Eten0721/PassionFruit_IoT_hardware/docs/CAPTURE_SPEC.md

# 拍攝、檢測與分類規格

## 目標與範圍

本文是系統架構、拍攝、檢測、分類流程、API、command ID、GPIO、角度與 timing 的唯一規格；涵蓋使用硬體與純拍攝兩種拍攝方式，以及蒐集模式的人工分類與自動檢測模式的 YOLO 檢測、XGBoost 判級。現況見 [CURRENT_STATUS.md](CURRENT_STATUS.md)，決策歷史見 [ADR](adr/README.md)。

硬體由 Django 中央狀態機、ESP32、XINHUI `60KG` 分槽送料、HC-SR04、手機單站拍攝、三顆 MG996R 閘門與一顆 MG996R 下置式分類器組成。每顆果實在三個站點各保存一張照片；第 3 張保存後停在 Gate 3，等判級完成、分類器就位才放行，分類完成後才送下一顆。

## 架構與不變原則

### 模組分工

- Django 是 capture、送料與分類狀態的唯一來源，負責工作階段、拍攝 token、照片原子保存、單一 motor command slot 與錯誤復原；不主動呼叫硬體。
- `views.py`：HTTP 整合、模式選擇、狀態機協調與復原決策。
- `runtime_state.py`、`capture_timing.py`、`capture_session.py`、`api_payloads.py`、`webrtc_signaling.py`：各自獨立的狀態、timing、工作階段、回應格式與預覽 signaling。
- `dataset_store.py`：Dataset 檔案生命週期與 recovery marker 讀寫驗證。
- `detection.py`：四模型推論、`result.json`／檢測總表保存與人工接手寫回。`grading.py`：兩階段 XGBoost 特徵與最差視角判級。兩者只回結構化結果，不接觸硬體。
- `notification.py`：加工果通知文字與合成圖。`notification_delivery.py`：持久待送，背景經 Cloudinary／LINE 發送，失敗不影響本地流程。
- Firmware 位於 `firmware/Three_Gate_Data_Collection/`；`.ino` 只建立 `CaptureController` 並呼叫 `begin()`／`tick()`，感測、閘門、分類器、HTTPS 與流程控制分屬各模組。ESP32 是 HTTPS client，所有等待與 retry 都有界，不得阻塞主迴圈。
- 手機頁只負責預覽、相機 readiness、領取單站拍攝請求與上傳；Dashboard 負責運轉控制、狀態、照片檢查、判級與刪除。WebRTC 預覽失敗不得阻塞上傳。

### 不變原則

- 手機與 ESP32 不自行推測流程完成，一律以 Django 為準。
- 當站照片原子保存成功前，不放行下一閘門。
- 第 3 張保存後不直接放行 Gate 3；須有 `gate3_sorter_v1` 且分類器完成就位等待。
- 分類器就位、Gate 3 放行與歸位是同一個 `classify_fruit` 動作；結果不確定時不自動重放。
- 資料先提交再實體分類；硬體失敗不回滾照片、metadata 或 counter。
- 未分類資料、active capture 或 sorter 動作存在時，不開始下一顆。
- 送料由 HC-SR04 回授停止；感測異常或逾時由 ESP32 本機停止；網路 retry 不得重複送料。
- 優雅暫停只禁止後續送料，已送出的果實照常完成。
- 首站加速只縮短控制往返，不縮短停穩或照片保存交握。
- HTTP timeout 視為結果不確定，retry 必須冪等。
- 正式硬體流程沒有通用 manual capture；重拍只重跑同一顆的三站流程。純拍攝全程不建立 motor command。
- AI 只輸出結構化結果，不直接控制 GPIO、角度或 PWM。
- 檢測或判級失敗時不補零硬判；人工結果另記來源，不改寫模型輸出。
- 供電、邏輯電壓與共地安全優先於持續運轉。

## 名詞

- Capture session：一顆果實從觸發至三張照片保存完成的工作階段，包含硬體三站與純拍攝。
- Station ready：ESP32 宣告果實已在指定站點停穩。
- Capture request：Django 通知手機拍攝指定站點。
- Upload complete：Django 驗證並原子保存指定照片。
- 自動運轉：操作員啟用後，Django 只在安全邊界建立下一次送料命令的運轉模式；Django 或 ESP32 重新啟動後不自動恢復。
- 一體式送料筒：同一個圓筒同時提供百香果儲存、底部撥料與側面出料空間；目標內徑為 `20～22 cm`、內部高度為 `30 cm`。
- 分槽送料盤：直立於送料筒底部中央的 XINHUI `60KG` 連續旋轉伺服帶動扭蛋機式分槽盤，將分隔後的果實送向側面出口；槽數、槽寬與盤片間隙由實機驗證決定。
- 出口擋板：位於側面出口上方、限制多顆果實同時靠近出口的固定件；下緣距底板 `9 cm`、向筒內延伸 `9 cm`，側面出口寬度為 `9 cm`。
- 送料循環：XINHUI 連續旋轉伺服從開始驅動至停止的一次 `feed_one` 實體動作；成功契約是實體恰好送出一顆，不以固定角度判定。HC-SR04 只確認有果實抵達，不能計數。
- 感測區清空：HC-SR04 取得一次有效且大於 `8.0 cm` 的距離；`0 cm`／Echo timeout 不是清空。
- 果實抵達確認：送料期間 HC-SR04 取得一次有效且小於等於 `6.0 cm` 的距離；同一筆讀值正常終止送料並啟動首站流程。
- 送料安全逾時：`feeder_max_run_ms` 先於果實抵達確認到期；ESP32 立即停止馬達，Django 暫停自動送料且不得自動補轉。
- 進料未確認：送料因安全逾時、重新啟動或不確定結果停止，但 HC-SR04 尚未確認果實抵達；不得推測為料斗已空。
- 優雅暫停：立即禁止建立後續送料命令，已承諾送出的目前果實仍完成拍攝與實體分類。
- Gate 3 等待分類：第 3 張照片已保存，但 Gate 3 保持 Home、果實仍留在第 3 站，等待 `classify_fruit`。
- Motor command：`feed_one`、`start_sequence`、`release_gate` 或 `classify_fruit`；`release_gate` 以 `station_index` 區分第 1、2 站。
- Command slot：送料、Capture 與 sorter 共用的單一命令槽。

## 裝置網路連線目標

本節為 2026-10-10 討論已接受的需求，Django 與 Firmware 已依此實作；架構取捨見 [ADR-0018](adr/0018-local-network-onboarding.md)，實機驗收狀態見 [CURRENT_STATUS.md](CURRENT_STATUS.md)。

### 部署與日常啟動

- 新電腦首次部署要求可連上網際網路，並自動下載、安裝所需套件；安裝工具與套件封裝另行設計。
- 部署完成後，日常啟動、ESP32 控制、手機拍攝與更換 Wi-Fi 的設定都須能在沒有網際網路的區域網路完成。
- 電腦、ESP32 與相機手機使用網路自動分配的 IP；不要求修改 Windows 固定 IPv4，也不以更換網路或電腦為由重新燒錄 ESP32。現有裝置須先更新一次支援配網的韌體。
- 電腦先由 Windows 連上 Wi-Fi 或有線網路。Django 每次啟動在 Dashboard 頂部先展開可摺疊的網路選擇區，要求操作員確認使用的已連線網路介面，即使只有一個候選；選定後才開放設備操作、開始該網路的裝置探索並顯示相機 QR Code。
- 第一版以 Demo 同一網路只有一台 Django 為範圍，ESP32 每次啟動均優先自動探索控制端；找不到時，Django 顯示目前伺服器網址，ESP32 設定頁允許手動填入作為備援。曾手動填入網址不改變下次啟動的探索優先順序；服務探索採下述本期技術基線；多主機配對不在本期範圍，發現多個有效控制端時停止自動選擇並顯示衝突。

### ESP32 配網

- ESP32 設定熱點使用使用者指定、符合至少 `8` 字元要求的密碼，與目標 Wi-Fi 密碼分開；實際值僅存於不納入 Git 的私密設定，不寫入規格。密碼已於討論定案，韌體仍須驗證設定值並明確回報熱點啟動失敗。

- 採不接 USB 的設定熱點方式；無已存 Wi-Fi 設定時自動開啟，已有設定時由正常開機後按一下板上 BOOT 進入。BOOT 腳位須依實際板型核對；按鍵需通過去抖與安全閒置檢查，不在按住 BOOT 上電或重置時配網。
- 使用電腦或相機手機連入設定熱點，由 ESP32 本機提供獨立設定頁，選擇目標 Wi-Fi 並輸入密碼；不依賴 Django Dashboard 可連線。短暫斷線先重試既有設定，不自動清除設定。
- 成功加入目標 Wi-Fi 並取得 IP 後保存設定，設定頁啟用「退出連線」按鈕；按下後才關閉設定熱點，保留對目標 Wi-Fi 的連線，不要求再次按 BOOT，也不等待 Django 上線或網際網路可用。
- 密碼錯誤或連線逾時時保留設定熱點，允許修改、重試。不需變更時可按設定頁「取消設定」或再按一下 BOOT，關閉熱點並恢復已保存的 Wi-Fi；已有保存設定時，設定頁閒置逾時也會自動取消，不讓無人操作的熱點卡住機台。設定端在熱點關閉後切回目標 Wi-Fi；不保證手機或電腦會自動切回。
- 只允許安全閒置時進入配網；送料、拍攝或分類途中按 BOOT 不切換網路，須等本輪完成或人工安全復原後再操作。Dashboard 底部以獨立的「ESP32 網路設定」摺疊區（`dashboard.html` 的 `network-setup`）顯示配網狀態、阻擋原因、按一下 BOOT 的操作指引，以及固定指向 `http://192.168.4.1/` 的設定頁 QR Code（`/api/network/setup_qr.svg`，不需先選網；只在手機已連上設定熱點時可開啟）；ESP32 離線時顯示無法確認，不宣稱可安全配網。

### 手機加入與斷線恢復

- 相機的操作目標為：Django 顯示依所選介面目前位址產生的相機 QR Code → iPhone 使用 Chrome 開啟 → 允許相機 → 傳送影像。維持 HTTPS 與既有相機頁；不把安裝手機信任憑證預設為必要步驟。三站間距 `19 cm` 時主鏡頭視角不足，相機頁取得權限後列出所有鏡頭供操作員選擇，選擇以 `localStorage` 記在該手機；未選過時自動選標籤含「Ultra Wide／超廣角」且不含「Front／前置」的鏡頭，找不到或開啟失敗時退回 `facingMode: environment`。拍攝中不允許切換；實際鏡頭名稱顯示於相機狀態與診斷 `videoTracks[].label`。
- 電腦所選介面的 IP 改變後，Django 更新相機 QR Code，ESP32 重新探索控制端；手機由操作員重新掃碼加入，不要求跨位址自動遷移。若已觸發失聯復原鎖，仍須處理本輪並人工重新開始。
- 接受首次使用新位址可能出現憑證警告並需額外確認，以實機結果為準；目前 Chrome 成功經驗不代表新 IP、新電腦或新手機均可用。憑證策略與 Safari 支援尚未定案。
- 短暫請求失敗沿用既有有界、冪等重試；一次 HTTPS timeout 不直接判定裝置失聯。只有連續失敗超過失聯門檻後，才鎖定人工復原並跳過未完成的本輪；各裝置採下述本期門檻。
- 確認失聯後採安全停止、自動重連、人工確認重新開始；送料馬達由 ESP32 在本機送出已校正的停止脈波，閘門與分類器維持最後已下達的目標角度，不再下達後續放行、分類或歸位命令。位置型伺服沒有回授，此行為不保證立即停在失聯當刻的實體位置；安全鎖須阻止重連後續跑原動作。
- 人工復原沿用 Django 既有介面；重連本身不得自動恢復實體流程。停止策略不能取代既有本機感測與最大運轉時間保護。
- 拍攝中斷的當前果實採跳過：由操作員刪除本輪暫存資料並依既有安全程序移除實體果實，不自動續拍剩餘站點，也不重拍此顆。資料刪除不代表果實已移除，清理與人工復原完成後才可重新開始；已提交的資料沿用本文既有不回滾契約。
- WebRTC 僅為預覽，手機 readiness 與正式照片上傳沿用本文既有契約；預覽中斷不能直接等同手機拍攝服務失聯。優雅暫停與斷線安全停止也須分開處理。

### 本期技術基線

本節為已實作的工程方案；上述已接受操作需求優先，以下數值已於 2026-10-27 實機驗收。行為與協定只在本文維護，GitHub 規格 Issue 引用本文並追蹤交付。

#### Django 網路選擇與探索

- 維持 Windows、單一 Django 程序與 `runsslserver 0.0.0.0:8000`；從本機 Dashboard 完成選擇。優先以 `--noreload` 執行 Demo；若保留 autoreload，只有實際 serving process 可以持有探索／監測資源，reload 後必須重新確認。測試、migration、import 不啟動網路執行緒。
- 用標準函式庫以有界 subprocess 讀取 Windows PowerShell 網路介面 JSON，列出 Up、具有效 IPv4 的 Wi-Fi／Ethernet 介面名稱、介面 ID、位址與 prefix；排除 loopback、未連線與不可用位址。保留介面 ID 與所選位址，不猜測固定熱點或以連外 DNS 判定網路。讀取失敗回 `network_inventory_failed`，無候選回 `no_connected_network`，不能偷偷使用預設介面。
- `GET /api/network/` 回候選介面、選擇狀態、`server_run_id`、`network_revision`、`server_url`、`camera_url`、`qr_url`、探索狀態與配網可用原因；`POST /api/network/` 只接受已列出的介面 ID／IPv4，重讀並確認仍可用。未選定時，設備／拍攝操作回 `409 network_selection_required`，允許狀態讀取、網路設定、既有資料檢查與必要清理；UI disabled 不取代後端檢查。
- 選定後以 `python-zeroconf` 僅在所選 IPv4 註冊 `_pf-iot._tcp.local.`，SRV port 使用實際 HTTPS port，A record 為所選位址；TXT 含 `api_version=1`、`scheme=https`、`server_run_id`、`network_revision`、`info_path=/api/network/info/`。`GET /api/network/info/` 回同一份身分、選擇狀態與目前 URL，供 ESP32 確認目標；mDNS 結果只是探索線索，不能授權實體動作。設備請求須使用所選 origin 且來源在所選 IPv4 subnet；本機 Dashboard 可由 loopback 操作。這是網路範圍限制，不是裝置身分驗證。
- 新增 `zeroconf` 與支援 SVG 的 `qrcode` 兩項必要套件，實作時核對並固定 PF／Python 相容版本。`GET /api/network/qr.svg` 的 QR Code 在 Django 本機產生且禁止快取，內容為所選 IPv4／HTTPS port 的 `/camera/`，不使用 localhost、Dashboard request host、外部 QR API 或要求手機能解析 `.local`。
- Django 每秒監測所選介面。相同介面只換 IP 時先關閉舊探索、使舊工作與網址失效，再更新 revision、URL、QR 並重新註冊；運轉中套用失聯復原鎖。介面消失或操作員選擇另一介面時，回到待確認且不接受新動作；人工切換只允許安全閒置。解除舊註冊、socket、thread 與暫時資源須有 cleanup；資源建立失敗顯示具體 reason，不偽裝成功。
- 服務探索失敗不等於 HTTPS 不可用：保留手動網址備援並明示探索不可用。Windows 須允許 Django HTTPS TCP port 與 mDNS UDP `5353`；不自動關閉防火牆。要求裝置彼此可達的 `2.4 GHz` Wi-Fi，手動網址也無法繞過 AP client isolation；企業登入入口、僅 `5 GHz` 與阻擋裝置互通的訪客網路不在支援範圍。

#### ESP32 配網與控制端識別

- 沿用 Arduino core 的 `WiFi`、`WebServer`、`Preferences`、`ESPmDNS`，不為配網另引入 WiFiManager。目標網路使用 DHCP；固定的 ESP32 設定熱點網址只用於自身配網，不是 Django 位址。設定熱點名稱帶裝置識別尾碼，頁面資源全在 Firmware，使用 `http://192.168.4.1/` 並顯示切回目標 Wi-Fi 的指引，不依賴 captive portal 自動彈出。
- BOOT 以 active-low 與 `50 ms` 去抖判定，每次按下只提出一次配網請求；開機後須先放開按鍵；使用 `esp32:esp32:esp32` 的 GPIO `0`。只在無送料、Capture、Gate 3 待處理、sorter、命令或未清理果實的安全閒置開 AP；無已存設定且正常初始化完成時自動開 AP。已發生帶果實的安全鎖不能用 BOOT 繞過；從未進入實體流程、僅舊 Wi-Fi 不可達的閒置裝置仍可重新配網。
- 進入設定模式先停用自動 trigger／新命令，使用 AP+STA 非阻塞嘗試新 Wi-Fi。已連線時以 heartbeat 的 `motion=setup` 請求中央保留安全閒置；中央回 `setup_allowed=1` 後才開 AP，期間拒絕新硬體操作，配網完成後以一般狀態回報解除保留。離線只在本機安全閒置且未保留中央阻擋時允許 BOOT 配網。拒絕時 Serial 印 `setup_blocked: <原因>`（中央拒絕為 `central_setup_blocked`），請求帶 `setup_block_reason`，Dashboard 顯示 `esp32_not_idle:<原因>`。Dashboard「開啟 ESP32 設定熱點」（`POST /api/network/setup_request/`，僅本機 Dashboard）只在配網狀態為 allowed 時接受，於 `15 s` 內以控制欄位 `setup_requested=1` 交給 ESP32；ESP32 視同按 BOOT，仍做本機安全閒置檢查與 `motion=setup` 中央許可，回報 `motion=setup` 或不可配網時中央即清除請求。頁面提供非阻塞 SSID 掃描、SSID／密碼、可選手動 Django HTTPS origin 與連線結果；允許直接輸入 SSID。設定頁所有 endpoint 只接受從設定熱點介面進來的請求，目標區網來源回 `403 setup_ap_only`。AP 跟隨 STA 頻道，開 AP 時停止 STA 的背景重連，連線新 Wi-Fi 時以掃描結果的頻道為提示，減少手機被切出熱點；設定頁斷線時提示重新連上熱點。POST 驗證 SSID 長度與 Wi-Fi 密碼格式，密碼不用 query string、回應、log 或 QR；手動 origin 只接受有效 IPv4、HTTPS 與合法 port，不接受 userinfo、任意 API path 或外網位址。
- 候選設定先留 RAM，送出後須收到新的 STA `GOT_IP` 事件並取得目標 Wi-Fi 的有效 IP，才以一筆帶 schema version 的 Preferences 設定記錄保存；不以送出前殘留的舊連線狀態判定成功。檢查寫入結果，失敗不覆蓋上一份可用設定、不關 AP。Wi-Fi 嘗試 `15000 ms` 逾時，成功且保存完成後持續顯示結果與保留 AP，直到設定頁以 `POST /exit` 手動退出；僅在保存完成且目標 Wi-Fi 仍連線、有有效 IP 時接受，否則回 `409 setup_exit_unavailable`。退出回應後只關 AP、保留 STA，等待退出期間不恢復硬體控制。已保存後掉線回 `connecting` 與 `wifi_connection_lost`，保留 AP 與 NVS 並主動重連已保存設定。`POST /cancel` 或 BOOT 隨時取消設定：取消回應後關 AP，丟棄未保存的候選設定，恢復已保存 Wi-Fi，重複請求回 `409 setup_cancel_unavailable`；已有保存設定且設定頁 `600000 ms` 無請求時以 `setup_idle_timeout` 自動取消。無已存設定時不因閒置自動關閉。錯誤回 `wifi_connect_timeout`、`wifi_auth_failed`、`wifi_ssid_not_found`、`wifi_configuration_invalid`、`wifi_config_save_failed` 或 `setup_ap_failed`，允許修正再試；認證失敗與找不到 SSID 依 STA 斷線原因立即結束嘗試，其他原因等滿逾時。保存不以 Django／Internet 上線為條件。
- 設定熱點密碼由 ignored `setup.local.h` 提供，範本為 `setup.example.h`；缺少有效密碼或 softAP 啟動失敗回 `setup_ap_failed`，不開放無密碼 AP；之後的 Django 請求帶 `setup_failure=setup_ap_failed`，Dashboard 配網狀態顯示此原因，直到下一次成功開 AP。無已存設定時每 `30000 ms` 重試自動開 AP。不把實際值放進 Firmware example、文件、Issue 或 log；禁止會輸出 WebServer POST 內容的 Verbose debug build。目標 Wi-Fi 密碼保存在裝置 NVS，第一版不聲稱具備抵抗實體 Flash 讀取的加密保護。一般重試不清空 NVS；更換網路不需重新燒錄。
- 每次啟動、Wi-Fi 重新加入或控制端確認失聯後，先用 mDNS 找 `_pf-iot._tcp`，再查詢網路資訊確認版本／身分與 URL。首輪探索最多 `15000 ms`，期間不啟動動作；找不到才試已存手動 origin，仍持續有界背景探索。多個有效控制端回 `multiple_controllers_found` 而不任選；已選定健康控制端不因背景發現別台而遷移。
- 指向本次探索或手動驗證的 HTTPS origin 加上既有 command／report routes，移除編譯時固定 Wi-Fi 與完整 API URL 的依賴。本期沿用既有 ESP32 `setInsecure()`，不宣稱驗證 HTTPS 伺服器憑證或抵抗區網偽冒，僅適用可信任、隔離區網；正式裝置驗證另案設計。控制端、網路 revision 或 `boot_id` 改變使舊 lease 與舊動作失效；未完成流程須人工復原，不能將 report 或 command 重送到另一控制端後繼續。

探索診斷沿用以上身分契約。`GET /api/network/info/?format=text` 將版本、scheme、selected、身分與 URL 回為逐行 `key=value`；預設 JSON 仍保留。ESP32 核對 TXT 與 info 的身分及 origin，再用同一 origin 的既有 routes；診斷模式不領取實體命令：

- `GET /api/esp32/command/?diagnostic=1` 攜帶 `boot_id`、`server_run_id`、`network_revision`、`discovery_source=mdns|manual` 與 `discovery_reason`；回逐行文字、`diagnostic_id`、`command=none`、`control_allowed=0`，不領取 motor command 或刷新正式硬體 readiness。
- `POST /api/esp32/report/` 的 `event=network_probe` 回傳相同身分與 `diagnostic_id`；相符往返完成才顯示診斷連線，最後成功 report 超過 `6000 ms` 則顯示離線。診斷 HTTP 除既有階段 timeout 外，各有 `7000 ms` 總等待上限；首輪 info 驗證另受共同的 `15000 ms` 絕對截止限制，晚到結果無效。
- 多控制端時不選定 origin、不試手動備援；只向已驗證的前兩個候選各回報 `event=network_discovery_status`、身分與 `discovery_reason=multiple_controllers_found`，供 Dashboard 顯示衝突，且不標記已連線。後續探索確認衝突消失後才重新選擇。
- 正式 Firmware 的 Wi-Fi 與手動 origin 由設定頁保存至 NVS，不再讀取 `secrets.h`；每次加入 Wi-Fi 都先探索。ignored `network.local.h` 僅作診斷模式／host adapter 備援。配網 HTTP、NVS、首輪探索與 Django HTTP 都在既有單一網路 worker；worker 固定在 core 0、與控制迴圈分核，STA 重試只由 worker 排程，不同時啟用 core 自動重連，並記錄 stack 最低剩餘量供調整大小。診斷模式不宣告 `local_network_v1`，正式控制模式依下列安全交握接受命令。

#### 失聯門檻與安全交握

| 項目 | 本期基線 | 判定 |
|---|---:|---|
| Django／ESP32 keepalive | `1000 ms` | 動作中也持續，不以 command polling 是否閒置判定健康 |
| ESP32 控制 lease | `6000 ms` | 自最近有效請求的送出時間起算；逾期鎖定，不以單次 timeout 判定 |
| ESP32 Wi-Fi link 持續中斷 | `1000 ms` | 本機確認後立即安全停止，不等待重新探索或 Django |
| Django ESP32 失聯 | `6000 ms` | 自最後有效 keepalive／command／report 接收時間起算；取代本期控制路徑的舊 online window |
| 相機 readiness | `5000 ms` | 沿用目前契約，過期立即禁止開始新送料／拍攝 |
| 相機確認失聯 | `10000 ms` | 曾加入且正在使用的相機持續無 ready，鎖定人工復原；未加入不產生本輪失聯事件 |
| Django 監測／ESP32 停止反應 | `1000 ms`／`100 ms` | Django 最遲下一監測週期鎖定；ESP32 在本機門檻到期後至停止輸出之延遲目標 |

- ESP32 在既有 command／report 攜帶 `network_capability=local_network_v1`，另以 `GET /api/esp32/heartbeat/` 在動作中取得狀態，heartbeat 不領取／建立 motor command。缺少 `local_network_v1` 時，Django 回 `network_capability_missing` 並禁止硬體運轉，不因既有 feeder／sorter capability 而放行。Django 控制回應含 `server_run_id`、`network_revision`、`boot_id`、`recovery_generation`、`control_allowed` 與 `control_lease_ms`；裝置同時回報本機安全鎖、當前動作及可否配網。Django 只對相符裝置／版本的有效回應續期；`control_allowed=false` 立即鎖定。優雅暫停允許目前果實完成，不以它關閉目前動作 lease；未選網路、確認失聯與復原鎖則關閉。
- HTTP `2xx`、mDNS 回應或 Wi-Fi 有 IP 均不能單獨續 lease，須驗證回應身分與控制欄位。請求送出時間、裝置身分與 generation 一併鎖存；較早請求的延遲回應、舊 revision、舊 generation 或鎖定前回應不得解除鎖或延長期限。Django 先判斷舊 heartbeat 是否已超門檻再更新，避免第一筆重連請求掩蓋中間失聯。只有本輪操作或自動運轉曾成立才產生操作中斷鎖；啟動等待連線與安全閒置可配網須獨立表示。
- 不沿用會阻塞控制 `tick()` 的同步 HTTPS 路徑：由單一有界網路 worker 處理 HTTPS／探索，以一筆 in-flight request 與結果回交；控制迴圈唯一持有 GPIO／servo／安全狀態，網路 worker 不驅動馬達。keepalive 優先於一般 retry，每次 HTTP connect／read 使用有界 timeout；網路 worker 卡住也不能阻止控制迴圈判斷 lease、HC-SR04 或最大送料時間。實作須量測最壞 loop 間隔，確認上述停止反應目標。
- Django 獨立監測即使 Dashboard 關閉仍執行，並在開始、trigger、command、report、照片保存及分類等既有入口共同以 `STATE_LOCK` 檢查安全狀態。純拍攝只依相機與所選網路判斷，不因 ESP32 缺席鎖定；WebRTC 預覽狀態不刷新／撤銷拍攝 readiness。
- 確認失聯時：關閉 auto run／auto trigger、取消未執行命令與後續 phase、撤銷 capture token，保持已保存暫存照片供人工刪除；ESP32 先寫校正停止脈波，再取消分類器／閘門 phase，禁止 timeout 的 HomeAll。中斷命令只能回報 aborted，不回 completed，不因重連重新執行；舊 report 可被冪等確認但不能建立新拍攝、放行或送料。
- 沿用既有原子 recovery marker 的寫入方式，保存網路失聯的 fruit／command／boot／控制端身分、reason 與 recovery generation；Django 重啟恢復鎖，ESP32 在確認失聯時以 NVS 保存 interlock 與當次校正停止脈波，重啟先恢復鎖及停止值，不能自行解除或自動歸位。保存失敗保持記憶體鎖與動作停用並回 `recovery_persist_failed`，不得宣稱復原完成。
- 人工先刪除／隔離本輪暫存資料，再依斷電程序移除果實、確認手已離開，最後於既有主操作區明確確認復原。沿用 `recovery_confirmed=true`，新增同一 command slot 的 `recover_network` 安全歸位交握，附當前 recovery generation；ESP32 只接受人工授權後的新交握，保持送料停止，依既有停穩時序歸位並回 `network_recovery_completed`。Django 在歸位／提交階段回 `recovery_allowed=true`，僅授權復原且 `control_allowed=false`。收到相符完成 ACK 後，Django 原子保存提交階段並回 `recovery_commit=true`；ESP32 先保存本機提交狀態且維持鎖，再回 `network_recovery_committed`。Django 原子保存清鎖與 generation／完成 receipt，回 `recovery_committed=true`；ESP32 收到此回應且清鎖保存成功後才可送料，Django 也只在全部開始條件成立時建立新的 `feed_one`。重複 ACK 只重送結果、不重做歸位；失敗／再次失聯／舊 ACK 維持鎖，撤銷交握後可接受新的人工授權。資料鎖在任何模式都須先清理本輪暫存資料並明確確認；純拍攝沿用拍攝開始入口確認，且不建立 motor command。馬達鎖可保留並切到純拍攝工作，切回硬體後仍須歸位交握；硬體復原只要求清理資料、已選網、ESP32 在線與人工安全確認，不要求手機相機、HC-SR04 或設定同步，正式開始仍檢查這些條件。復原確認原因由 `network_recovery_confirm_disabled_reason` 提供，正式開始原因由 `auto_run_disabled_reason`／`photo_capture_disabled_reason` 提供。每次有效裝置請求含鎖中的命令輪詢、heartbeat 與 report 都更新其回報的能力、感測、feeder state 與 interlock；這些裝置狀態不保存，Django 重啟後視為未知。鎖種類與集中政策見 [ADR-0020](adr/0020-single-network-recovery-policy.md)。
- 無 active fruit 不代表沒有待移除實體果實；中斷分類時已提交資料維持不回滾，仍須人工移除。檔案刪除失敗沿用既有隔離／deferred cleanup，阻擋原因顯示清楚。資料鎖期間只開放刪除／跳過暫存資料與 LINE 通知開關，阻擋停穩設定、送料校正與模式切換；馬達鎖只限制硬體操作，允許切到純拍攝並保留鎖。鎖住但沒有進行中的操作，且不在 `homing`／`committing` 交握中時，允許重新選網，供 Django 重啟後復原；選網不改變鎖種類、phase 或 generation，網路身分變更仍依既有安全檢查處理，不得解鎖。任何鎖存在時仍禁止 Dashboard 開熱點請求；連線觀察、診斷與相符復原 ACK 仍可用，復原須明確人工確認。
- 所有門檻先於本輪下一個實體輸出檢查。分類正常時序短於失聯門檻，確認失聯前已完成的動作不能倒轉或宣稱被阻止；本期保證的是確認失聯後不再下達後續動作，須在各 phase 分別驗收。

#### 手機與離線驗收前提

- 沿用 HTTPS／Chrome／相機啟動按鈕與權限流程。先驗證既有憑證在新電腦／IP 的 `isSecureContext`、`getUserMedia` 及照片上傳；若只接受警告仍無法使用，回 `camera_secure_context_required` 並記錄阻礙，不能以換 Chrome 宣稱解決憑證信任，也不擅自加入手機安裝憑證流程。
- Dashboard 與相機兩端 WebRTC 使用一致的本機 ICE 設定，不依賴外部 STUN／TURN；靜態檔、QR、探索與 signaling 都由區域網路提供。區網 ICE／瀏覽器 host candidate 仍須實測，預覽失敗必須獨立顯示並允許正式照片採集。
- 畫面分開顯示網路已選擇、ESP32 已連線、相機可拍攝與 RTC 預覽，避免用單一「已連線」判斷可運轉。

## 硬體設定

正式 Firmware：`firmware/Three_Gate_Data_Collection/Three_Gate_Data_Collection.ino`

| 裝置 | GPIO | 目標設定 |
|---|---:|---|
| Gate 1 position-control MG996R | `18` | Home `0°`，Release `90°` |
| Gate 2 position-control MG996R | `19` | Home `0°`，Release `90°` |
| Gate 3 position-control MG996R | `21` | Home `0°`，分類器就位後才 Release `90°` |
| Upstream feeder XINHUI `60KG` continuous rotation | `23` | HC-SR04 回授停止，最大運轉時間安全保護 |
| HC-SR04 Trigger | `26` | `10 us` pulse |
| HC-SR04 Echo | `27` | `12000 us` timeout，輸入必須安全降壓 |
| Position-control MG996R sorter | `25` | Home `160°` |

三站閘門先沿用直接寫入 `0°／90°` 的控制方式，實際角度須以無干涉且能穩定推動果實的實機結果為準。新平台若仍發生夾果或過度推擠，再依 Issue [#16](https://github.com/Eten0721/PassionFruit_IoT_hardware/issues/16) 評估非阻塞小角度遞增；該觀察不阻擋 Gate 3／分類器複合流程。若後續實作慢速控制，必須使用 deadline 推進，不能以長時間同步迴圈阻塞 HTTPS、感測與安全停止。

送料方向由馬達安裝位置及 `feeder_drive_us` 位於校正停止值的哪一側共同決定，Firmware 不固定順時針對應的脈波側。正式流程不提供反轉清料、位置 Home 或自動補轉；更換馬達位置或修改驅動脈波後必須重新測試送料。

XINHUI `60KG` 送料馬達直立於筒底中央並帶動分槽送料盤。送料筒頂部保持開放；馬達底座旁保留線材孔，線材直接離開送料筒，筒內不得留下鬆弛線圈或接頭。分槽盤下緣不得摩擦底板，外緣不得碰觸筒壁；槽數、槽寬、盤片厚度、垂直間隙、筒壁間隙與舵盤固定方式均須以最大果實尺寸及連續送料結果驗證。

側面出口直接對齊拍攝平台起點，不另設導料斜道；出口底部與拍攝平台起點的高低差為 `8.5～9 cm`。現階段受可取得果實數量限制，只以 `10` 顆驗證裝載能力；超過 `10` 顆與正式安全填料線均維持未驗證，不使用未量測的「滿載」作為驗收條件。

下置式分類器位於平台出口正下方，平台末端使用名目直徑 `10 cm` 的落料管，圓形舵盤上的ㄇ型鐵帶輕微坡度並導向四個籃子。位置型 MG996R 分類位置：

| 中文分類 | Command code | 角度 |
|---|---|---:|
| 上等 | `high` | `140°` |
| 中等 | `medium` | `150°` |
| 下等 | `low` | `170°` |
| 加工 | `processing` | `180°` |

上表與分類器 Home `160°` 為 2026-10-27 實機值，保存於 `hardware_params.toml`；Firmware 預設為 Home `45°`、`15°／30°／60°／75°`。可在 `Django_Server/hardware_params.toml` 調整三站與分類器 Home 及四個分類角度（`0～180°`，三站 Home 不得等於放行角度 `90°`）。ESP32 在閒置且四顆馬達已歸位時套用，角度有變更就先移到新 Home 並等待 `500 ms`；ESP32 重開機後會先回到 Firmware 預設角度，等 Django 重新下發設定。

Firmware 可接受舊輸入 alias `high_medium` 與 `discard`，分別套用上等與中等的新角度；Django 與新決策層不得再產生 alias。分類器收到目標角度後先以開迴路方式等待 `500 ms`，再將 Gate 3 直接放行至 `90°`；從 Gate 3 到達 Release 後計時，分類器在目標角度保持 `1000 ms`。落果等待完成後，三顆 Gate 同時回 Home `0°`，分類器同時回 Home，共同歸位等待 `500 ms` 後才可回報完成。MG996R 沒有位置回授，這些等待只代表控制時序完成，不證明實際位置。複合動作 timeout 必須涵蓋分類器轉向、Gate 3 放行、落果保持與四顆馬達歸位，最終值由實作與實機量測決定。

伺服供電使用一顆 `AC 110 V → DC 12 V／20 A` 電源供應器，並接供應兩顆 LM25116 的輸入。分支 A 初始降至 `6.0 V`，供三站與分類器四顆 MG996R，且不得超過 `6.6 V`；分支 B 降至 `8.4 V`，只供 XINHUI 送料馬達。兩顆模組的輸出正極不得互接，電源 DC 負極、兩顆模組 GND 與 ESP32 GND 必須共地。完整配線、安全與負載估算見 [`record_image/電源供應器接線注意事項.md`](../record_image/電源供應器接線注意事項.md)。

HC-SR04 觸發距離為 `6.0 cm`，重新待命距離為 `8.0 cm`，讀取間隔為 `50 ms`。一次有效觸發即可立即停止送料；只有有效距離大於 `8.0 cm` 才可重新待命。`0 cm`／Echo timeout 代表感測器異常或線材問題，送料前必須拒絕命令，送料中必須立即停止。Echo 分壓、伺服供電與機械驗收見 [`record_image/電源供應器接線注意事項.md`](../record_image/電源供應器接線注意事項.md)。

## 硬體參數

| 設定 | 推薦值 | 允許範圍 |
|---|---:|---:|
| `first_station_settle_ms` | `500 ms` | `50～3000 ms` |
| `servo_settle_ms` | `500 ms` | `50～3000 ms` |
| `fruit_settle_ms` | `500 ms` | `50～3000 ms` |
| `final_gate_return_delay_ms` | `500 ms` | `0～3000 ms` |
| `idle_command_poll_interval_ms` | `250 ms` | `100～5000 ms` |

上述拍攝值必須為 `50 ms` 的倍數。送料參數與拍攝值放在同一份檔案、共用 revision：

| 設定 | 推薦值 | 允許範圍 | 間距 |
|---|---:|---:|---:|
| `feeder_stop_us` | `1500 us` | `1400～1600 us` | `5 us` |
| `feeder_drive_us` | `1300 us` | `1000～2000 us` | `10 us` |
| `feeder_max_run_ms` | `5000 ms` | `1000～20000 ms` | `500 ms` |

`feeder_drive_us` 不得等於 `feeder_stop_us`，但不限制兩者差值或驅動脈波位於停止值的哪一側。`feeder_max_run_ms` 是唯一運轉上限；Dashboard 與 Firmware 不得另設隱藏上限或靜默截斷。參數檔在該欄位註解中保留「若設定過長將導致連續送料之情形發生」警告。

八項參數只來自 `Django_Server/hardware_params.toml`（決策見 [ADR-0023](adr/0023-file-based-hardware-params.md)）。Django 只在啟動時讀取並驗證上表範圍、間距與脈波規則；檔案遺失、TOML 格式錯誤、出現未知欄位或數值不合法時拒絕啟動，分別回報 `hardware_params_missing`、`hardware_params_invalid_toml`、`hardware_params_unknown_field` 或對應的 `capture_timing_*` reason。執行中沒有修改 API；修改後必須重新啟動 Django。ESP32 只在 idle、沒有 sequence／pending report、三閘門 Home 且送料馬達停止時套用，再回報 `timing_config_applied`。

`runtime_config/hardware_sync.json` 原子保存已驗證參數、wire revision 與該版本的 ACK；它是同步紀錄，不取代 TOML 設定來源。首次遷移以 `1000000 + 舊內容 CRC revision` 建立高於舊範圍的新版本；後續內容相同則保持版本，內容修改或回復舊值則取前版加一與新內容初始版本兩者較大值。版本必須小於 `2147483647`，紀錄損壞或版本耗盡時拒絕啟動，不靜默降回較小版本。只有相符的真實 `timing_config_applied` 才保存 `{boot_id, revision, applied_at}`；保存失敗回 `503 hardware_sync_save_failed`，維持未確認並讓 ESP32 重試。Django 重啟先視為未知，收到通過既有網路身分檢查且 boot 相符的裝置請求後才恢復 ACK；不同 boot 或新版本須重新回報。此紀錄不得用來恢復自動運轉、解除復原鎖或建立 motor command。

每顆 fruit 開始時 snapshot 前四項拍攝機構 timing；每次建立 `feed_one` 時 snapshot 三項送料設定，流程中不得覆寫。

完整機構驗收仍先在空送料筒確認停止脈波沒有爬行，再放入 `10` 顆，連續執行 `10` 次測試且不補回已送出的果實，覆蓋剩餘量由 `10` 顆降至 `1` 顆的情境。驅動脈波由 `1300 us` 起測，校正為能可靠帶動分槽盤且不造成雙送的最慢值；最大運轉時間由操作員依實測結果自行指定，系統只驗證它位於 `1000～20000 ms` 且為 `500 ms` 的倍數，不套用自動計算公式。每次都必須由 HC-SR04 正常停止並目視確認恰好送出一顆；任一次漏送、雙送、卡料、分槽盤停滯或安全逾時都要在調整後將同一批果實放回，從 `10` 顆重新累計。測試模式不得建立 Capture session。超過 `10` 顆的裝載量必須重新校正與驗收。

完成十顆送料後，必須在空送料筒至少執行一次完整逾時測試。操作員不得提前中止該次測試；ESP32 必須在指定的 `feeder_max_run_ms` 到期時先於本機停止，回報 `feeder_max_run_timeout`，Dashboard 顯示進料未確認，且不得建立 Capture session 或自動補轉。其他空筒情境仍等待 HC-SR04 或最大運轉時間停止；Dashboard「停止拍攝」（優雅暫停）只禁止後續送料，不中止目前 `feed_one`。

修改送料脈波或最長運轉時間後，維護者應先用「測試送料一顆」目視確認恰好送出一顆；系統不保存也不要求這項確認。ESP32 尚未 ACK 最新 revision 時不得測試送料或開始正式運轉；ACK 與其餘開始條件皆成立後，Dashboard 才開放「開始拍攝」。

其他 interval 與 request deadline：

| 行為 | 值 |
|---|---:|
| 等待 `start_sequence` polling | `100 ms` |
| 等待 `release_gate` polling | `50 ms` |
| 自動 trigger／首站捷徑 request | `1000 ms` |
| Command GET | `1500 ms` |
| 一般 station report | `5000 ms` |
| 手機 idle／active／busy polling | `250 / 50 / 250 ms` |
| 手機 state request timeout | `1000 ms` |
| 相機 ready heartbeat freshness | `5000 ms` |
| Sorter pending／running deadline | 各 `30 s` |

伺服移動、果實停穩與 report pending 階段不輪詢 command。Wi-Fi、HTTPS、感測、伺服 phase 與 retry 必須使用 deadline；timeout 或 `Connection: close` 後關閉並安全重建 client。

## API

| Method | Path | 用途 |
|---|---|---|
| `GET` | `/api/state/` | Dashboard 完整狀態 |
| `GET` | `/api/camera/state/` | 手機精簡 capture state 與相機 ready heartbeat |
| `POST` | `/api/camera/diagnostics/` | 手機相機狀態改變時的旁路診斷上報 |
| `POST` | `/api/collection_options/` | 安全閒置時選擇工作與硬體模式 |
| `POST` | `/api/photo_capture/` | 僅純拍攝可用的單輪三張入口 |
| `POST` | `/api/auto_run/` | 啟用正式自動運轉或要求優雅暫停 |
| `POST` | `/api/feeder/test/` | 在安全 idle 狀態測試一次 HC-SR04 回授送料 |
| `POST` | `/api/runtime/reset/` | 開發者完全重置 Django 狀態與 Django 端網路設定 |
| `POST` | `/api/capture_started/` | Best-effort 拍攝 telemetry |
| `POST` | `/api/upload_images/` | 上傳指定站點照片 |
| `GET` | `/api/esp32/command/?format=text` | ESP32 取得 motor command |
| `POST` | `/api/esp32/report/` | ESP32 回報 trigger、station、完成或失敗 |
| `POST` | `/api/discard/` | 跳過／刪除目前暫存果實 |

分類、刪除、重置、人工判級與檢測的資料鎖（`dataset_operation`）不論成功、預期失敗或未預期例外都必須釋放。進入 `uploading` 後寫檔超過 `30 s` 轉為 `upload_timeout` error，保留已存照片並開放刪除；遲到的上傳完成回 `409 capture_state_changed_during_upload`。

`POST /api/runtime/reset/` 只接受本機 Dashboard（否則 `409 network_local_dashboard_required`），用於狀態卡死時的開發者逃生：清空記憶體中的 capture、command、資料鎖、自動運轉與 ESP32 裝置狀態，取消已選網路並刪除 `network_recovery.json`；照片、Dataset、檢測結果、counter 與 sorter／Gate 3 復原紀錄保留，並如同 Django 啟動般從檔案恢復。不送出任何 motor command；ESP32 的 NVS 失聯鎖不受影響，仍鎖定時下一次回報會讓 Django 重新上鎖。刪除復原紀錄失敗回 `503 recovery_persist_failed`。

`/api/camera/state/` 禁止快取且只讀記憶體狀態與套用 session timeout，不得掃描 Dataset 或同步 metadata／counter。手機 polling 必須 single in-flight；頁面進入背景時停止，回到前景才重啟。只有相機 stream 存在、video track 為 live、已有可擷取影格與有效尺寸時，手機才在 polling query 回報 `camera_ready=1`；Django 只在記憶體保存最後 ready 時間。每次 upload 必須帶 `fruit_id`、`capture_token` 與 `station_index`。

`POST /api/camera/diagnostics/` 接受最多 `4096 bytes` 的 JSON object，網路身分檢查沿用相機 state API；不符回 `409` 與原網路原因碼，不保存。成功回 `200 {"ok": true}`。白名單如下，除 `event` 必填外皆選填，省略或 `null` 均保存為 `null`：

| 欄位 | 可接受值 |
|---|---|
| `event` | `camera_started`、`camera_failed`、`track_ended`、`rtc_state_changed` |
| `secure_context`、`get_user_media_available`、`track_muted` | JSON 布林 |
| `permission` | `granted`、`NotAllowedError`、`NotFoundError`、`NotReadableError`、`OverconstrainedError`、`SecurityError`、`AbortError`、`TypeError`、`unknown` |
| `video_track_state` | `live`、`ended`、`none` |
| `rtc_connection_state` | `new`、`connecting`、`connected`、`disconnected`、`failed`、`closed` |
| `rtc_ice_connection_state` | `new`、`checking`、`connected`、`completed`、`disconnected`、`failed`、`closed` |
| `video_width`、`video_height` | `0–10000` 整數，布林不算整數 |
| `last_live_frame_age_ms` | `0–86400000` 整數，布林不算整數 |

白名單外的鍵直接丟棄，不保存、不回傳、不記錄內容；白名單值不合法、缺少 `event`、非 JSON object 或超量時，回 `400 {"ok": false, "reason": "camera_diagnostics_invalid"}`，舊資料不變。伺服器在 `STATE_LOCK` 內只保存最新一筆於 `APP_STATE`，加上與 `camera_last_live_frame_at` 同格式的 `received_at`；不寫檔，手動選網及自動網路身分變更時與該時間同處清除。`get_camera_diagnostics()` 回傳獨立快照或 `None`，供[助手狀態工具](#奶蛋博士)使用，不加入 `/api/state/` 或 Dashboard 畫面。

手機僅在開相機成功／失敗、video track 結束、RTC connection／ICE 狀態改變時上報；開相機與切換鏡頭只上報所有 fallback 結束後的最終結果，失敗只傳最終錯誤名稱，其他名稱轉成 `unknown`。上報不新增輪詢且不等待完成，失敗只 `console.warn`，不影響拍攝、上傳與 WebRTC。

Dashboard 的即時預覽外框在未連線時保持隱藏，左欄不得被右欄內容高度拉伸；連線後 video 使用 `width: auto`、`max-width: 100%`、`height: auto` 依來源原始比例縮放，並以 `min(52vh, 520px)` 限制預覽高度，不得固定預留 `16:9` 高度或放大到超過單頁可預覽範圍。

ESP32 command polling 必須附帶本次開機唯一的 `boot_id`、送料能力 `capability=feeder_v1`、複合分類能力 `sorter_capability=gate3_sorter_v1`、`feeder_state=idle|awaiting_fruit`、`feeder_sensor_state=clear|blocked|unavailable` 與 `last_feed_command_id`。`clear` 只代表最近一次有效距離大於 `8.0 cm`；`0 cm`／Echo timeout 必須回報 `unavailable`，其餘為 blocked。Django 未收到 `feeder_v1`、ESP32 離線、感測器不是 `clear`、最新 revision 尚未 ACK，或 boot／feeder state 尚未完成復原時，不得建立測試 `feed_one`。Django 未收到 `gate3_sorter_v1` 時，禁止正式自動運轉，並在 Dataset 提交前拒絕人工或未來 AI 的分類請求。

## 自動運轉與單顆送料

### 開始條件

正式 production `feed_one` 已開放；Dashboard 與 `POST /api/auto_run/` 只在下列 runtime 安全條件全部成立時允許開始。

操作員按下 Dashboard「開始拍攝」時，Django 必須在同一個 `STATE_LOCK` critical section 內確認：

- ESP32 在線且回報 `feeder_v1` 與 `gate3_sorter_v1`。
- ESP32 已 ACK 最新硬體參數 revision。
- 相機最後一次 ready heartbeat 未超過 `5000 ms`。
- 沒有 active fruit、未分類 temp fruit、Capture、sorter 或 motor command。
- ESP32 已取得一次有效且大於 `8.0 cm` 的 HC-SR04 距離；感測區未清空或讀值為 `0 cm` 時，Firmware 必須拒絕 `feed_one`，Django 關閉自動運轉並通知操作者。
- 若有重新啟動或進料未確認狀態，操作員已依 Dashboard 提示檢查送料區域，並以本次「開始拍攝」明確確認復原。

條件成立後，Django 設定自動運轉並建立第一個 `feed_one`。自動運轉狀態只存在記憶體，不跨 Django 或 ESP32 重新啟動恢復。

### `feed_one` 契約

1. Django 建立 `feed_one`，snapshot `feeder_stop_us`、`feeder_drive_us` 與 `feeder_max_run_ms`，並帶 `feed_context=production|calibration`。
2. ESP32 再次確認 HC-SR04 已以有效距離大於 `8.0 cm` 重新待命；未清空回報 `feeder_sensor_not_clear`，`0 cm`／Echo timeout 回報 `feeder_sensor_unavailable`，兩者都不得啟動馬達。
3. ESP32 寫入 `feeder_drive_us` 並記錄開始時間。每次控制迴圈先判斷 `feeder_max_run_ms`，尚未到期才讀取 HC-SR04；任一停止分支都必須先在本機寫入 `feeder_stop_us`，不得等待網路。
4. 一次有效的 `HC-SR04 <= 6.0 cm` 先發生時，ESP32 立即停止、鎖存 trigger、回報 `feed_cycle_completed`，並附 `feeder_elapsed_ms`、`feeder_max_run_ms` 與 `feeder_stop_reason=hcsr04`。正式送料以同一筆 trigger 啟動既有首站流程。
5. `feeder_max_run_ms` 先到時，ESP32 立即停止並回報 `feeder_max_run_timeout`；`0 cm`／Echo timeout 在運轉中出現時立即停止並回報 `feeder_sensor_unavailable`。兩者都附實際運轉時間與設定上限。
6. Report timeout 只重送同一個 terminal report 與鎖存 trigger，不得再次執行送料動作。

「測試送料一顆」重用完整停止邏輯，command context 為 calibration。HC-SR04 成功觸發後 ESP32 回到 `idle`，Django 保持自動運轉關閉，不建立 Capture session。測試逾時只顯示停止原因與實際時間，不建立正式流程的 blocking error；感測器異常仍必須顯示可操作的錯誤。

### 下一顆果實

蒐集模式的人工分類、自動檢測的 AI 與人工接手共用既有 `classify_fruit` 邊界。Django 確認 `gate3_sorter_v1` 後，先提交 Dataset 或檢測 JSON／CSV，再建立分槽命令。只有相符的 `classification_sorter_completed` 已清除 command slot，且自動運轉、相機 readiness 與全部開始條件仍成立時，Django 才建立下一個 `feed_one`；命令 ID 綁定果實與分類 code，回報若附 `fruit_id` 也必須相符。Sorter failed／timeout、Capture timeout、相機 stale 或任何復原鎖都不得建立下一次送料。相機暫時未 ready 時可等待恢復；達到裝置失聯門檻後則依網路安全復原契約鎖定，不自動續跑。

### 安全逾時、感測異常與延遲抵達

正式送料發生 `feeder_max_run_timeout` 時，Django 清除 command slot、關閉自動運轉並顯示「進料未確認」；ESP32 維持 HC-SR04 待命，但不得自動補轉；原因也可能是料斗已空或果實卡住。

逾時與有效觸發落在同一次控制迴圈時，以逾時優先；結束等待前若果實才觸發 HC-SR04，仍完成三站拍攝與分類，自動送料保持關閉。操作員也可按「結束送料等待」，以 `POST /api/feeder/finish_wait/` 明確提交 `recovery_confirmed=true`：僅限硬體模式的送料逾時、無 active／暫存果實、拍攝、檢測、分類、Gate 3 待處理或待執行命令，且 ESP32 在線、網路可控制時接受，不要求相機就緒。Django 建立原因 `feeder_wait_cancelled` 的復原鎖，沿用 `recover_network` 歸位與雙端提交；完整 ACK 前阻擋切換，重複請求不重建命令。政策保存 `resume_auto_run=false`，失敗重試與重啟皆保留；完成後回 `idle`、清除送料等待與錯誤、保持自動運轉關閉，並持久保存 `auto_trigger_paused=true`，禁止重新觸發。此時開放模式、Django 選網與 ESP32 配網（後者仍等本機 safe-idle 回報）；下一次明確開始才解除觸發暫停並建立新送料。決策見 [ADR-0024](adr/0024-explicit-feeder-wait-finish.md)。

送料前的 `0 cm`／Echo timeout 直接拒絕命令；送料中的相同錯誤立即停止馬達並關閉自動運轉。Dashboard 必須指示操作者檢查 HC-SR04 線材、供電、Echo 分壓與感測方向，不得將無回音解讀為感測區清空。

### 優雅暫停

暫停是 Django 控制旗標，不是 motor command，不占用、取消或覆寫單一 command slot，API 必須立即回應。與 `feed_one` 建立使用同一把 `STATE_LOCK`：

- 暫停旗標先寫入時，不建立下一次送料。
- `feed_one` 先建立時，視為已承諾；目前果實完成拍攝與實體分類後停止。
- 安全逾時後仍保持感測器待命；若實際沒有果實，不建立 Capture session，也不自動補轉。

暫停可發生於送料後等待、三站拍攝、等待人工分類、實體分類或分類後尚未建立下一次送料。Dashboard 主操作區只使用同一按鈕：停止時顯示「開始拍攝」、運轉時顯示「停止拍攝」（即優雅暫停）、正在完成目前果實時顯示 disabled「正在完成目前果實」；檢測待人工判級時改為「等待人工處理」，分類器逾時則清除 finishing 狀態並保留復原鎖。硬體復原鎖存在時顯示「確認安全復原」；純拍攝同一按鈕顯示「開始拍攝」。本軟體暫停不是實體緊急斷電。

重拍與刪除成功時都關閉自動運轉。重拍由操作員將同一顆果實放回 Gate 1，再走既有 `start_sequence`，不驅動送料機構；完成後由操作員重新按「開始拍攝」。正式硬體流程不提供通用 manual capture；純拍攝僅使用下述受模式限制的獨立入口。

### 重新啟動與重複動作

ESP32 每次開機產生新的 `boot_id`。Django 若在未完成 `feed_one` 期間看到 boot 改變，必須關閉自動運轉、不向新 boot 重送該命令，保留 HC-SR04 待命並顯示操作員檢查提示；原則是寧可少送一次，也不能自動重複送料。

Django 重新啟動後，依 ESP32 polling 的 `feeder_state` 與 `last_feed_command_id` 重建「進料未確認」。看到 `awaiting_fruit` 時保持自動運轉關閉、允許 HC-SR04 接手，但不建立新 `feed_one`。重複或舊的 feeder terminal report 回 `200 ignored`，不得推進流程或造成 ESP32 永久 retry。

切斷送料供電分支 B 的 DC 輸出只用於送料機構緊急停止。若 Dashboard 仍可連線，操作員先要求優雅暫停，讓分支 B 保持斷電直到目前 `feed_one` 到達 `feeder_max_run_ms`，並確認 Dashboard 收到 `feeder_max_run_timeout`；清料且手離開送料筒後才可恢復分支 B 供電，接著必須執行一次測試送料再恢復正式運轉。

若緊急斷電後無法連線或看不到 terminal report，送料供電分支 B 必須保持斷電。操作員清料後重新啟動 ESP32，等待 Firmware 完成初始化、先寫入 `feeder_stop_us`，並確認 Dashboard 顯示 ESP32 已重新連線且正式運轉保持停用；手離開送料筒後才可恢復分支 B 供電，之後同樣必須執行一次測試送料。

### Dashboard 錯誤提示

Blocking error 在全域 `role="status"` 訊息列顯示簡短中文原因，顯示時間依 Dashboard 契約；狀態徽章提示與診斷區保留原因、操作指引、fruit／command 與送料實際／上限時間及停止原因。Reason 至少區分 `feeder_max_run_timeout`、`feeder_sensor_not_clear`、`feeder_sensor_unavailable`、`camera_upload_timeout`、`classifier_timeout`、`feeder_capability_missing` 與 `esp32_restarted_during_feed`。存在 active fruit 時，「開始拍攝」保持停用；送料逾時另可依上述契約明確結束等待。

## 觸發與三站流程

### 自動首站捷徑

1. 正式送料期間 HC-SR04 進入觸發範圍時，ESP32 先停止馬達並鎖存 `trigger_id`；非送料觸發沿用既有 trigger 建立方式。
2. 只有送料 terminal report 已安全處理、沒有 sequence、三閘門追蹤為 Home 且已等待首站停穩時，才可使用同一筆鎖存 trigger 回報 `hcsr04_station_1_ready`。Calibration context 不得進入此流程。
3. Report 必須帶同一個 `trigger_id`、`station_index=1`、`gates_home=true` 與 `station_settled=true`。
4. Django 驗證鎖定條件後建立或找回 active fruit，開放第 1 站拍攝。
5. 可回退的協定拒絕才改走標準流程；HTTP timeout 只能重送原 `trigger_id`。收到 `ignored` 時停止本次 trigger 並等待重新待命。

Gate 1 已實際攔住果實是部署前提，並非額外位置感測。捷徑只縮短第 1 站前控制往返，不放寬照片保存交握。

### 標準與重拍流程

重拍只取代 HC-SR04 開始請求，且不驅動送料機構。Django 建立 `start_sequence`，ESP32 取得後回報 `station_1_ready`。Legacy `hcsr04_trigger` response 若已含 `start_sequence`，ESP32 可直接執行；POST timeout 時先 fast poll 既有 command，不立即假定失敗。

### 三站交握

1. Django 開放目前站點 capture request。
2. 手機拍攝並上傳該站單張照片。
3. 第 1、2 站原子保存成功後，Django 分別建立 `station_index=1`、`station_index=2` 的 `release_gate`。
4. ESP32 直接放行目前 Gate，等待伺服與果實停穩後回報下一站 ready；Gate 1 與 Gate 2 放行後維持 Release。
5. 第 3 站保存後，Django 將三張照片標記為可檢查與分類，不建立 `station_index=3` 的 `release_gate`；Gate 3 保持 Home，果實留在第 3 站。
6. 使用者分類時，Django 先確認 ESP32 已回報 `gate3_sorter_v1`；能力缺失時保留暫存照片與果實並拒絕分類，能力存在時才提交 Dataset 與 metadata，再建立 `classify_fruit`。
7. ESP32 將分類器轉至目標角度並等待 `500 ms`，再放行 Gate 3；Gate 3 到達 Release 後保持分類角度 `1000 ms`。
8. 落果等待完成後，三顆 Gate 同時回 Home `0°`，分類器同時回 Home；共同歸位等待 `500 ms` 後回報 `classification_sorter_completed`。
9. 失敗或結果不確定時保持自動運轉關閉，且不得自動重放實體動作。

任何固定延遲都不能取代 Django 確認照片保存成功。

## Command ID、互斥與冪等

```text
feed_one -> feed_cycle_completed | feeder_max_run_timeout | feeder_sensor_not_clear | feeder_sensor_unavailable 使用 feed_one command_id
start_sequence -> station_1_ready 使用 start_sequence command_id
release_gate + station_index=1 -> station_2_ready 使用該 release_gate command_id
release_gate + station_index=2 -> station_3_ready 使用該 release_gate command_id
classify_fruit -> Gate 3 與 sorter 複合 terminal report 使用 classify_fruit command_id
```

目標流程不再建立 `station_index=3` 的 `release_gate`，也不再以獨立 `capture_sequence_finished` 作為第 3 站實體放行完成事件；第 3 張照片保存本身建立可分類狀態，完整實體交握由相同 `classify_fruit` terminal report 結束。

Django 建立 command 前，取記憶體與 `Django_Server/runtime_config/motor_command_sequence.json` 的較大值加一並原子保存，成功後才公開。檔案不存在時從 `1` 開始；損壞或寫入失敗時回傳 `motor_command_id_persist_failed` 並拒絕建立。Dataset reset 不重設序列。每個 command 只能有一個 terminal report；相同 ID 的 retry 必須冪等。

以下狀況禁止新的 `feed_one`、自動 capture 或重拍：

- 已有 active fruit 或未分類 temp fruit。
- Capture 不在 idle。
- Sorter 為 pending／running。
- 單一 motor command slot 尚有命令。
- 相機 readiness stale、送料設定未 ACK／未確認，或 ESP32 未回報 `feeder_v1`／`gate3_sorter_v1`。

首站捷徑以 `trigger_id` 做 server-side 冪等；legacy trigger 依 active fruit 與既有 command 防重。Firmware 以 command ID 去重實體動作，report retry 不得再次轉動伺服。Terminal sorter 收到 late duplicate report 時回 `200 ignored`，不得改寫既有結果。

## 分類與 Dataset

第 3 張照片保存後，果實仍由 Gate 3 攔住。Django 必須先確認 ESP32 在線且回報 `gate3_sorter_v1`；已知能力不相容時，在 Dataset 提交前拒絕分類並保留暫存照片。能力確認後，Django 在人工分類時先搬移照片、寫入 `metadata.csv`、推進 counter 並清除 active Dataset 狀態，再嘗試建立 `classify_fruit`。資料操作失敗時不得建立分類 command；資料已提交後才發生的 command 建立或硬體失敗，不得反向搬移或回滾 metadata，Gate 3 也不得自動開啟。

Sorter 使用 `idle／pending／running／completed／failed／timeout`，不覆蓋 capture status。Pending／running 期間拒絕下一次送料、capture、recapture、reset 與第二筆分類。MG996R 無位置回授，completed 只代表控制時序完成並成功回報。

```text
dataset/collection/
  temp/fruit_XXX/
    img_01.jpg
    img_02.jpg
    img_03.jpg
  上等/
  中等/
  下等/
  加工/
  metadata.csv
  counter.json
```

`metadata.csv` schema：

```csv
fruit_id,label,capture_time,path,capture_count,station_01_ok,station_02_ok,station_03_ok,note
```

跳過／刪除先關閉自動運轉，再嘗試實體刪除；Windows 檔案占用時移至 `_delete_pending`，仍失敗則持久標記待清理並跳過該 fruit ID。成功結果必須清除 capture token、等待計時器、fast-path 與 motor command，且不得自動送料。硬體請求若附 `fruit_id`，也須附相符的 `capture_token`；不符回 `409 stale_capture`。Gate 3 等待中的跳過先保存人工移除鎖並撤銷 ESP32 舊流程，維持 error；操作員依斷電程序移除果實、手離開並恢復供電後，按「確認安全復原」，重用上述 `recover_network` 雙端歸位交握。兩端完成提交後才清除 Gate 3 鎖並回 idle，仍須再按「開始拍攝」才送料；舊版只保存 Gate 3 marker 的復原同樣須經此交握。其他成功刪除回 idle。

### 資料分區

新流程的蒐集資料根目錄為 `DATASET_ROOT/collection/`，檢測為 `DATASET_ROOT/detection/`；各自維護 `temp/`、`counter.json`、`reset_state.json`、`discard_state.json` 與 `_delete_pending/`。只有蒐集分區有四級照片目錄與 `metadata.csv`；檢測分區不建立，啟動時移除空的級距目錄與只有標題列的 `metadata.csv`，有內容者保留原位。檢測原圖、處理圖及 `result.json` 保存於檢測分區的 `results/fruit_NNN/`，總表為檢測分區的 `detection_summary.csv`，契約見[檢測資料](#檢測資料與-line-通知)。

既有 `DATASET_ROOT` 根目錄及舊 `Django_Server/detection_results/` 保留原位，只作歷史資料，不自動搬遷、升級或納入新流程的恢復與清理。Dashboard 資料管理只顯示目前模式，不顯示目前與歷史目錄路徑，重置區明示只影響目前模式；開啟、編號、刪除與重置只作用於目前模式。檢測的 `result.json` 與總表列都保存成功後，純拍攝立即清除該輪 `temp/`（原圖已存於 `results/`）；硬體有效判級在持久保存 sorter intent 後推進 counter、清理暫存，再建立分槽命令，待人工判級或安全移除的輪次則保留暫存。Dashboard 的跳過／刪除只處理暫存與未保存成功的部分產物，不刪除已保存的檢測結果，已保存結果只隨重置檢測分區清除。重置檢測包含 `results/` 與總表；Windows 占用沿用隔離、延後清理及忽略標記，未能隔離的舊產物不得被覆寫或展示為新結果。

自動檢測模式的資料管理另有「匯出檢測報告」，提醒使用者在重置前先匯出。`GET /api/export_detection/?dataset_mode=detection&include_results=0|1` 回傳 `detection_export_YYYYMMDD_HHMM.zip`，內含 `report.png`（以目前檢測分區全部結果繪製，版面同趨勢提醒圖但沒有標紅與前期線）與 `detection_summary.csv`；`include_results=1` 另附總表中已保存列指向的 `results/fruit_NNN/` 全部檔案，略過重置留下的忽略路徑。網路檢查同重置：未選網只限本機 Dashboard。參數錯誤回 `400 export_options_invalid`，蒐集模式回 `409 export_detection_only`，有檔案操作進行中回 `409 dataset_busy`，讀檔或繪圖失敗回 `500 export_failed`。ZIP 先寫入暫存檔再串流下載；匯出期間不鎖定 dataset。

目前模式與硬體選項原子保存於 runtime 的 `dataset_options.json`，重啟先恢復模式再讀取該分區；紀錄損壞時禁止資料變更、開始拍攝與接收照片，並顯示具體原因。硬體 command sequence、timing 與復原鎖仍共用，不隨分區重置。開始後固定本輪模式；有處理中工作或資料鎖時拒絕切換；馬達鎖的模式例外見「失聯門檻與安全交握」。Dashboard 的資料操作附 `dataset_mode`，缺少或與目前模式不符回 `409 stale_dataset_mode`；照片 URL 帶 `work_mode`，缺少或模式不符回 `404` 並要求快取重新驗證。

## 純拍攝與自動檢測

本節是 2026-10-13 已確認的 XGBoost、資料分離與 UI 契約；實作狀態見 [CURRENT_STATUS.md](CURRENT_STATUS.md)。既有硬體交握與安全邊界不因接入模型而略過，實作與實機驗證狀態見 [CURRENT_STATUS.md](CURRENT_STATUS.md)。

### 模式與硬體隔離

- Dashboard 提供「蒐集模式／自動檢測模式」選單；蒐集模式保留人工級距分類，自動檢測模式由 YOLO 特徵與 XGBoost 產生四級結果，不將預測當成人工標籤。
- 硬體選項只有「使用硬體／純拍攝」，不另設送料開關。純拍攝完全隔離硬體，不要求 ESP32 連線、能力回報或硬體參數同步，也不模擬超音波事件或建立任何 motor command。
- 純拍攝由「手動觸發本輪」啟動，要求手機相機 readiness 有效且沒有處理中的工作階段；僅預覽連線不代表相機已可拍攝。
- 純拍攝按一次即自動拍攝三張，不需逐張確認。Django 在每張驗證並保存成功後才要求下一張，保留拍攝 token、上傳驗證與重複請求防護；不等待實體 station ready。自動檢測的純拍攝用於隔離 ESP32 的模型檢測與分類測試，前兩張各在保存成功後額外等待 `1000 ms` 才要求下一張；此等待不套用到硬體停穩 timing。三張是三次拍攝，不保證果實已轉動或具有不同視角。
- 使用硬體時包含上游送料、HC-SR04 與三站閘門交握，沿用既有 readiness、能力回報與硬體參數同步條件。純拍攝的略過條件不得套用到實體流程。
- 模式與硬體選項只能在沒有 active capture、待處理果實、推論或 motor command，且沒有資料鎖時切換；馬達鎖的模式例外見「失聯門檻與安全交握」，切換選項不得清除既有鎖定。

### 純拍攝 API 契約

`POST /api/collection_options/` 接收 `work_mode=collection|detection` 與 `hardware_mode=hardware|photo_only`，四種組合皆可選；既有 capture、Dataset、motor、自動運轉、推論或資料鎖存在時回 `409` 與具體 reason，不清除鎖定；馬達鎖的模式例外見「失聯門檻與安全交握」。預設使用硬體；開始後固定本輪 `session_work_mode` 與 `session_hardware_mode`。純拍攝與使用硬體的自動檢測會在暫存 fruit 目錄原子保存 `.capture-session.json`，供 Django 重啟後恢復工作模式、硬體選項與拍攝時間；資料提交成功或完成安全復原後清理該內部標記，不改變 metadata CSV 欄位。

`POST /api/photo_capture/` 僅接受純拍攝；相機 heartbeat 過期回 `409 camera_not_ready`，有待處理資料回 `409 active_fruit_exists`，拒絕時不建立 fruit 資料夾。成功後重用手機 capture state 與 upload API，每張原子保存成功才更新 token 並要求下一張，不等待 station ready，也不建立任何 motor command。ESP32 事件回 `200 ignored`，直接 trigger 回 `409 hardware_mode_required`；ESP32 boot 改變不影響純拍攝上傳。

自動檢測的純拍攝在第 1、2 張保存後進入 `photo_interval`：`capture_requested=false`、不建立新 token，期間的上傳回 `409`；到期後由下一次 `/api/state/` 或相機 state 輪詢發出下一張請求並更新 token，不以請求內 sleep 阻塞查詢。刪除本輪會取消尚未發出的請求。

三張保存後才開放人工分類；純拍攝的 `/api/classify/` 與 `/api/discard/` 必須附目前 `fruit_id`、`capture_token`，過期請求回 `409 stale_capture`。分類維持既有照片、metadata 與 counter 契約，成功回 `hardware_skipped=true`，不建立分類器復原紀錄或實體命令。分類、刪除後回 idle，不自動開始下一輪。拍攝失敗沿用既有等待與同 token 重試；逾時保留已保存照片，操作員刪除本輪後重新開始。

### 檢測與判級

- 自動檢測在三張原圖全部保存後，由 Django 本地推論處理；部署不得依賴外部模型 Repository 或資料。ROI 處理後分別執行 color、wrinkle 與 local defect，再將各張特徵送入兩階段 XGBoost。
- 沿用本次交付模型的 13 個原始特徵與 3 個衍生特徵，包括 confidence；不得套用舊研究 baseline 的 7 特徵限制，決策見 [ADR-0019](adr/0019-deployed-two-stage-xgboost-grading.md)。特徵名稱與順序以模型檔為準並於載入時核對；數值須為有限值且落在 `0～1`，二元特徵只接受 `0／1`。交付模型存檔不等於分類結果 JSON。
- 每張先判斷加工／非加工，再將非加工分為其餘三級；整顆取三張預測最低級距，`0／1／2／3` 對應加工／下等／中等／上等，再轉為既有 canonical code。沿用 [ADR-0012](adr/0012-defect-ratio-ai-contract.md)：未偵測瑕疵為 `0`，必要 ROI／推論失敗為 `null` 並待覆核，不補零硬判級距。
- 部分失敗仍保留已取得原圖、成功產物與具體原因；無法產生的裁切或標示圖不建立，保存失敗不得顯示存檔成功。硬體尚未取得有效分類或資料尚未提交時，不得放行 Gate 3 或開始下一顆。
- 檢測自排入起超過 `180 s` 未結束（`detection_timeout`），或背景執行緒意外中止（`detection_job_crashed`）時，標記 `detection_failed`、釋放資料鎖、停用自動運轉並保留原圖；遲到的結果因 token 過期一律忽略。Gate 3 保持關閉，操作員刪除本輪後重拍。
- 無法取得完整模型判級時，標記「待人工處理」並允許操作員檢查照片後人工選級，再經相同的資料提交與安全分類邊界完成分槽；保留原推論失敗原因與模型輸出，另記錄最終分類來源為人工，不將人工結果偽裝成模型成功。人工接手仍屬檢測紀錄，不搬入人工蒐集 Dataset；純拍攝的人工接手也不得建立硬體命令。
- 人工接手使用 `POST /api/detection/manual_grade/`，附 `dataset_mode`、目前畫面的 `fruit_id`、`result_id` 與 `label`（上等／中等／下等／加工）；純拍攝另接受 `abandon=true`。`/api/state/` 以 `can_manual_grade`、`manual_grade_disabled_reason` 與 `can_manual_abandon` 表示可否操作。只接受目前 `detection_result`、已保存且 `needs_review` 的同一 `result_id`；不符或已開始新一輪回 `409 stale_detection_result`，模型已判級回 `409 not_needs_review`，已人工處理而改送不同決定回 `409 already_manual_graded`，相同決定重送回 `200 duplicate=true` 且只重新同步該列，不重建分槽命令。JSON 或總表保存失敗回 `503 result_json_save_failed／summary_save_failed`，嘗試還原 JSON 並維持待人工處理；還原也失敗時，同級重送可同步資料，但硬體結果視為不確定，必須安全復原。
- 硬體人工判級前與保存後均檢查失聯／sorter 復原鎖、ESP32 在線、`gate3_sorter_v1` 與同一 boot 的 Gate 3 等待狀態。未處理 `needs_review` 不建立命令；有效人工判級保存後重用 AI 的安全分槽流程。硬體放棄回 `409 hardware_abandon_requires_discard`，操作員改用跳過／刪除與既有斷電移除程序，不把資料刪除當成實體放行。純拍攝成功後維持 idle，不建立 motor command、不自動開始下一輪。
- 使用硬體的流程為「三站拍攝 → YOLO → XGBoost／人工判級 → 保存 → `classify_fruit` → 相符完成回報 → 下一顆」。Sorter intent／pending／running 沿用既有原子 recovery marker；重啟後只恢復已保存結果與安全鎖，不從結果檔重建命令。資料提交後的命令建立失敗、硬體失敗或 timeout 都不回滾結果；只有相符完成回報與全部安全條件成立，才允許下一次送料。優雅暫停仍完成目前果實但不送下一顆。純拍攝維持單輪，完成後由操作員再按開始，不建立實體命令。
- Django／ESP32 重啟、重複上傳或 terminal report 不得重播實體動作；資料刪除不能代表實體果實已移除，仍須遵守既有人工安全復原契約。

### 檢測資料與 LINE 通知

- 蒐集與檢測資料完全分離，包含暫存、最終照片、結果、counter 與清理／重置範圍；新資料使用獨立生命週期，既有資料保留原位，不自動搬遷。人工蒐集的目錄與 metadata schema 沿用上節。
- 每顆檢測果實有獨立目錄，保存原圖、成功的 ROI 框選／遮罩／灰階 CLAHE／局部瑕疵標示圖及 `result.json`。JSON 是 Dashboard 與 LINE 共用的單顆詳細結果，不把模型檔當成結果檔傳送。
- `result.json` 的 `contract_version` 為 `1`；`result_id` 於本輪開始時隨機產生並寫入 `.capture-session.json`，重啟沿用、不依賴可重設的流水號。頂層另有 `fruit_id`、`hardware_mode`、`capture_time`、`completed_at` 與下列分開的狀態：
  - `inference`：`completed／failed` 與原因（`detection_incomplete`、`artifact_save_failed`、`service_restarted`）。
  - `classification`：最終分類，`graded` 或 `needs_review`，含 `grade`（`0～3`）、`label`、canonical `code`、`source`（模型為 `model`，人工接手為 `manual`，未判級為 `null`）、`worst_view` 與 `reason`；人工接手另含 `decided_at`；放棄本輪為 `status=abandoned`、`source=manual`、`reason=operator_abandoned`，等級欄位為 `null`。
  - `model_classification`：僅人工接手後存在，原封保存模型當時的 `needs_review` 分類與原因；`inference`、`images` 與各視角 `grade` 不因人工判級改寫。
  - `storage`：`saved／failed`、原因及 JSON／CSV 相對位置；`sorting`：結果存檔時純拍攝為 `skipped`、硬體為 `not_started`。`/api/state/` 的 `detection_result.sorting` 依同顆 sorter runtime 補上 `pending／running／completed／failed／timeout`、`command_id`、`reason` 與 `recovery_required`；重啟或失聯以 recovery marker 表示需復原，不將存檔中的判級成功當成實體分槽完成。
  - `model`：YOLO 檔名，以及兩個 XGBoost 檔名、SHA-256、xgboost 版本與第一階段門檻。
  - `images.<img_0N.jpg>`：ROI、各模型結果、`artifacts` 檔名，以及 `grade` 內的 16 個特徵、第一階段機率、第二階段機率、單張等級或 `unavailable` 與具體原因（如 `roi:roi_not_detected`）。
- 頂層 `complete` 只在推論完整、模型已判級且 JSON／CSV 都保存成功時為真；任一保存失敗記為 `storage.status=failed`，不顯示為完成。人工接手保存成功時 `status=manual_completed`（放棄為 `manual_abandoned`）、`complete=false`，`reason` 保留原推論或判級失敗原因。
- `detection_summary.csv`（UTF-8 BOM）每顆一列，以 `result_id` 去重，重試與重啟只取代同列。檔案被其他程式占用時最多嘗試 `5` 次、間隔 `100 ms`；仍被占用（例如 Excel 開著）即為 `summary_save_failed`，原因提示關閉該檔：

  ```csv
  result_id,fruit_id,capture_time,completed_at,hardware_mode,result_status,classification_status,reason,view_01_grade,view_02_grade,view_03_grade,final_grade,final_label,final_code,classification_source,model_version,result_json
  ```

  `result_status` 等於 JSON 頂層 `status`（只有 `complete` 時為 `completed`，人工接手為 `manual_completed`，放棄為 `manual_abandoned`），`classification_status` 為分類狀態，`reason` 取頂層原因、否則取分類原因；未判級的等級欄位留空；`model_version` 為兩個模型 SHA-256 前 12 碼；`result_json` 相對於檢測分區。失敗輪次也留紀錄，完整特徵由 JSON 保存。原圖與所有執行產物均不納入 Git。
- LINE 對接交付程式已使用的 Messaging API，收件對象為模擬農夫群組的畢專群組。只對最終等級為加工的果實通知，正文依序為「|瑕疵通知|」「偵測時間：YYYY-MM-DD HH:MM:SS」「發現瑕疵：…」（只通知加工果，不另列等級）；純拍攝第一行為「測試 |瑕疵通知|」。正文不顯示果實識別，檔名、回傳值與 command 輸出保留 `result_id`。瑕疵取已完成檢測視角的成功觀察聯集，依照片 1→3 與各照片內既有順序去重；`insect_track` 的文字與圖例皆為「畫圖蟲」，`anthracnose` 顯示為「炭疽病」。所有視角完成且無觀察時寫「發現瑕疵：未偵測到瑕疵」；僅部分完成且無觀察時寫「發現瑕疵：已完成檢測的照片未偵測到瑕疵」；無完成視角時寫「發現瑕疵：無可用檢測結果」。未完成視角最後列「備註：照片 2 未完成檢測，未列入瑕疵觀察」，多張以「照片 1、3」列出。不放 grade code、模型 confidence 或程式欄位，不宣稱已分槽或保證可食用；不得把觀察項目宣稱為 XGBoost 判為加工的因果解釋。
- 通知附圖將三個視角的 `defect_marked` 合成一張；此產物只保留遮罩／框，不含英文類別或 confidence，Dashboard 繼續使用 `defect_annotated`。每格保留照片編號、逐張說明及中文圖例；四類依 `class_name` 共用固定高對比配色，圖例色塊加深色外框，標示圖直接以實際遮罩與框座標繪製，不使用 Ultralytics 預設調色盤。新配色檔名以 `_defect_marked_farmer_v1.jpg` 識別；舊配色或缺少 `defect_marked` 時使用原圖並註明「無標示圖」，保留已有觀察與檢測完成狀態；某張檢測失敗時使用已取得原圖並標明「未完成檢測」，不得產生虛構標示。採用 Cloudinary 免費方案提供通知合成圖的 HTTPS 網址，只上傳通知所需合成圖，完整原圖與檢測資料留在本機；雲端圖片保留至畢專展示結束，再由操作員手動清理，不新增自動刪除。清理後舊通知附圖可能無法重新載入，本機資料不受影響。
- 人工判為加工同樣列入通知，於偵測時間後加一行「判定方式：人工判定」。推論失敗而尚無人工判級的紀錄不發加工通知。
- 本機預覽：在 `Django_Server/` 執行 `C:\Users\qoqoo\anaconda3\envs\PF\python.exe -s manage.py preview_processing_notification <result.json>`；可用 `--output-dir <目錄>` 與 `--font-path <中文字型>` 指定輸出與字型（預設 Windows 微軟正黑體 `C:/Windows/Fonts/msjh.ttc`）。預設在該果實結果目錄新增 `notification_<result_id>.txt`、`notification_<result_id>.jpg` 與 `notification_<result_id>_preview.jpg`，不改寫原始結果。兩張圖為 JPEG，原圖與預覽圖分別限制為 `10 MB`／`1 MB`，依 [LINE image message](https://developers.line.biz/en/reference/messaging-api/#image-message)；此指令不發送訊息。
- 待送與發送由 `notification_delivery.py` 負責：每顆加工果（含人工判定）的最終分類 JSON／CSV 保存成功即在 `runtime_config/notification_outbox.json` 以 `result_id` 建立一筆持久待送，不等待分槽，也不宣稱已分槽；只在 `runsslserver` 的背景 worker（約每 `5 s` 及排入時喚醒）產生合成圖、上傳並發送，Cloudinary 或 LINE 失敗不阻塞本地檢測、人工接手與分槽。合成圖暫存於 `runtime_config/notification_images/`，不改寫結果目錄。
- 每筆只上傳一次通知合成圖至 Cloudinary（簽章上傳、`public_id=passionfruit_notifications/<result_id>`、`overwrite=false`），取得 HTTPS 原圖網址，卡片圖以同一張圖的 `c_limit,w_960,h_960,q_auto:good,f_jpg` 轉換網址提供（Flex 圖片上限 `1024×1024`）。LINE 以 Messaging API push 對群組發送一個請求，內含一則 Flex Message：`giga` 卡片上方為合成圖（`aspectMode=fit`、比例取實際寬高，點圖開啟原圖），下方逐行為正文、首行粗體；`altText` 為正文去掉偵測時間行（上限 `400` 字），供通知列預覽。正文使用保存時的原檢測時間，補送不改時間。
- 防重：同一 `result_id` 只建立一筆，分槽狀態或 JSON 更新不會再排送；每筆持久保存一個 `X-Line-Retry-Key`，發送前先落盤再請求。`200`／`409`（已接受）都記為已送出；timeout、連線中斷或 `5xx` 視為送達不明，沿用同一 key 重試；DNS 失敗、連線被拒或網路／主機無法到達視為未送出。已有送達不明紀錄時，後續 `4xx` 不清除該紀錄；若為不可重試的拒絕則標記「送達不明」而非失敗。自第一次可能送達起超過 `23 h`（LINE retry key 有效 `24 h`）仍無法確認時標記「送達不明」，保留追蹤且不自動重送。重試間隔 `30 s` 起倍增、上限 `600 s`。
- 錯誤：憑證或權限被拒（`401／403`）與額度／速率限制（Cloudinary `420／429`、LINE `429`）保留待送並顯示原因；其他 `4xx`（如檔案過大、訊息格式錯誤）與結果檔遺失標記失敗並明確回報。雲端圖片不自動刪除。
- 憑證只放後端私密檔 `Django_Server/runtime_config/notification_credentials.json`（已被 Git 忽略），欄位為 `line_channel_access_token`、`line_group_id`、`cloudinary_cloud_name`、`cloudinary_api_key`、`cloudinary_api_secret`；設定錯誤時保留待送，`config_reason` 回傳 `line_credentials_missing`／`line_credentials_unreadable`／`line_credentials_invalid`／`line_credentials_incomplete`，缺欄位另以 `config_missing_fields` 列出欄位名稱，完整時分別為 `null` 與 `[]`。Dashboard 與趨勢提醒共用此狀態，原因碼中文唯一來源為 `fruit_app/reason_text.py`，於頁面載入時以 `json_script` 提供，不放入輪詢回應。憑證檔名、憑證值與群組 ID 不進網頁或設定狀態；憑證值與群組 ID 也不進待送檔、`result.json` 或 log，讀取錯誤僅記錄 exception 類型。待送檔只保存首次產生的通知文字與雲端網址，確保重試內容一致。首次實際發送前須核對群組，並先以純拍攝（帶「測試」）驗證。
- 開關依硬體選項分開保存，`hardware` 與 `photo_only` 預設皆關閉；`POST /api/notification/ {"enabled": true|false}` 切換目前硬體選項的開關，`/api/state/` 的 `notification` 提供目前硬體選項的開關、設定狀態、待送／已送出／送達不明／失敗／略過數、暫停數、最近錯誤與本輪狀態。純拍攝開啟後訊息開頭加「測試」。Dashboard 操作摺疊區提供切換與狀態，收合時摘要列仍顯示開關與待送數。
- 主動關閉通知時保留並暫停該模式尚未送出的訊息，重新開啟後續送；關閉期間新產生的結果記為「略過」而不加入待送，之後開啟或重複保存也不回溯排送。已交付 LINE 的請求不因關閉開關而撤回。

### 檢測統計與趨勢提醒

決策見 [ADR-0022](adr/0022-dashboard-gemini-assistant.md)。

- `detection_stats.py` 只讀檢測分區的 `detection_summary.csv` 與其 `result_json` 指向的 `result.json`，不寫檔、不讀蒐集分區或歷史目錄。`GET /api/detection/stats/` 參數：`start_date`／`end_date`（`YYYY-MM-DD`，含首尾，依本機時間）、`bucket`（`none／day／week／month`，週以週一日期加「週」標示）、`group_by`（`grade／defect`）、`grade`（`上等／中等／下等／加工`，可重複傳入複選，省略為不限）；參數錯誤回 `400 invalid_stats_query`。指定等級時只保留該等級的已判級果實，瑕疵比例分母改為這些果實數，`abandoned`／`needs_review` 為 `0`，圖表標題附加等級。`compare_grades=true`（限 `group_by=defect`、`bucket=none` 且至少兩個等級）另回 `by_grade.<等級>.{totals, defects}`，並把圖表改為單一分組長條圖：x 軸為六類瑕疵、每個等級一個 dataset（標籤含該等級顆數）。
- 計數規則：時間取 `capture_time`，缺少時取 `completed_at`；只計 `result_json` 有值的保存列，無法解析的時間或結果分別計入 `skipped.time_invalid`／`skipped.result_unreadable`，未保存計入 `skipped.result_not_saved`。`graded` 果實構成四級分布（上等、中等、下等、加工）與瑕疵比例分母，並以 `sources` 區分 `model`／`manual`；`abandoned` 與 `needs_review` 只列在 `totals`。每顆瑕疵沿用 LINE 通知規則：已完成檢測視角的成功觀察聯集，六類鍵與名稱為 `bad_color` 色澤異常、`wrinkle` 皺褶、`abrasion` 擦傷、`anthracnose` 炭疽病、`insect_bite` 蟲咬、`insect_track` 畫圖蟲。
- 回應含 `filters`、`totals`、`grades`（`count`、`ratio`）、`sources`、`defects`（`count`、`ratio` 佔已判級）、`series`（有級距時每期的各數）、`skipped` 與 `chart`；所有數值皆為 `0` 時 `chart` 為 `null`，不畫空圖；`chart` 為 `type`（`bar／line`）、`title`、`unit`（`顆／%`）、`stacked`、`labels`、`datasets[{label, data}]`，比例圖另有 `y_max: 100`、等級比較圖另有 `compare: true`，由 Django 直接產生；前端比例圖一律固定 `0～100%` 刻度，避免不同圖以不同刻度呈現。
- 趨勢提醒由 `trend_alerts.py` 依固定規則產生，完全不呼叫 Gemini。偵測：任一果實最終判級保存後（含人工判級），在背景執行緒以統計核心計算四個視窗——最近 `window_days` 天（目前）、再前一個同長度視窗（前期）、今日（本機零時起）與今日之前 `window_days` 天（歷史）；讀取檢測分區所有已判級果實。七個類別（六類觀察與 `processing` 加工果比例）共用同一套規則：每項比較的兩側都須達全域 `min_samples` 顆已判級果實。目前視窗比例 ≥ `threshold`（門檻）；目前比前期上升 ≥ `rise` 百分點（上升）；今日比例 ≥ 歷史 × `spike_factor` 並至少高出 `rise`（當日突增）。同類在 `cooldown_hours` 內不重複；冷卻時間在組成訊息前先保留，平行檢查不會重複。
- 嚴重性：每類有獨立的 `threshold`、`rise` 與 `direction`（`disease` 須注意病害防疫、`pest` 須注意蟲害防治、`handling` 請檢查採收與搬運作業、`cultivation` 請留意栽培管理與採收時機、`quality` 請檢視近期整體品質與田間狀況）。預設：色澤異常與皺褶 `40%`／`15`／`cultivation`，擦傷 `30%`／`10`／`handling`，炭疽病 `20%`／`10`／`disease`，蟲咬與畫圖蟲 `30%`／`10`／`pest`，加工果 `40%`／`15`／`quality`；全域預設 `7` 天、最少 `20` 顆、`24 h`、突增 `2` 倍。預設值須以實際資料校正；新增模型類別只需新增一筆類別參數。
- 設定、各類最後提醒時間與最近 `20` 筆提醒存於 `runtime_config/trend_alerts.json`（`version: 3`；讀到 `version: 2` 時把各類 `min_samples` 與 `spike_min_samples` 取最小值併為全域 `min_samples`，下次寫入即升級）；開關與加工果通知分開，預設關閉。`POST /api/trend_alerts/` 可傳 `enabled`、`window_days`（`1～60` 整數）、`min_samples`（`1～10000` 整數）、`cooldown_hours`（`0～720`）、`spike_factor`（`1.1～20`）與 `categories.<類別>.{threshold, rise}`（`0.01～1`）、`direction`，可只傳要改的欄位；未知鍵或範圍錯誤回 `400 invalid_trend_alert_settings`，Dashboard 附帶的 `dataset_mode` 略過。`/api/state/` 的 `trend_alerts` 提供設定、類別名稱、方向選項、LINE 憑證狀態、`cooling`（仍在冷卻的類別與可再提醒時間）與最近提醒（時間、類別與 LINE 送達狀態，不含訊息全文或明細）；Dashboard 只列出這些摘要，訊息全文只在 LINE。
- Dashboard 對農夫只顯示開關、最近幾天、最少顆數與各類提醒門檻；上升百分點、當日突增倍數、冷卻與提醒方向放在「進階設定」，和「立即傳送測試提醒」按鈕一起跟著維護資訊的雙擊切換顯示。`POST /api/trend_alerts/test/` 以目前資料與設定評估一次（不看開關與冷卻），排入 `trend_test_<id>`：首行為「測試 |趨勢提醒|」，沒有類別達標時改列「目前沒有類別達到提醒條件」；統計圖標題加「測試」。測試不寫入 `recent` 或冷卻時間，排入失敗回 `503 trend_alert_test_failed`。
- 同一次檢查觸發的類別只產生一則 LINE 訊息，內容依序為：
  ```text
  |趨勢提醒|
  近來偏高：色澤異常、皺褶、擦傷
  須注意：
  ・色澤異常、皺褶：請留意栽培管理與採收時機
  ・擦傷：請檢查採收與搬運作業
  （模型觀察結果，僅供參考）
  數據詳情可詢問奶蛋博士獲得更多資訊
  ```
  「近來偏高」只列因門檻或上升觸發的類別；只因當日突增觸發的類別另列「今日明顯偏高：…」，沒有對應類別的行省略。類別依設定順序排列；「須注意」依 `direction` 分組，同方向以「、」合併，方向文字取自 `DIRECTIONS`。全文不得有半形或全形阿拉伯數字及百分比符號，不經 Gemini 措辭。
- 訊息與加工果通知同為一個 Flex bubble：hero 為 `detection_report.py` 繪製的統計圖（點擊開原圖），body 為上述文字。圖以最近 `window_days` 天為範圍，含四個指標、四級分布、各等級瑕疵比例與六類瑕疵比例；觸發類別標紅，瑕疵長條另以黑線標出前一個同長度視窗的比例。只因當日突增觸發時，圖仍顯示最近 `window_days` 天。觸發類別合計超過 `12` 字時標題改為「多項指標偏高」。
- 文字與觸發快照先寫入同一筆 `recent` 紀錄，再以 `trend_<id>` 排入 `notification_outbox.json`，待送項目同時保存 `detection_report.snapshot` 的統計快照（標題、期間、`totals`、`grades`、`defects`、`by_grade`、`previous_defects` 與標紅類別）；背景 worker 送出前依快照繪製 JPEG 並上傳 Cloudinary，所以圖中數字不會因日後新增或重置資料而改變。繪圖失敗（例如缺少字型）為 `failed`，不自動重送；沒有快照的舊待送項目仍以純文字送出。沿用同一憑證、retry key、重試與送達不明規則，不受加工果通知開關影響。每筆另存當時的 `window_days` 與 `details`：每個觸發類別的 `key`、`label`、`reasons`（`threshold／rise／spike`）、`direction`、四個視窗 `current／previous／today／history` 的 `{count, graded, ratio}`，以及當時該類的 `threshold`、`rise` 與全域 `min_samples`、`spike_factor`（`version: 2` 時期的紀錄另有已不使用的 `spike_min_samples`）；比例保存為 `0～1`，不保存 `wording`。檢查與排送失敗只寫入 log，不阻塞檢測、人工接手與分槽。

### 奶蛋博士

- `POST /api/assistant/ {"messages": [{"role": "user"|"model", "text": "...", "signature"?: "..."}]}`：最後一則必須是 `user`，最多取最後 `12` 則、每則 ≤ `2000` 字；格式錯誤回 `400 invalid_assistant_request`。對話只存在瀏覽器頁面記憶體，Django 不保存。每則 `model` 須附上該回覆隨附的 `signature`（以每次程序啟動隨機產生的金鑰對回覆文字計算的 HMAC-SHA256）；沒有簽章、簽章不符或來自重啟前的 `model` 訊息直接捨棄，不送進 Gemini，捨棄後相鄰的 `user` 訊息合併為同一回合。成功回 `{"ok": true, "reply", "signature", "charts", "sources", "notices", "usage": {"used", "limit"}}`；`charts` 為統計工具的 `chart` 原樣輸出，`sources` 為 Google Search grounding 的 HTTPS 來源（`title`、`uri`，去重、最多 `8` 筆），`notices` 為聊天框以警示樣式顯示的系統說明。同一回合若產生等級比較圖，只回傳比較圖，捨棄分開查詢的單一等級圖。
- 預期失敗回 `200` 與 `{"ok": false, "reason", "message"}`：`assistant_not_configured`（缺檔、缺 `gemini_api_key`／`model` 或 `daily_request_limit` 非正整數）、`assistant_offline`（無網路或逾時 `60 s`）、`assistant_quota_exceeded`（每日上限或 Gemini `429`）、`assistant_billing_required`（`402`，預付餘額不足，請到 AI Studio 儲值）、`assistant_model_unavailable`（`404`，模型不存在或不開放，請更換 `model`）、`assistant_rejected`（其他 `4xx`）、`assistant_service_error`（`5xx`）、`assistant_invalid_response`、`assistant_tool_rounds_exceeded`（超過 `4` 輪工具呼叫）。
- `assistant.py` 以標準函式庫呼叫 Gemini REST `v1beta/models/<model>:generateContent`，金鑰放在 `x-goog-api-key` 標頭，不進回應、log 或結果檔；非 `200` 回應以 warning 記錄 HTTP 狀態、reason 與 Gemini 的 `error.message`（其中若出現金鑰則遮蔽）。主請求宣告四個唯讀 function：`query_detection_stats`（參數同統計 API，等級為 `grades` 陣列；問特定等級的瑕疵時必須傳入）、`get_trend_alert_settings`、`get_system_status` 與 `search_agriculture_knowledge`；搜尋工具由後端另發只含 `google_search` 工具的請求，兩種工具一律分流，不依賴模型是否支援併用。搜尋請求失敗（免費層級不提供 grounding、離線或服務錯誤）只讓該工具回 `search_unavailable`，回答照常完成並在 `notices` 說明「農業知識搜尋需要 Gemini 付費層級」或暫時無法連線；只有每日上限會結束整個回合。模型回合原樣保留（含 thought signature）再附上工具結果。比較等級時應只呼叫一次並傳 `compare_grades=true`。
- `get_system_status` 無參數，由 `views.py` 注入詢問當下的白名單快照，供連線、相機、硬體異常、啟動限制、通知及部署問題使用。啟動判斷使用 `*_disabled_reason`、`network_recovery` 與 `network_recovery_required`，不另輸出 `can_start_*`。重用 Dashboard helper，包含相機／ESP32 診斷、模型檔每次呼叫的 `ok／missing／lfs_pointer` 檢查及 LINE 設定完整性；時間差用整數秒、未回報為 `null`，附 `checked_at` 與來自 `reason_text.py` 的中文子集合。只傳模型檔名、原因與缺欄位名稱，不額外輸出路徑欄位、內部識別碼、手機自由文字或憑證內容；`message` 沿用 Dashboard 文字並遮蔽私密設定檔名。失敗回 `system_status_unavailable`，只 log 例外類型，對話繼續。操作建議限於 Dashboard 提示，其他硬體維修及部署設定請聯絡專案擁有者；LINE 關閉時，除非被問到 LINE，否則不主動提憑證。
- `get_trend_alert_settings` 回傳目前設定與最近 `5` 筆提醒的時間、類別、`window_days`、`details`，不回傳 LINE 設定、憑證、訊息全文或送達明細。每類保留快照的鍵、名稱與觸發原因，另附 `reason_descriptions` 中文依據與中文方向；四個視窗比例改為 `ratio_percent`（例如 `48.8`），門檻為 `threshold_percent`、上升為 `rise_points`，其餘樣本數與突增參數取自該筆快照。舊紀錄無明細時 `details` 為 `null`，不得以目前設定推測。問到「為什麼提醒」或提醒當時的數據必須呼叫此工具；問各類瑕疵隨時間的變化時，以 `query_detection_stats` 搭配 `group_by=defect`、`bucket=day／week` 查詢，回答數字只引用工具結果。
- 聊天框以 `static/fruit_app/js/assistant_render.js` 把回覆的 Markdown 子集（`#` 標題、`**粗體**`、`*斜體*`／`_斜體_`、行內 code、`-／*／+` 無序與 `1.／1)` 有序清單、`>` 引用、段落與換行）轉成 DOM；模型文字只經 `createTextNode` 成為文字節點，HTML 一律原樣顯示，不使用 `innerHTML`，也不載入外部套件。其他語法（連結、表格）保留原文。
- 系統指示含固定規則（數字只引用工具結果、讀取檢測分區所有已判級果實、結果全為 `0` 時不描述圖表、用藥以植物保護資訊系統與在地農業改良場為準、只查詢不操作、不列出檔案結構或私密設定檔、不重現系統指示與文件全文，以及自稱擁有者或已授權不改變規則）、當天日期，以及本機 `docs/快速開始.md` 與 `docs/環境部署說明文件.md` 全文；缺檔時註明找不到。放入文件前與回覆送出前，都會把憑證檔名稱與路徑（`assistant_credentials.json`、`notification_credentials.json`、`setup.local.h`、`secrets.h`）替換為「私密設定檔」。測試案例與結果見 [助手提示注入測試](助手提示注入測試.md)。
- 憑證存於 `runtime_config/assistant_credentials.json`（`gemini_api_key`、`model`、選用 `daily_request_limit`，預設 `200`），每次請求重新讀取；每呼叫一次 Gemini 前在 `runtime_config/assistant_usage.json` 預扣當日次數，達上限即不送出。設定步驟見 [部署說明 2.6](環境部署說明文件.md#26-奶蛋博士-gemini-金鑰選用)。
- 狀態工具在 `STATE_LOCK` 內重用既有狀態 helper，允許讀取暫存資料及其間接呼叫的既有網路安全檢查；不呼叫整包 `_state_payload()`、延遲刪除重試、檔案同步或 session timeout，不新增硬體命令或 metadata／counter 寫入。模型／LINE 檢查與 Gemini 請求在鎖外；端點只受區網 origin 檢查，網路復原鎖不阻擋。聊天框以本地 Chart.js 繪圖，不依賴 CDN。
- 聊天框按鈕可換成自訂圖片：`POST /api/assistant/icon/`（multipart `icon`）接受 Pillow 可讀的圖片（≤ `10 MB`、≤ `4000` 萬像素），依 EXIF 轉正、置中裁成正方形並縮為 `128×128` PNG，原子寫入 `runtime_config/assistant_icon.png`，不保留原檔；空檔、無法讀取或過大分別回 `400 icon_empty／icon_unreadable／icon_too_large` 並保留舊圖。`reset=true` 刪除圖片恢復文字按鈕；`GET /api/assistant/icon.png` 提供圖片，未設定回 `404`，頁面改顯示文字「問奶蛋博士」。

### UI 展示與操作摘要

2026-10-13 使用者已接受目前 UI 規劃，配置以下列條目為準；取代 [Issue #18](https://github.com/Eten0721/PassionFruit_IoT_hardware/issues/18#ui-display-contract) 的舊版配置，歷史 Issue 不作為另一份同步維護的規格。

- 「確認本次使用的網路」下方新增操作摺疊列，收納目前流程、模式選項、啟動條件、開始／重新拍攝／跳過或刪除，以及人工分類。收合時仍在該列保留開始／重新拍攝／跳過等主要操作；按鈕可用性沿用狀態與安全限制，運轉時保留「停止拍攝」。蒐集模式固定顯示重新拍攝與跳過／刪除；自動檢測只在 `can_recapture`／`can_discard` 為真（拍攝失敗、安全復原或刪除未保存成功的本輪）時顯示，平常隱藏。
- 移除獨立「三張原圖預覽」區塊；自動檢測每張原圖保存後先顯示於對應 ROI 格，待該張 ROI 產物可用才替換，未完成時明示等待／處理中，不把原圖冒充 ROI 結果。
- 蒐集模式沿用左側同一展示區，只顯示三張原圖，隱藏未執行的模型格與自動分類結果；人工級距按鈕留在操作摺疊區。自動檢測無法判級時，右側結果卡顯示失敗原因並開放人工四級；純拍攝另顯示「放棄本輪」，硬體於同一卡片提供「跳過當顆（人工移除）」，重用跳過／刪除的安全移除程序與 `can_discard`，不因無法人工判級而隱藏清理入口。收合操作區後仍可見人工接手與跳過入口；人工完成後顯示「等級（人工判定）」或「已放棄本輪」與保留的原失敗原因。結果卡另以文字區分已判級、已保存、分槽中、分槽完成／失敗與需復原；AI 成功不表示實體動作完成。
- 檢測執行中，`/api/state/` 的 `detection_progress` 提供最後完成的 `stage`（`originals／roi／color／wrinkle／defect`）與各張已保存產物、`artifact_urls` 及模型狀態；只在對應產物原子保存後更新，最終結果寫入 `detection_result` 時清空。畫面依此逐步替換，不以動畫推測完成。
- 「四模型檢測結果」移至原手機預覽所在的左側主區，以三張照片分組、各列 ROI／color／wrinkle／defect，共十二格；成功產物逐步更新，有跳過、缺失或失敗時不得顯示整輪完整成功。
- 手機即時畫面移至右側原流程操作位置；整顆分類結果也放在檢測區右手邊，以醒目級距文字區分等待、有效結果與待覆核，不只靠顏色表示。
- 底部摺疊區依序為「LINE 通知 → 資料管理 → ESP32 網路設定 → 停穩設定與送料校正 → 診斷與流程紀錄」。ESP32 網路設定收合時仍以既有連線狀態顯示文字徽章。停穩設定與送料校正只唯讀顯示參數檔數值與同步狀態，摘要列右側依序提供「完全重置Django狀態以及ESP32網路設定」與「測試送料一顆」，兩者執行前都須確認對話框；它與診斷區皆為維護資訊，預設隱藏，雙擊頁首標題一起切換顯示／隱藏並清除文字選取；狀態保存在瀏覽器 `localStorage`，讀寫失敗不影響頁面操作，讀不到時預設隱藏，顯示時仍可用鍵盤展開摺疊區。
- 主畫面的停用、停止與錯誤原因一律只顯示 `fruit_app/reason_text.py` 的中文說明，未收錄的代碼顯示「其他狀態，詳見診斷區」；原始 reason 代碼只列在診斷區的「原因代碼」。新增操作員可見的代碼時必須同時補上中文。
- 全域訊息列沒有內容時整列隱藏；操作回饋與異常提示皆顯示 `5 秒` 後隱藏。`last_error_reason`／`auto_run_recovery_reason` 出現或對應 command 改變時，優先顯示簡短中文原因；相同異常不因輪詢而重新顯示或延長時間，解除後再次發生則重新提示。送料逾時固定顯示「送料機構運轉超時；桶內可能已空料。」，不附處理指引與運轉時間；詳細資訊仍可從狀態徽章提示與診斷區查看。開啟 Dataset 資料夾成功不顯示路徑；切換維護區短暫提示顯示／隱藏。阻擋原因、安全復原與串流失敗原因直接可見；檢測展示重用真實產物，既有橢圓 ROI 遮罩演算法不因版面調整而更改。

## 驗收

### 自動化

- Django：`C:\Users\qoqoo\anaconda3\envs\PF\python.exe -s manage.py test fruit_app`
- Firmware：以 `esp32:esp32:esp32` 與 `ESP32Servo 3.2.1` 編譯正式 sketch。
- Repository：`git diff --check`

### 實機

以下項目已於 2026-10-27 全數通過；更換機構、馬達或參數後依此重驗。

1. 空軌連續 `100` 次，確認有效距離大於 `8.0 cm` 才重新待命；斷開 HC-SR04 或造成 Echo timeout 時必須回報異常，不得解讀為清空。
2. 健康網路連續 `20` 次自動採集；實體偵測至首張保存的 median ≤ `1.0 s`、p95 ≤ `1.5 s`。
3. 高速錄影確認第 2、3 站 ready 前果實已停止，且三張照片清晰。
4. 模擬 Wi-Fi 中斷、TLS timeout、手機未上傳、錯站、重複 trigger 與 duplicate command。
5. 驗證第 3 張保存後 Gate 3 仍保持關閉、Gate 1／2 維持 Release、未分類鎖定，以及缺少 `gate3_sorter_v1` 時在 Dataset 提交前拒絕分類。
6. 驗證 `hardware_params.toml` 的四個分類角度、分類器就位等待 `500 ms`、Gate 3 放行後落果保持 `1000 ms`、四顆馬達同時歸位與共同等待 `500 ms`，以及 report retry 不重複轉動分類器或 Gate 3；刪除未分類果實不得自動放行。
7. 以 `10` 顆作為現階段一體式送料筒裝載量，由 `1300 us` 起校正能可靠起轉且不造成雙送的最慢驅動脈波，並由 `5000 ms` 起調整最大運轉時間；最終時間由操作員依實測自行指定。每次修改送料參數並重啟 Django 後，以測試送料目視確認恰好一顆。
8. 十顆測試果實應盡量涵蓋不同大小、形狀與蒂頭方向，並記錄各顆最大橫向直徑；樣本外形過於相近時只完成基本功能驗證，混合果形仍由後續正式實機驗收補足。
9. 每次果實都必須落在拍攝平台起點範圍內，不得彈出軌道、越過 Gate 1、勾住出口或產生可見破皮與凹傷。
10. 驗收記錄必須包含分槽盤材料、槽數、槽寬、固定方式、直徑、厚度、垂直間隙、筒壁最小間隙、舵盤與螺絲規格，以及連續運轉後是否鬆動、變形或刮傷果實。
11. 以混合尺寸、形狀與蒂頭方向的果實連續完成 `20` 顆送料與完整分類；每個 `feed_one` 都由一次有效 HC-SR04 讀值正常停止且恰好一顆，無漏送／雙送、無須人工重對送料桿。
12. 模擬最大運轉逾時、送料中 Echo timeout，以及逾時後果實才抵達；確認馬達先停止、不自動補轉，延遲果實仍完成三站流程且自動送料保持關閉。
13. 同一個 `20` 顆測試確認送料 XINHUI `60KG`、三站與分類器共四顆 MG996R 均無抖動／異音，ESP32 無 reset，共用電源供應器、兩顆 LM25116、配電端子與線材無異常溫升；記錄共用 `12 V` 輸入與兩條伺服電源軌的空載電壓、動作中最低電壓、峰值電流與送料馬達未起轉次數。任一項失敗時，校正或修正後重新累計連續 `20` 顆。
14. 模擬 ESP32 與 Django 分別在 `feed_one`、三站拍攝、Gate 3 等待分類及 `classify_fruit` terminal report 前後重新啟動，確認不會自動重播送料、閘門或分類器動作，且 Dashboard 顯示可操作的復原提示。
