Eten0721/PassionFruit_IoT_hardware/record_image/電源供應器接線注意事項.md

目前的接線配置是：**一顆 12 V 電源供應器，接兩個 LM25116 降壓模組；一路供四顆 MG996R，另一路供鑫輝 60KG。ESP32 經 LM2596 由同一顆電源供應器供電，不接馬達電源軌，所有裝置共地。**

**① 市電接到電源供應器**

所有接線都要在拔掉插頭後進行。

| 電源線 | 電供端子 | 用途 |
|---|---|---|
| 棕線 | `L` | 市電火線 |
| 藍線 | `N` | 市電中性線 |
| 綠黃線 | `⏚／FG` | 保護接地 |

**② 電供接到降壓模組**
# 降壓模組的電流(CC)請直接順時針轉到最大，馬達會依據負載決定吃多少電流。

兩個模組的輸入並聯接到同一顆電供：
| 電供端子 | 連接位置 |
|---|---|
| `V+`，約 `12 V` | 模組 A、B 的 `IN+` |
| `V−` | 模組 A、B 的 `IN−` |

兩個模組的輸出則分開：
⚠️ 調整原則： 在不接馬達/開發板（空載）時通電，用萬用錶量測輸出端進行調整。

* 旋轉規律： 順時針（右轉）= 加大；逆時針（左轉）= 減少。精密螺絲需轉 20 幾圈才會有明顯變化。

| 模組設備 | 目標電壓 | 電流（CC）小螺絲調整方法 | 專職負責供應對象 |
|---|---|---|---|
| LM25116 (第 1 台) | 🔴 6.0V | 順時針轉到最大（放寬電流限制） | 4 顆 MG996R 馬達 |
| LM25116 (第 2 台) | 🔵 8.4V | 順時針轉到最大（放寬電流限制） | 1 顆 鑫輝 60KG 大馬達 |
| LM2596 | 🟢 7.0V | 不需特別調整（此模組通常僅限流 2A~3A） | ESP32 擴充板、5V COB 燈條 |

MG996R 原廠標示工作電壓為 `4.8～6.6 V`，這次採 `6.0 V`。[TowerPro 規格](https://towerpro.com.tw/product/mg996r/)

`CV` 調整輸出電壓，`CC` 調整限流門檻。先前提到四顆 MG996R 預留約 `10 A`、鑫輝堵轉約 `6.2 A`

**③ ESP32 與五顆馬達**

訊號線沿用正式 Firmware 的 GPIO 配置：

| 馬達 | 訊號線接到 | 電源來源 |
|---|---|---|
| MG996R 第一顆 | `GPIO 18` | 模組 A |
| MG996R 第二顆 | `GPIO 19` | 模組 A |
| MG996R 第三顆 | `GPIO 21` | 模組 A |
| MG996R 第四顆 | `GPIO 25` | 模組 A |
| 鑫輝 60KG | `GPIO 23` | 模組 B |

ESP32 GND端 **直接拉到電源供應器的V-端實現共地**，**不要經過 麵包板 或 ESP32 的電源腳位。**

**④ 線材怎麼用**

| 區段 | 使用方式 |
|---|---|
| ESP32 → 馬達訊號線 | 可用杜邦線 |
| 電供 → 降壓模組 | 使用20AWG |
| 降壓模組 → 馬達正極、負極 | 使用20AWG |

**⑤ 通電與離線測試**

先不接馬達，完成市電側接地與遮蔽後，量測兩個模組的輸出：

- 電表黑棒插 `COM`，紅棒插 `VΩmA`，轉到直流電壓 `20 V` 檔。
- 紅棒量 `OUT+`、黑棒量 `OUT−`，確認模組 A 為 `6.0 V`，模組 B 符合鑫輝實機額定電壓。
- 拔掉電源、確認輸出已下降，再接馬達與 ESP32。
- 按 ESP32 的 **BOOT 按鈕**執行五顆馬達測試程式 `Five_Servo_Power_Test`（臨時測試用，未納入本 Repository）。

測試流程為：`18 → 19 → 21 → 25` 依序轉到 `90°`，`23` 轉動 `3 秒` 後停止，四顆 MG996R 再回到 `0°`。鑫輝的實際方向與停止點仍需校正；上電時不要按住 BOOT。

## ⚡ 電源分流（防雜訊、防過熱）

* 馬達電： 12V 電供 ➡️ 兩台 LM25116 ➡️ 分別直餵 6V 與 8.4V 給馬達的正負極。
* 控制電（ESP32）： 12V 電供 ➡️ LM2596（調至 7V） ➡️ 剪線後的 DC 接頭（紅線鎖 OUT+，黑線鎖 OUT-） ➡️ 插進 ESP32 擴充板（6~9V 孔）。

## ❌ 絕對禁止的操作（高危險）

   1. 嚴禁將馬達的 6V 或 8.4V 電源正極踫觸到 ESP32 的 3.3V/5V 引腳。
   2. 嚴禁將 5V 的 COB 燈條直接接入 12V 電供或 8.4V 模組。
   3. 不建議將 ESP32 擴充板與 4 顆 MG996R 馬達直接並聯在同一個 6V 輸出（除非在馬達端並聯 35V 1000uF 以上的大電容擋雜訊）。
   4. 嚴禁將 HC-SR04 Echo 直接接到 ESP32；6V 與 8.4V 輸出正極不得互接。

## HC-SR04 Echo 分壓

Echo 輸出約 `5 V`，ESP32 GPIO 不耐 `5 V`，必須分壓：

```text
HC-SR04 Echo --- R1 2.2 kΩ ---+--- ESP32 GPIO 27
                              |
                            R2 3.3 kΩ
                              |
GND --------------------------+--- ESP32 GND
```

輸入端約 `3.0 V`，必須實測 ≤ `3.3 V`、絕不超過 `3.6 V`。R1、R2 裝反會過壓，不可只用單一串聯電阻。

## 上電前檢查

1. 拔掉市電，檢查保護接地、端子遮罩、極性、裸線、分壓電阻位置與所有 GND。
2. 不接負載，量測模組 A `6.0 V`、模組 B `8.4 V`，再完全斷電。
3. 先只接 ESP32 與 USB 確認可燒錄、啟動，再接 HC-SR04 量 Echo 峰值。
4. 先接模組 A 與四顆 MG996R 確認歸位與行程，斷電後再接模組 B 與鑫輝，確認停止脈波不爬行。
5. 任何電擊感、電腦黑屏、異常溫升或 ESP32 reset，立即拔市電停止測試。

## 移除卡住或未分類的果實

Dashboard「停止拍攝」只是優雅暫停，不是緊急斷電；刪除未分類果實也不會自動開 Gate 3。伸手前先斷開伺服電源、確認分槽盤與閘門靜止，移除後手離開再恢復供電。

實機驗收項目見 [CAPTURE_SPEC.md](../docs/CAPTURE_SPEC.md#實機)；機構決策見 [ADR-0016](../docs/adr/0016-hardware-platform-feeder-sorter-redesign.md)。
