Eten0721/PassionFruit_IoT_hardware/docs/adr/0011-anthracnose-veto-ai-contract.md

# ADR-0011：炭疽病一票否決 AI 契約

- Status: Superseded
- Date: 2026-07-22
- Superseded by: [ADR-0012](0012-defect-ratio-ai-contract.md)

## Context

早期 AI 契約曾把炭疽病陽性視為直接輸出加工的硬規則。

## Decision

經門檻判定為炭疽病陽性時，不進入一般四分類模型，直接輸出加工。

## Consequences

實地資料顯示炭疽註記跨越多個人工級距，疾病名稱不能單獨決定品質。本 ADR 不得用於新模型。
