Eten0721/PassionFruit_IoT_hardware/record_image/[目前採用]送料機構實機圖.png

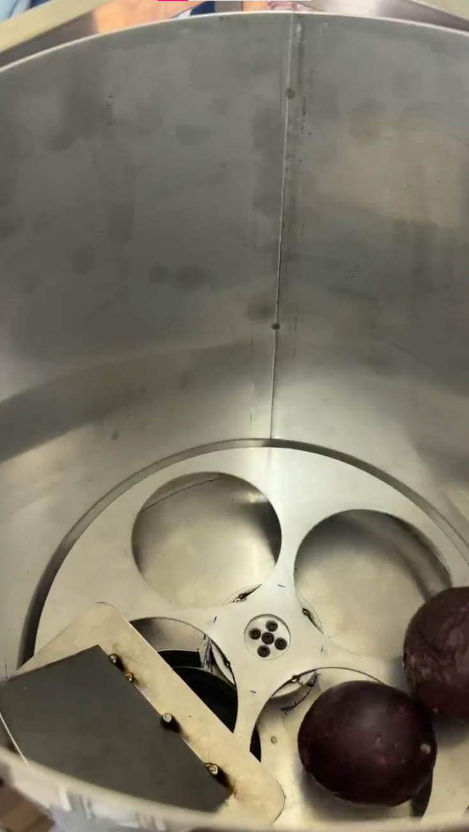
record_image/[目前採用]送料機構實機圖.png
