Eten0721/PassionFruit_IoT_hardware/record_image/AI助手_初始畫面.png

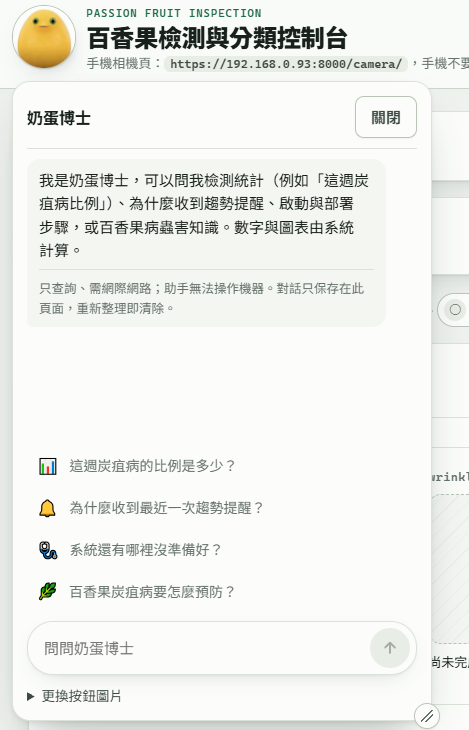
record_image/AI助手_初始畫面.png
