Eten0721/PassionFruit_IoT_hardware/record_image/AI助手_四級分布.png

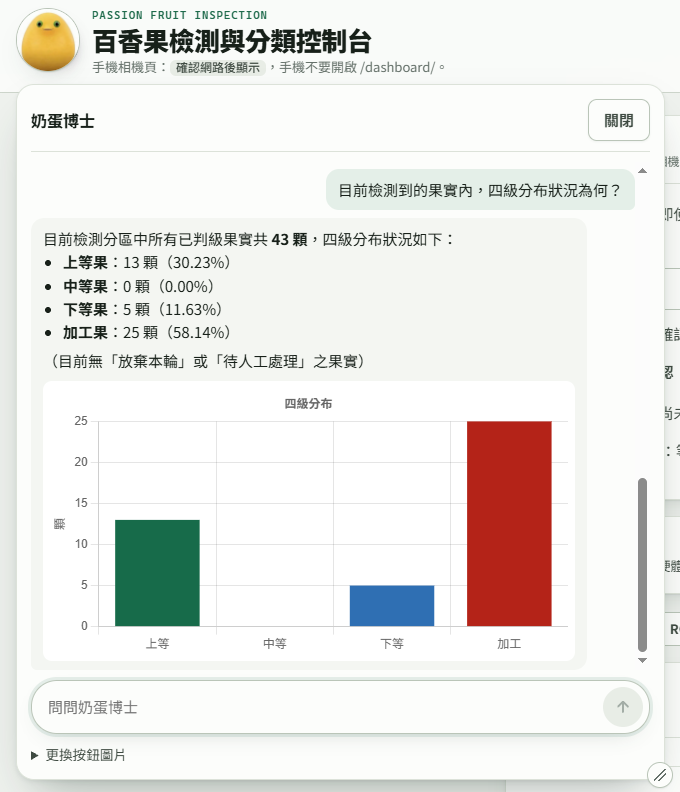
record_image/AI助手_四級分布.png
