Eten0721/PassionFruit_IoT_hardware/record_image/AI助手_特定級距瑕疵分布.png

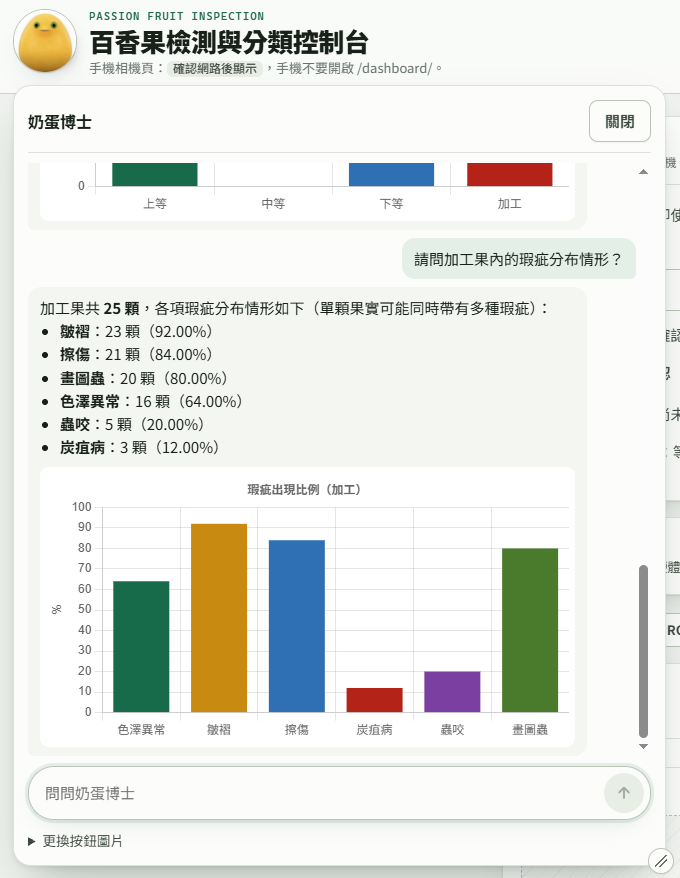
record_image/AI助手_特定級距瑕疵分布.png
