Eten0721/PassionFruit_IoT_hardware/record_image/AI助手_知識搜尋.png

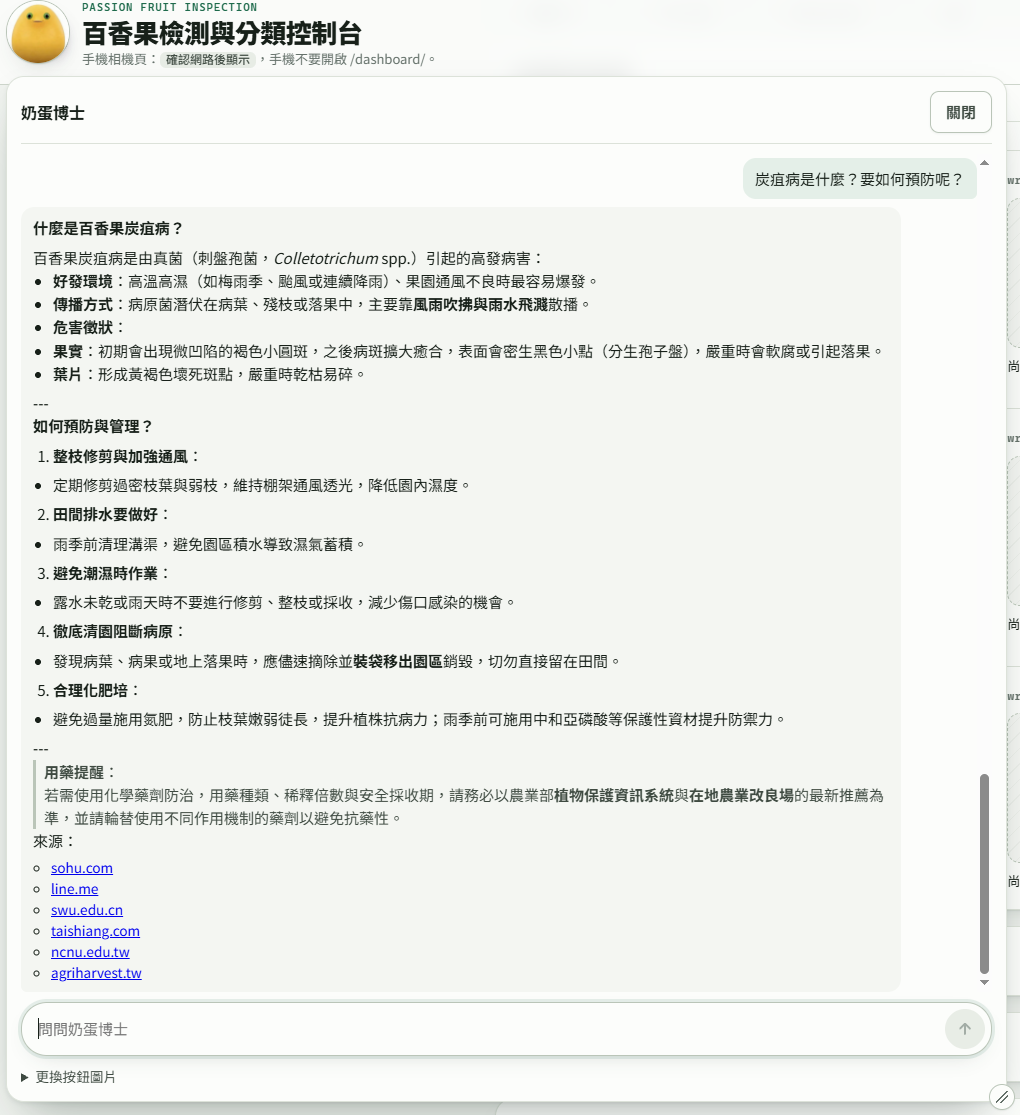
record_image/AI助手_知識搜尋.png
