Eten0721/PassionFruit_IoT_hardware/record_image/AI助手_系統確認.png

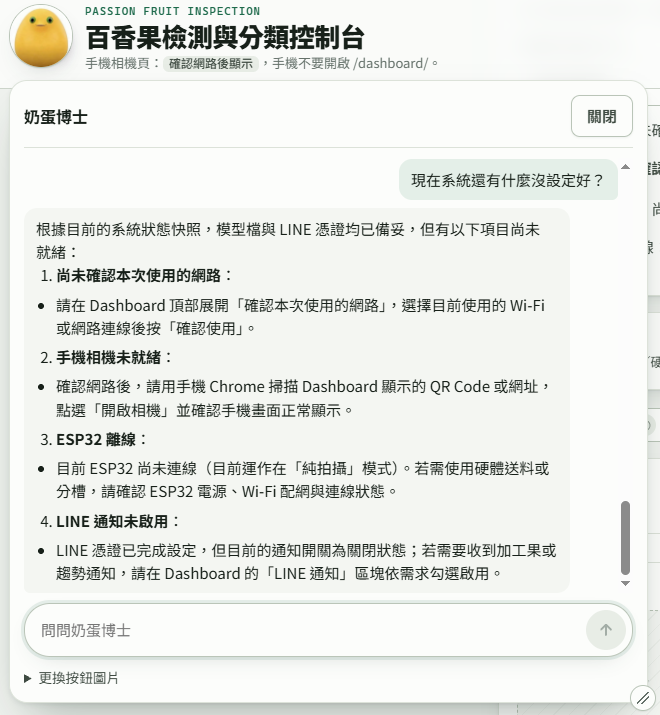
record_image/AI助手_系統確認.png
