Eten0721/PassionFruit_IoT_hardware/record_image/AI助手_趨勢提醒.png

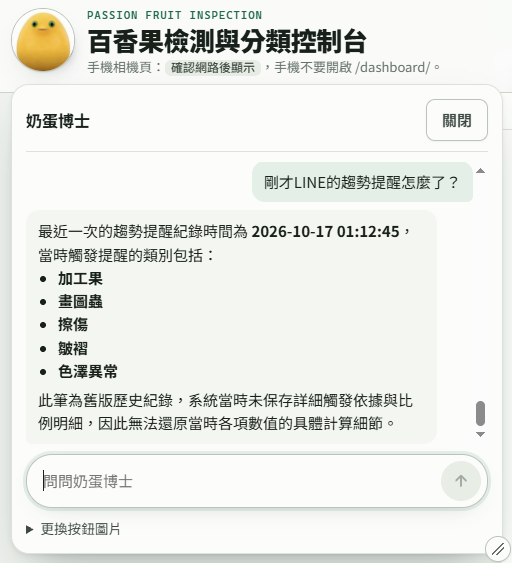
record_image/AI助手_趨勢提醒.png
