Eten0721/PassionFruit_IoT_hardware/record_image/ChatGPT 圖像 2026年10月11日 下午06_54_12.jpg

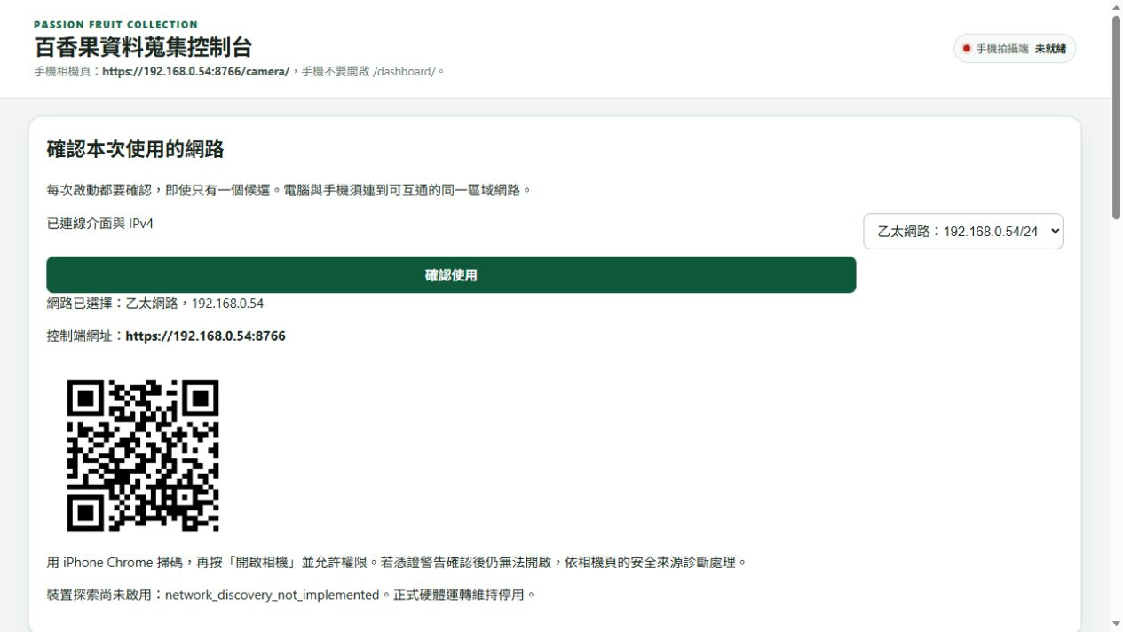
record_image/ChatGPT 圖像 2026年10月11日 下午06_54_12.jpg
