Eten0721/PassionFruit_IoT_hardware/record_image/Dashboard截圖.png

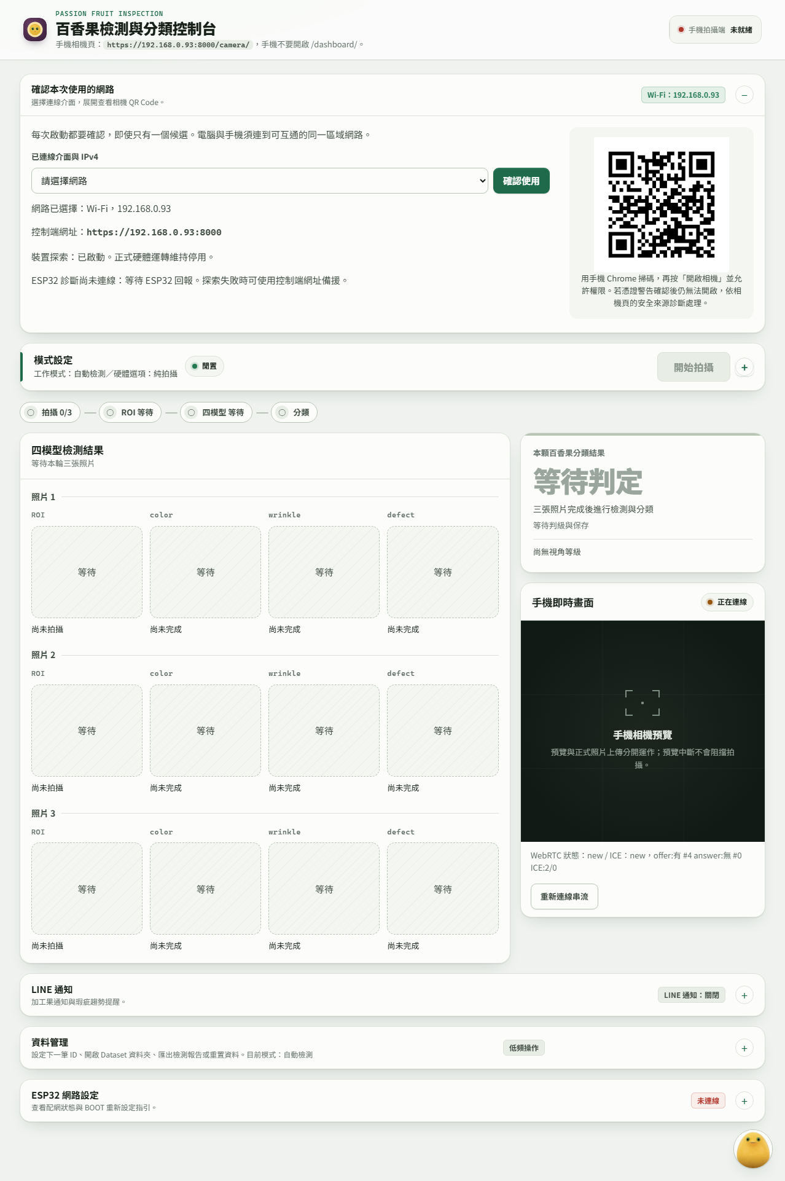
record_image/Dashboard截圖.png
