Eten0721/PassionFruit_IoT_hardware/record_image/dashboard網頁示例圖.jpg

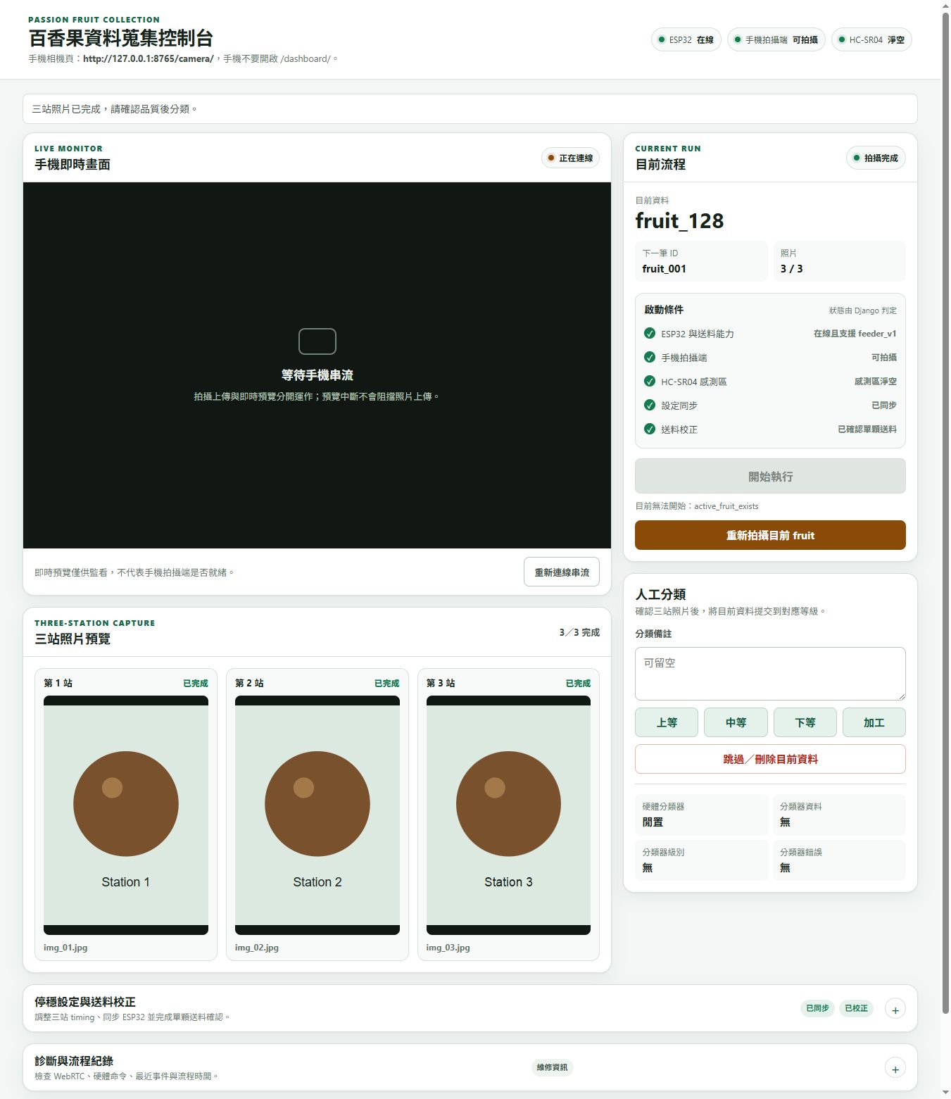
record_image/dashboard網頁示例圖.jpg
