Eten0721/PassionFruit_IoT_hardware/record_image/LINE_瑕疵通知.png

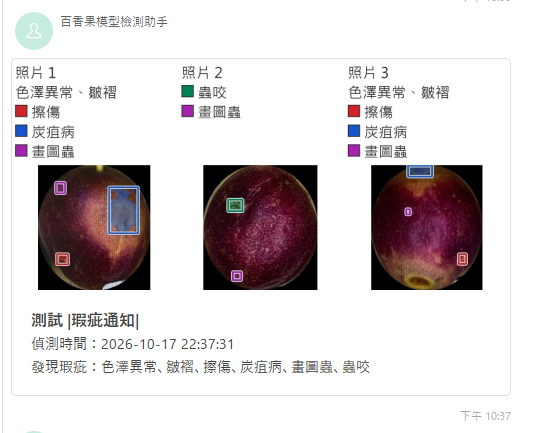
record_image/LINE_瑕疵通知.png
