Eten0721/PassionFruit_IoT_hardware/record_image/不知道反正都丟進來/ESP32 擴展板.png

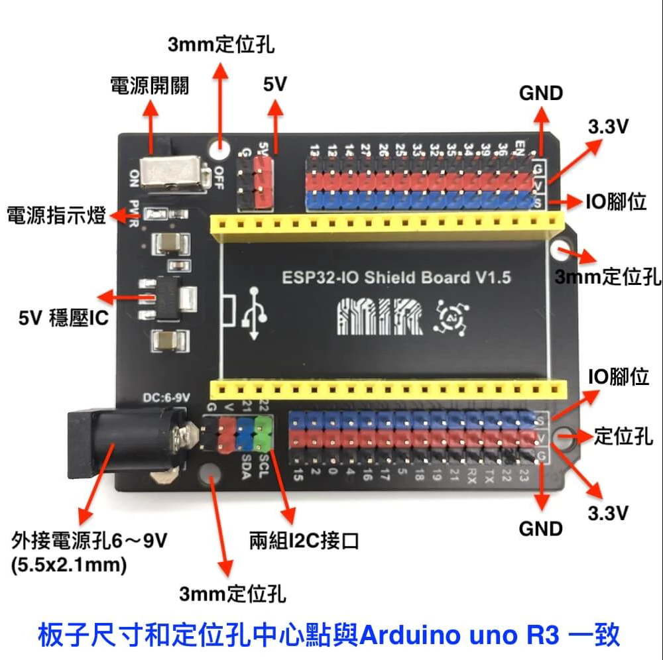
record_image/不知道反正都丟進來/ESP32 擴展板.png
