Eten0721/PassionFruit_IoT_hardware/record_image/不知道反正都丟進來/HC-SR04接線方法.png

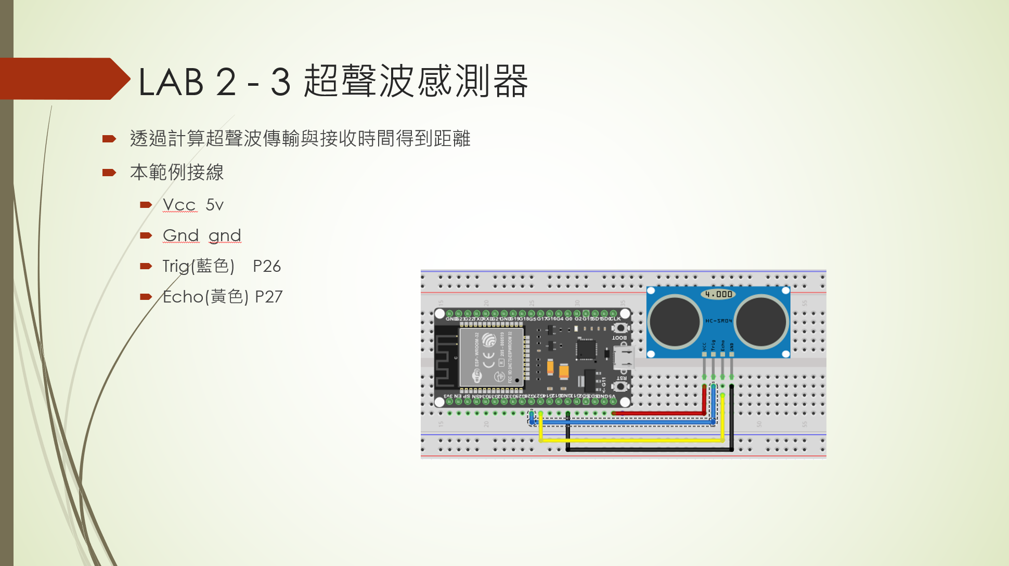
record_image/不知道反正都丟進來/HC-SR04接線方法.png
