Eten0721/PassionFruit_IoT_hardware/record_image/不知道反正都丟進來/LM2596降壓板.png

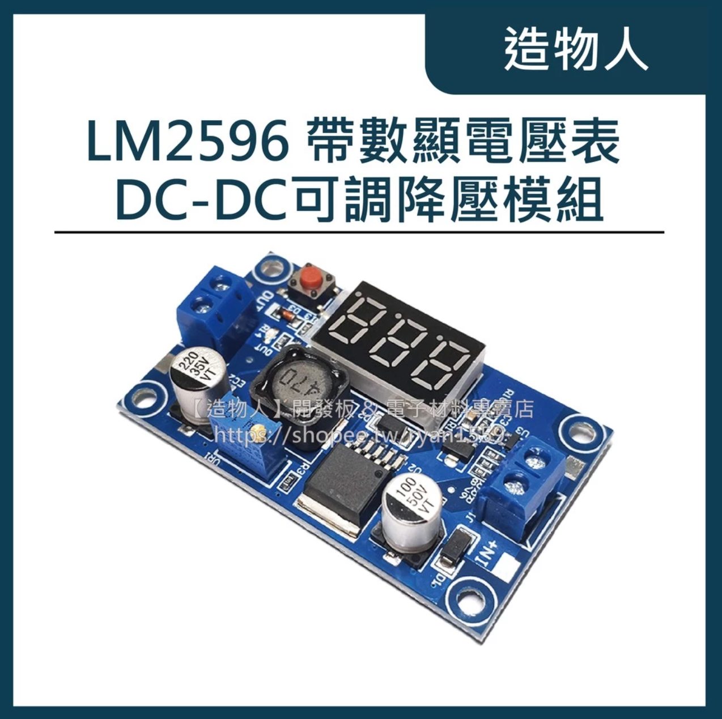
record_image/不知道反正都丟進來/LM2596降壓板.png
