Eten0721/PassionFruit_IoT_hardware/record_image/不知道反正都丟進來/MG996R_接線(需外接四顆3號電池).png

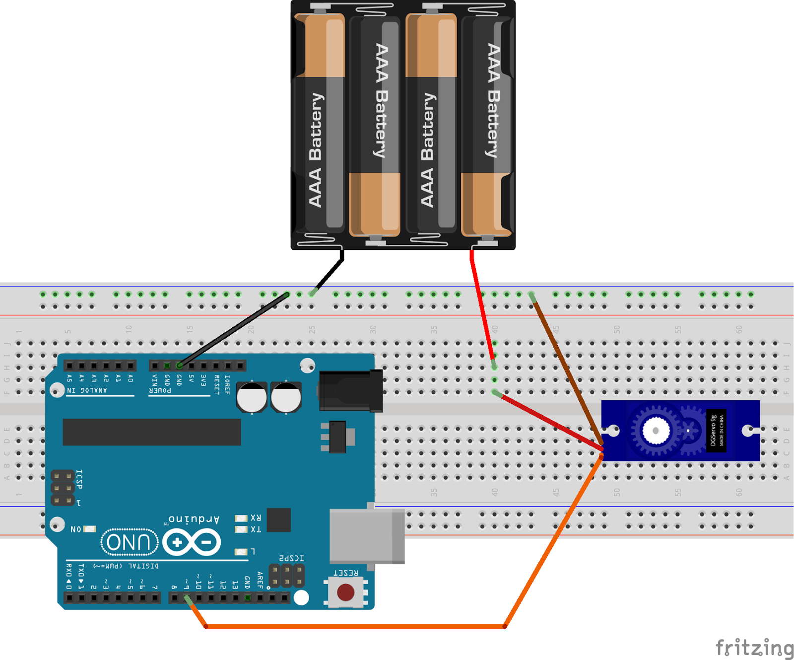
record_image/不知道反正都丟進來/MG996R_接線(需外接四顆3號電池).png
