Eten0721/PassionFruit_IoT_hardware/record_image/不知道反正都丟進來/伺服馬達SG90_程式庫與接線方式.png

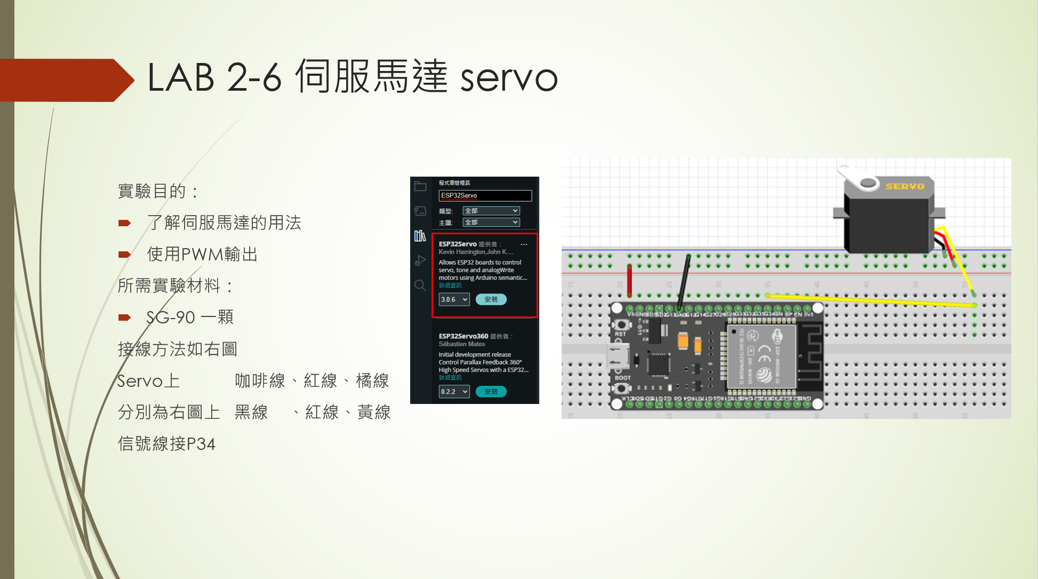
record_image/不知道反正都丟進來/伺服馬達SG90_程式庫與接線方式.png
