Eten0721/PassionFruit_IoT_hardware/record_image/分類器_第二版本.png

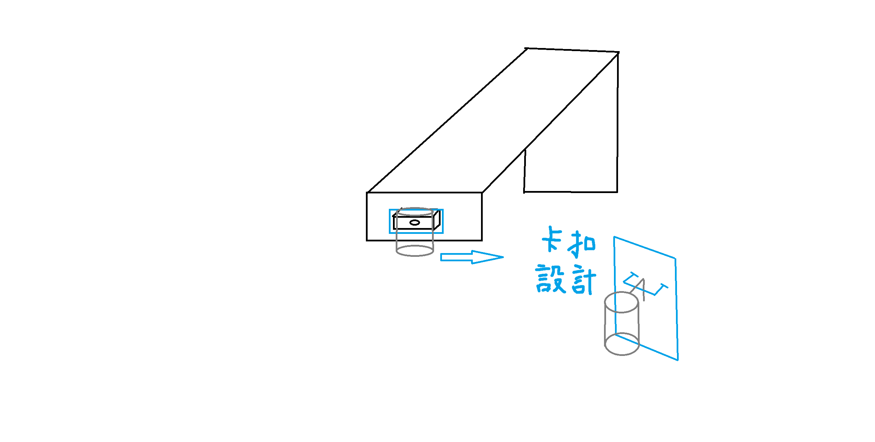
record_image/分類器_第二版本.png
