Eten0721/PassionFruit_IoT_hardware/record_image/分類器討論圖.png

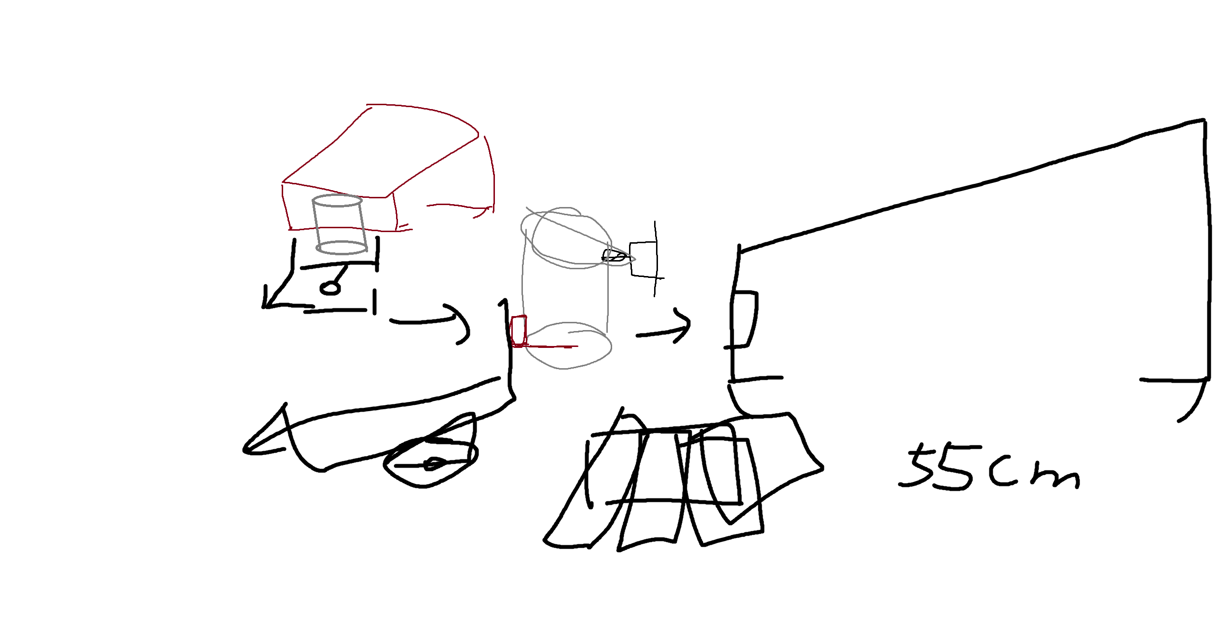
record_image/分類器討論圖.png
