Eten0721/PassionFruit_IoT_hardware/record_image/實際硬體圖/5b6e8a58-3e24-4935-8b29-f7c4427a6162.png

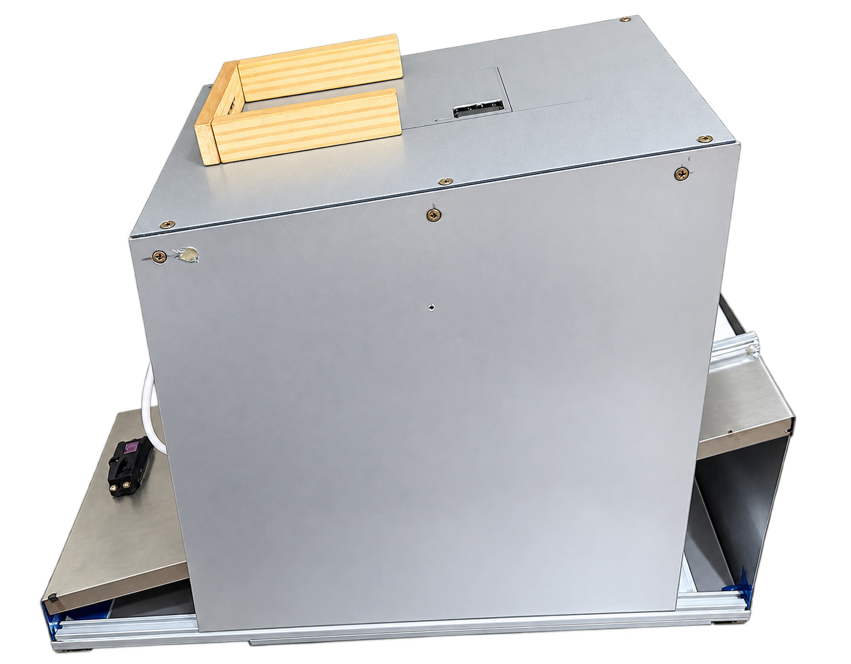
record_image/實際硬體圖/5b6e8a58-3e24-4935-8b29-f7c4427a6162.png
