Eten0721/PassionFruit_IoT_hardware/record_image/實際硬體圖/1010更新_實際裝置圖_電源供應改良版.JPG

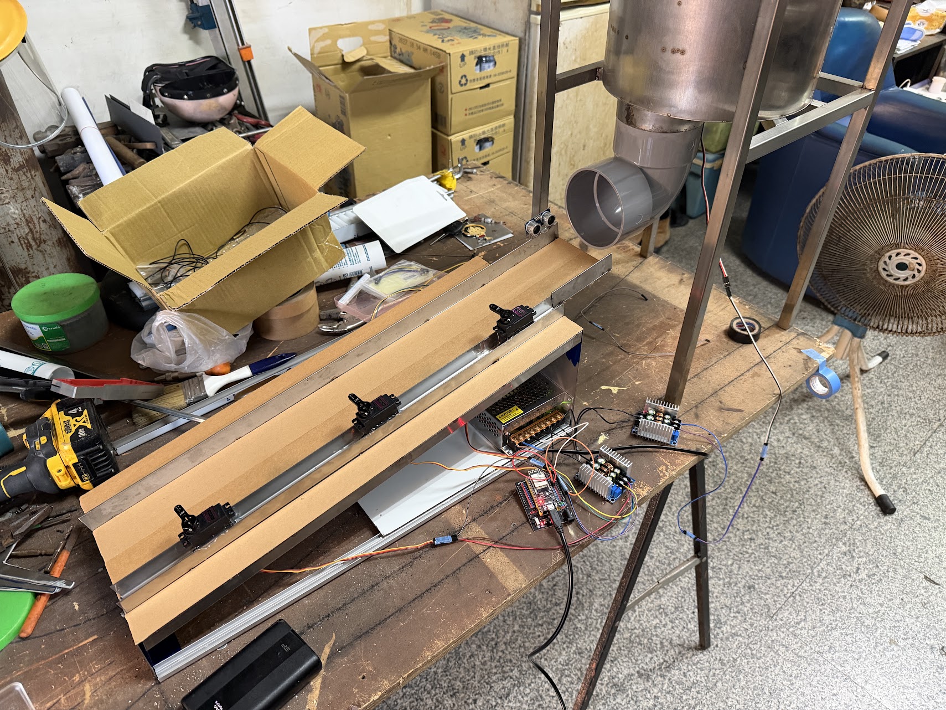
record_image/實際硬體圖/1010更新_實際裝置圖_電源供應改良版.JPG
