Eten0721/PassionFruit_IoT_hardware/record_image/實際硬體圖/ChatGPT 圖像 2026年10月2日 上午12_40_11.png

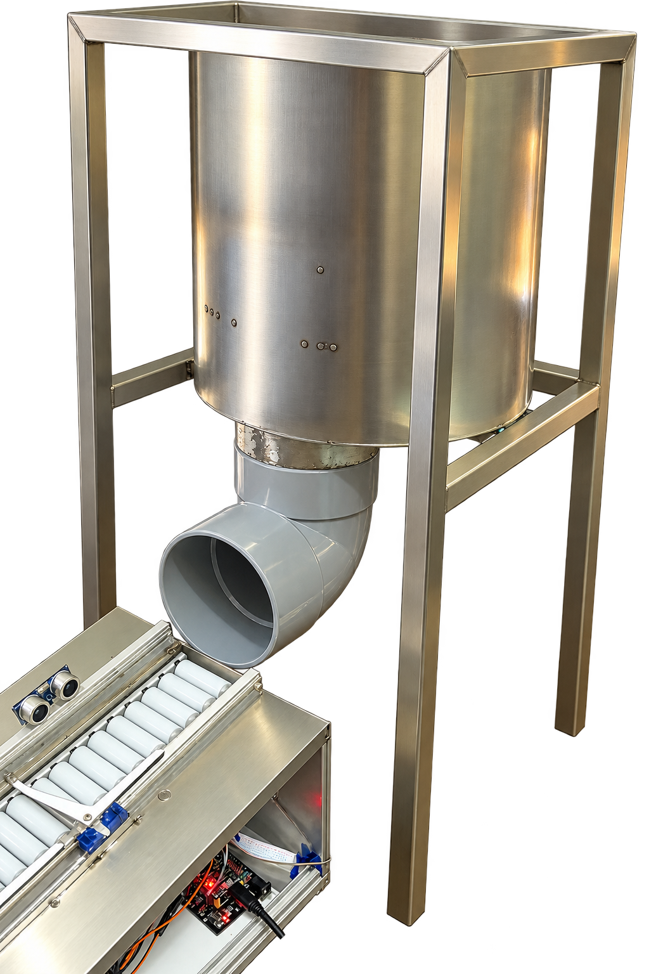
record_image/實際硬體圖/ChatGPT 圖像 2026年10月2日 上午12_40_11.png
