Eten0721/PassionFruit_IoT_hardware/record_image/實際硬體圖/IMG_5285.JPG

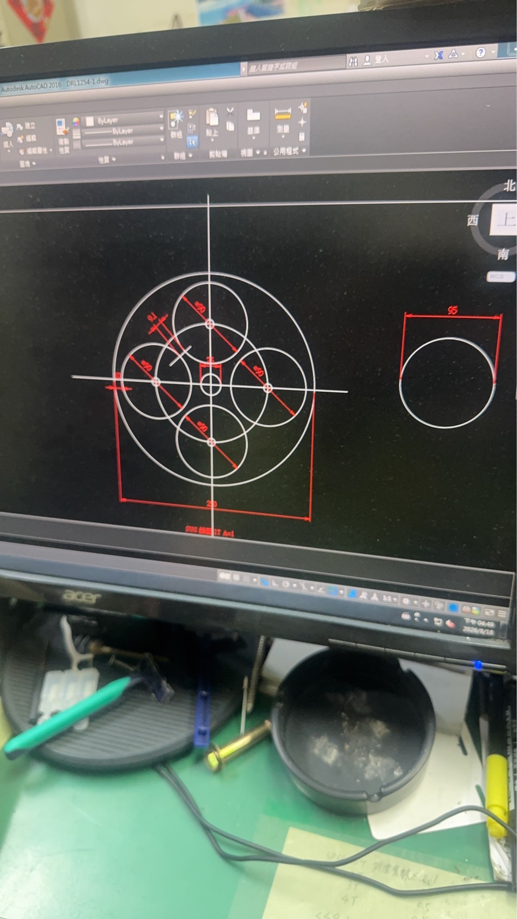
record_image/實際硬體圖/IMG_5285.JPG
