Eten0721/PassionFruit_IoT_hardware/record_image/實際硬體圖/實際硬體圖.png

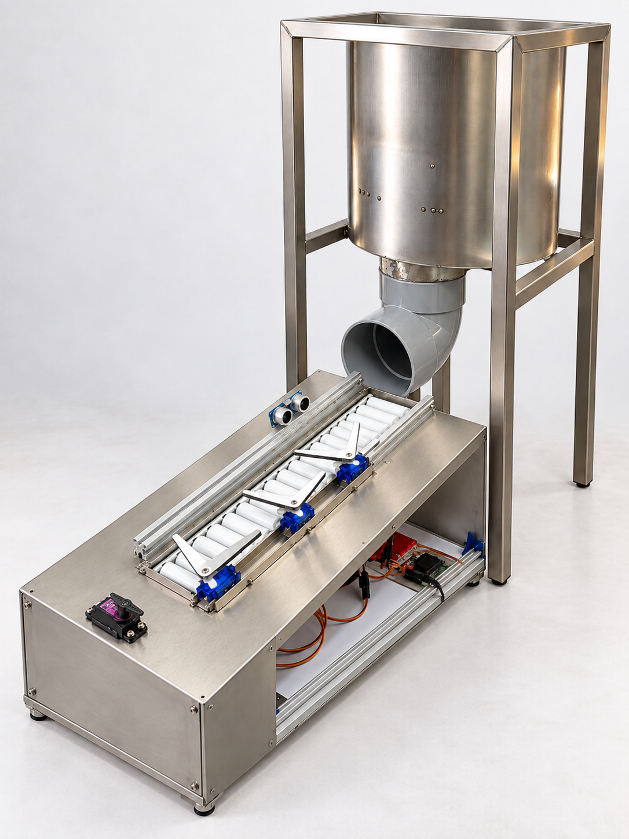
record_image/實際硬體圖/實際硬體圖.png
