Eten0721/PassionFruit_IoT_hardware/record_image/實際硬體圖/手稿設計圖/送料機構設計圖_第二版.png

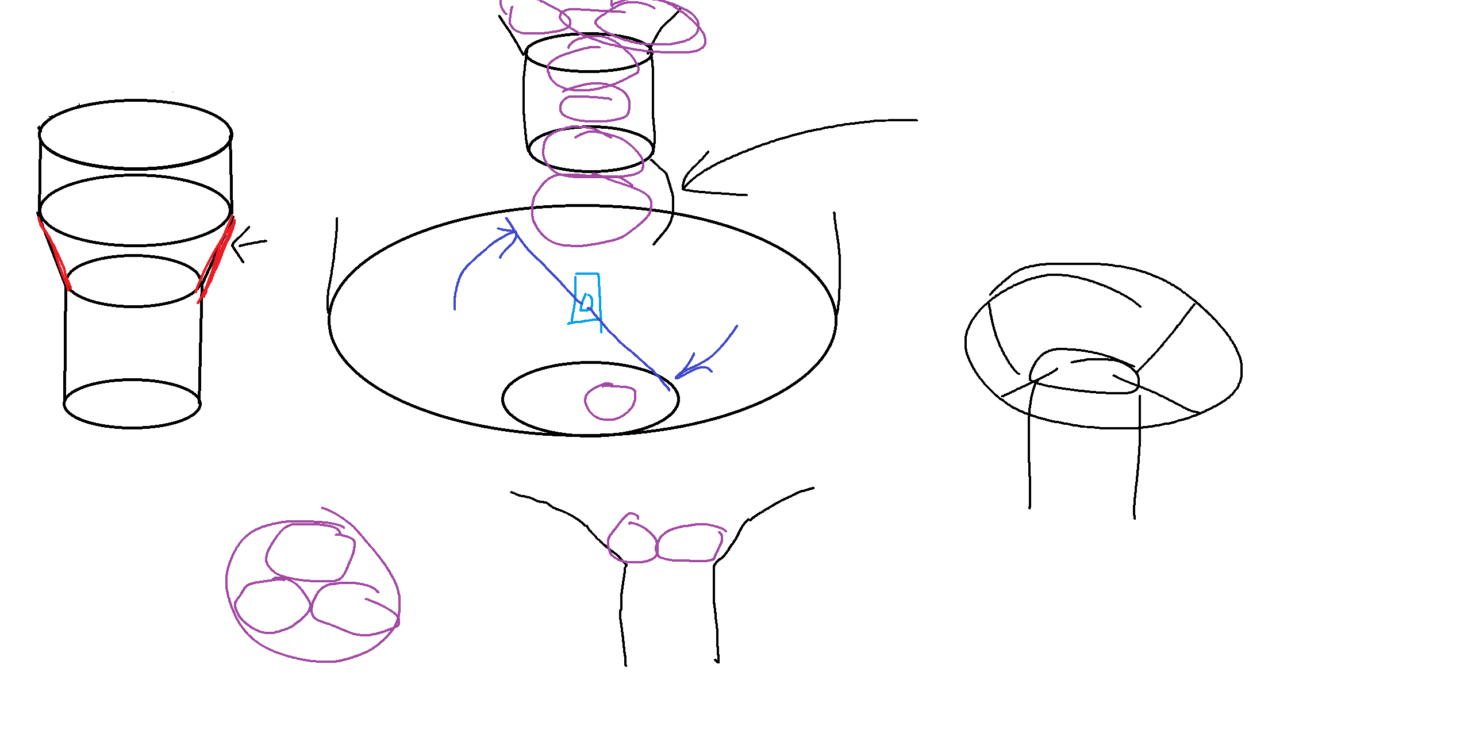
record_image/實際硬體圖/手稿設計圖/送料機構設計圖_第二版.png
