Eten0721/PassionFruit_IoT_hardware/record_image/實際硬體圖/拍攝平台不帶遮光罩.JPG

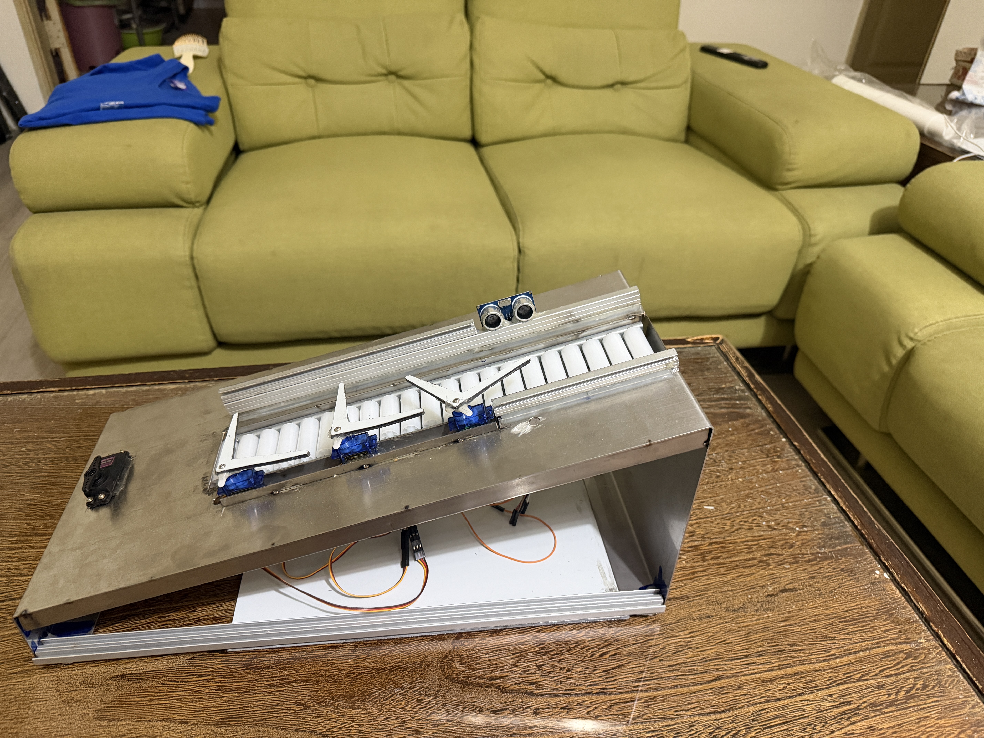
record_image/實際硬體圖/拍攝平台不帶遮光罩.JPG
