Eten0721/PassionFruit_IoT_hardware/record_image/實際硬體圖/拍攝平台帶遮光罩內部.png

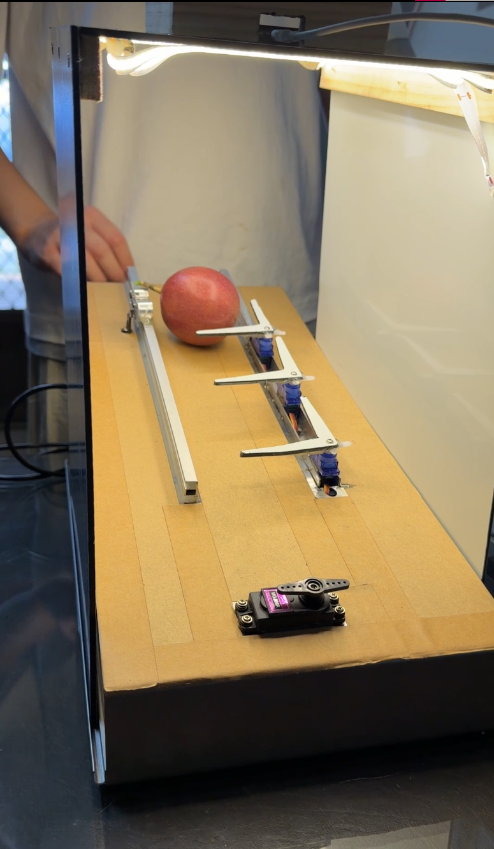
record_image/實際硬體圖/拍攝平台帶遮光罩內部.png
