Eten0721/PassionFruit_IoT_hardware/record_image/實際硬體圖/硬體端軟體狀態圖.png

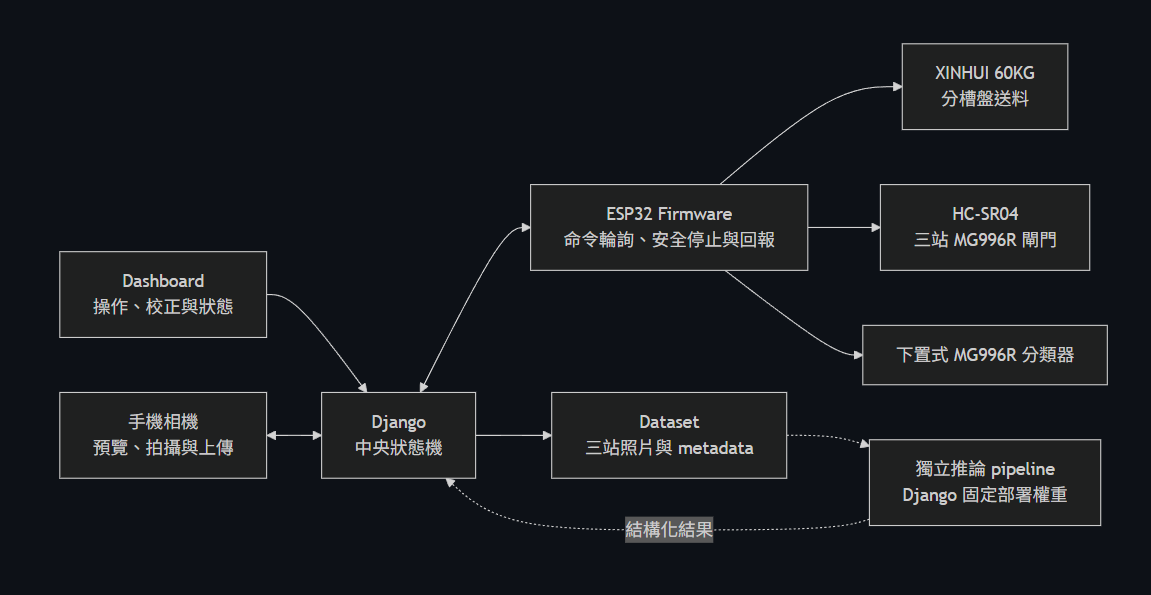
record_image/實際硬體圖/硬體端軟體狀態圖.png
