Eten0721/PassionFruit_IoT_hardware/record_image/實際硬體圖/送料機構圓盤連接處-2.JPG

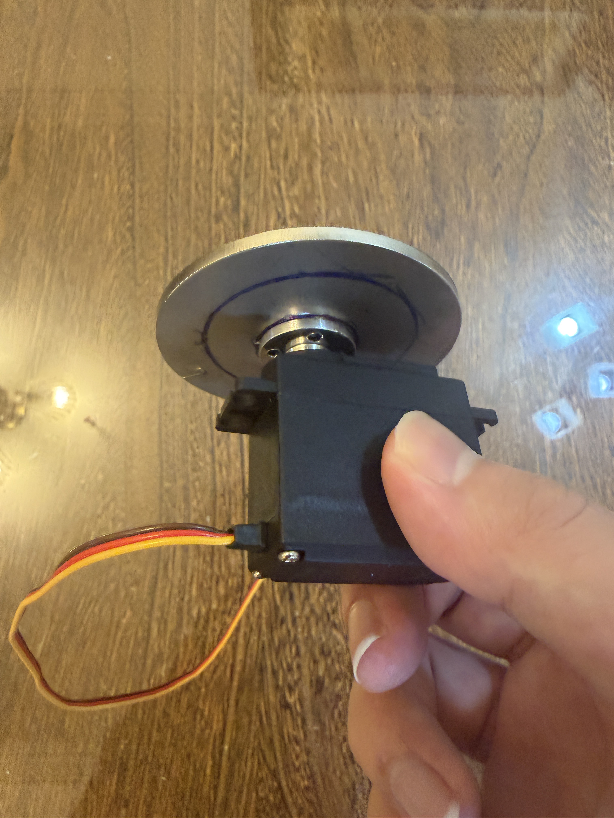
record_image/實際硬體圖/送料機構圓盤連接處-2.JPG
