Eten0721/PassionFruit_IoT_hardware/record_image/實際硬體圖/送料機構外觀.png

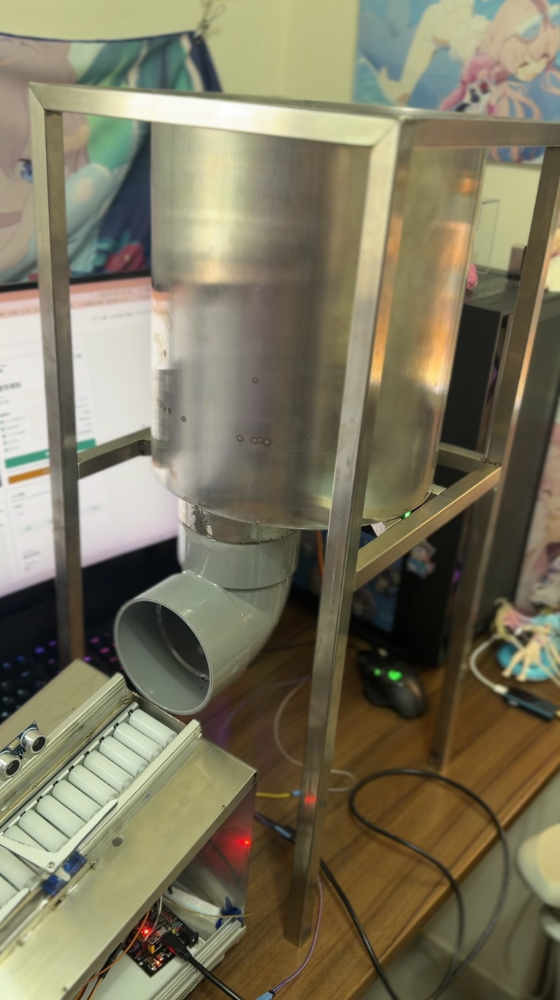
record_image/實際硬體圖/送料機構外觀.png
