Eten0721/PassionFruit_IoT_hardware/record_image/實際硬體圖/送料機構銜接拍攝平台.png

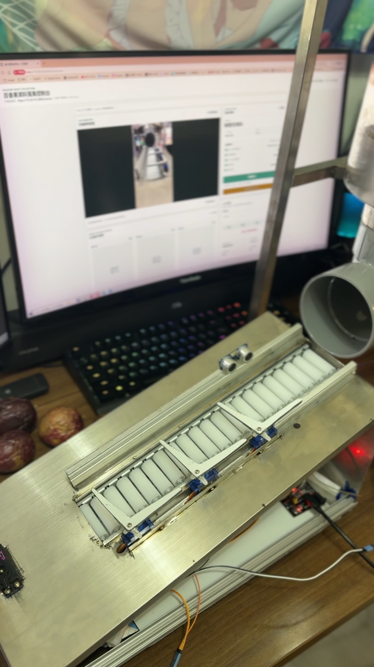
record_image/實際硬體圖/送料機構銜接拍攝平台.png
