Eten0721/PassionFruit_IoT_hardware/record_image/拍攝平台尺寸圖.png

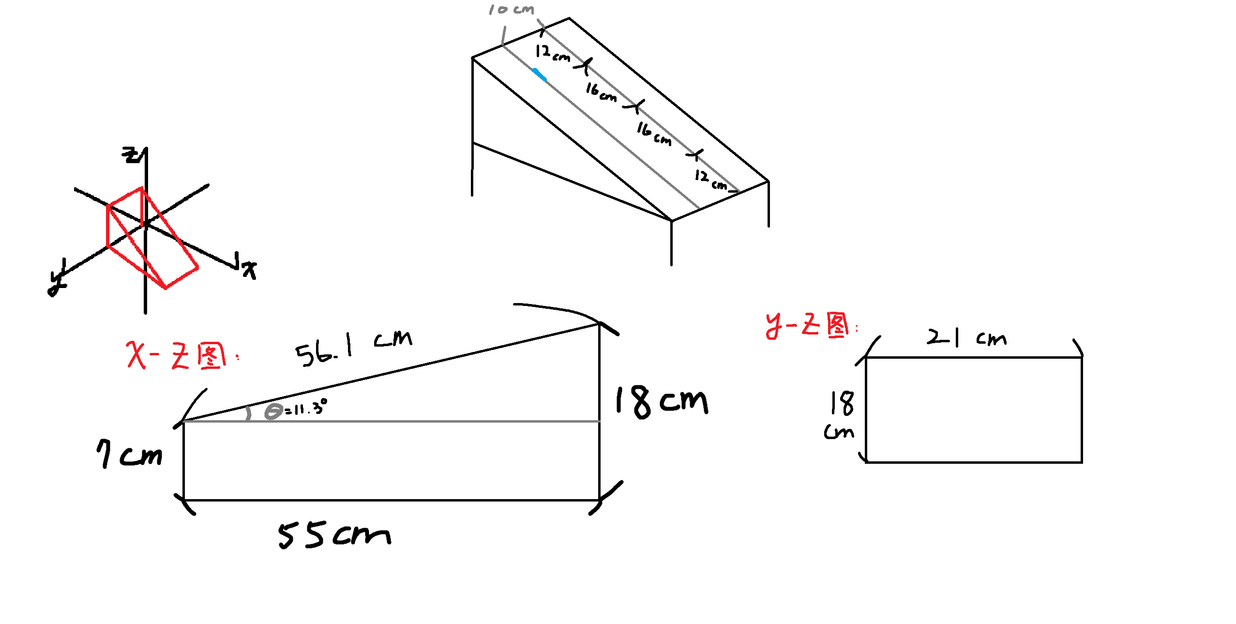
record_image/拍攝平台尺寸圖.png
