Eten0721/PassionFruit_IoT_hardware/record_image/系統架構圖.png

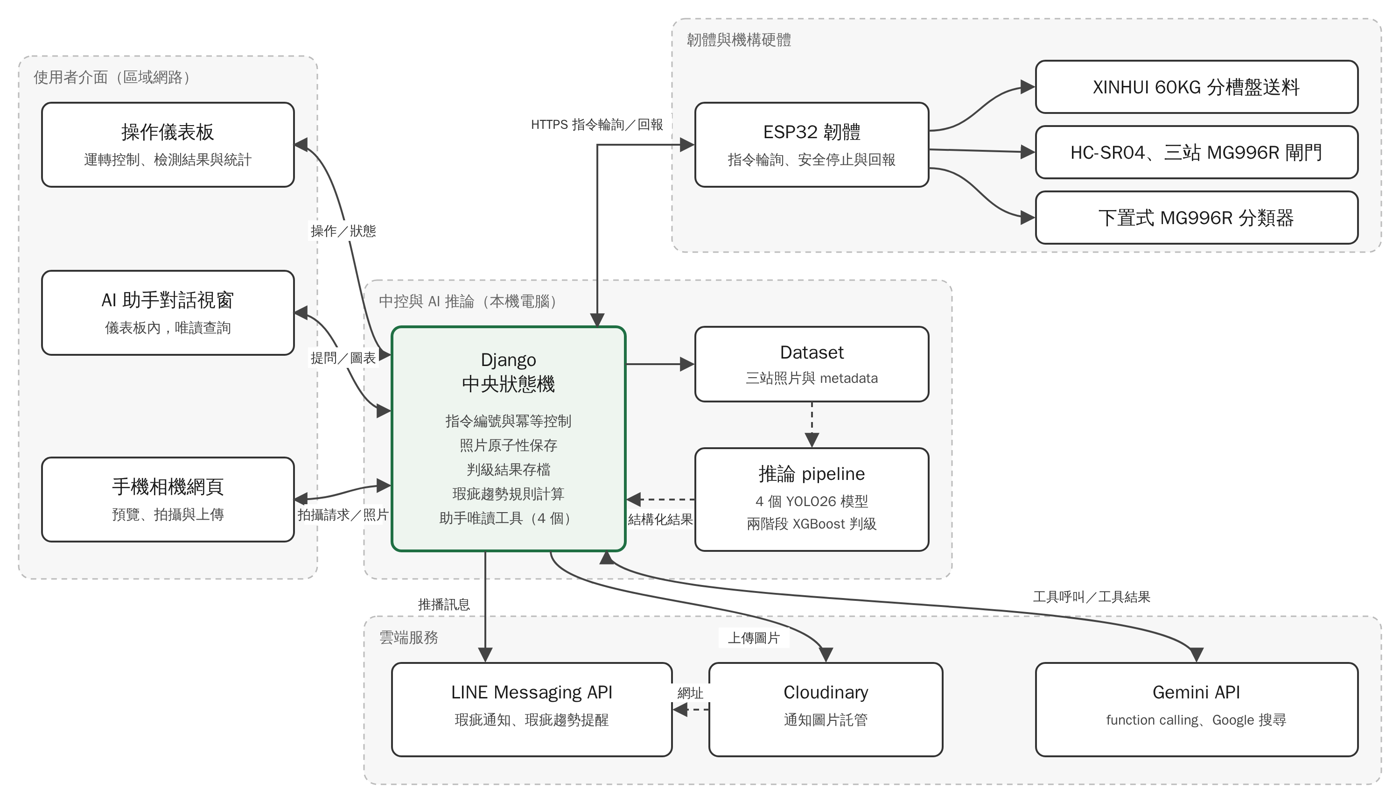
record_image/系統架構圖.png
