Eten0721/PassionFruit_IoT_hardware/record_image/設計圖/硬體設計圖.png

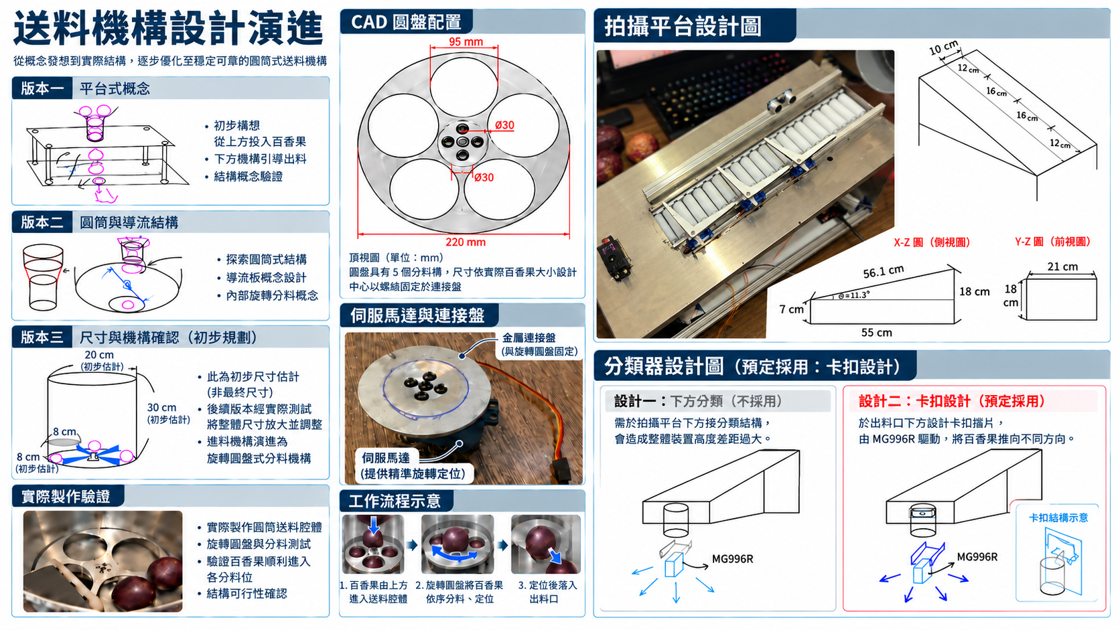
record_image/設計圖/硬體設計圖.png
