Eten0721/PassionFruit_IoT_hardware/record_image/設計圖/硬體設計圖_split1.png

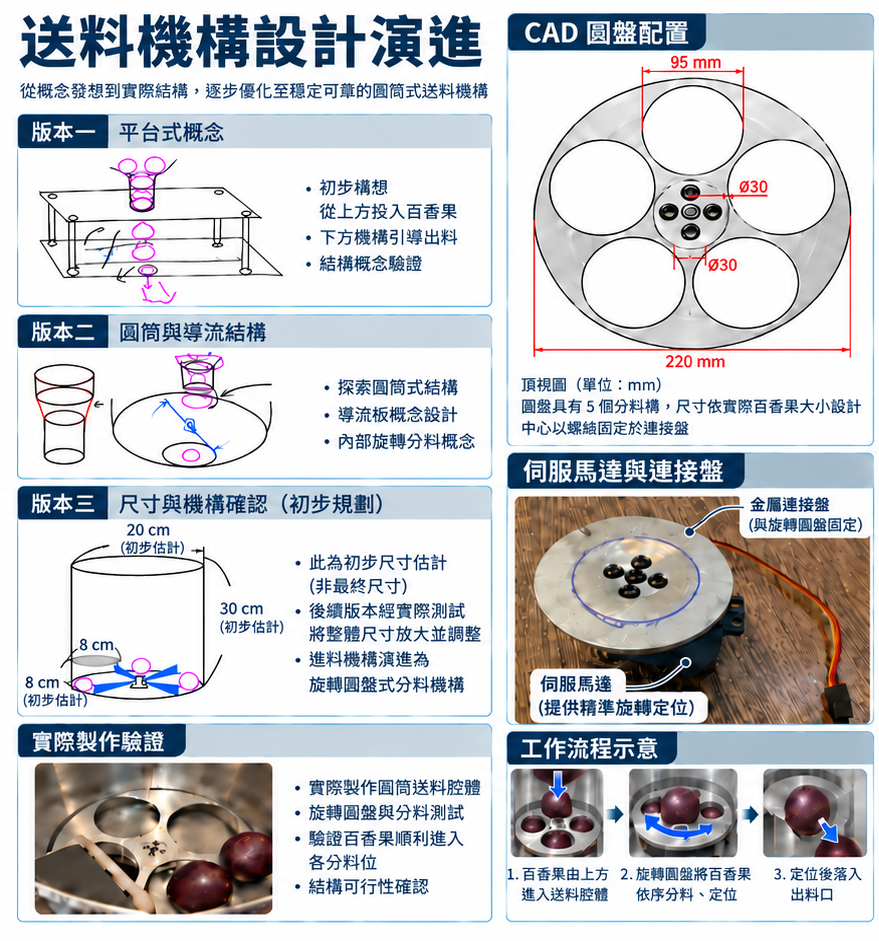
record_image/設計圖/硬體設計圖_split1.png
