Eten0721/PassionFruit_IoT_hardware/record_image/送料機構設計圖_第三版.png

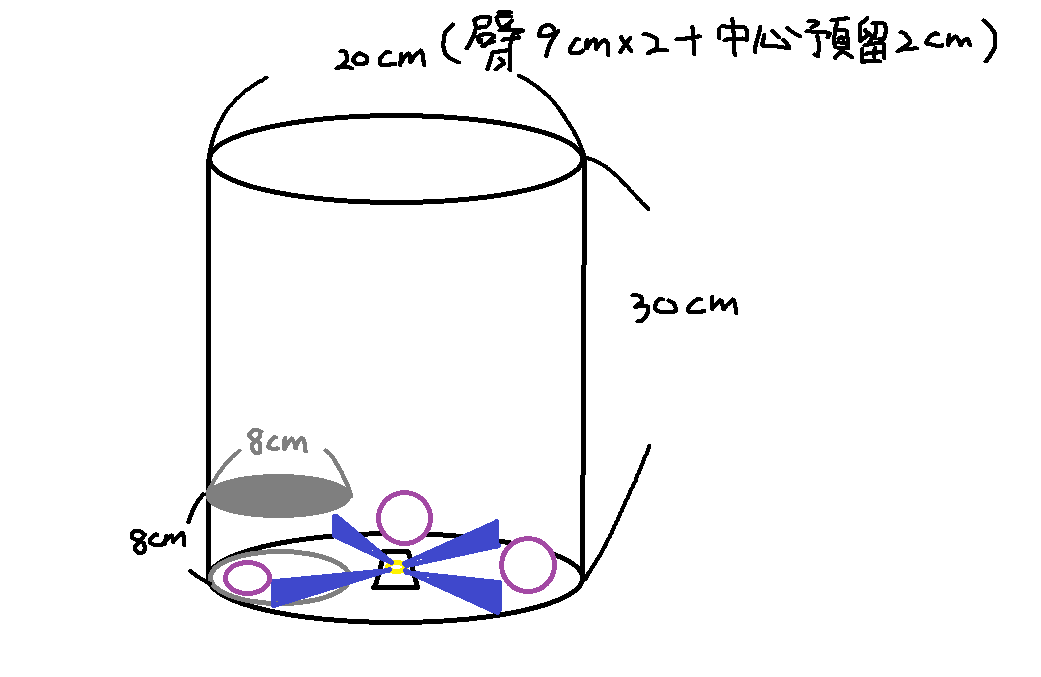
record_image/送料機構設計圖_第三版.png
