Eten0721/PassionFruit_IoT_hardware/record_image/送料機構設計圖_第三版_紙稿.jpg

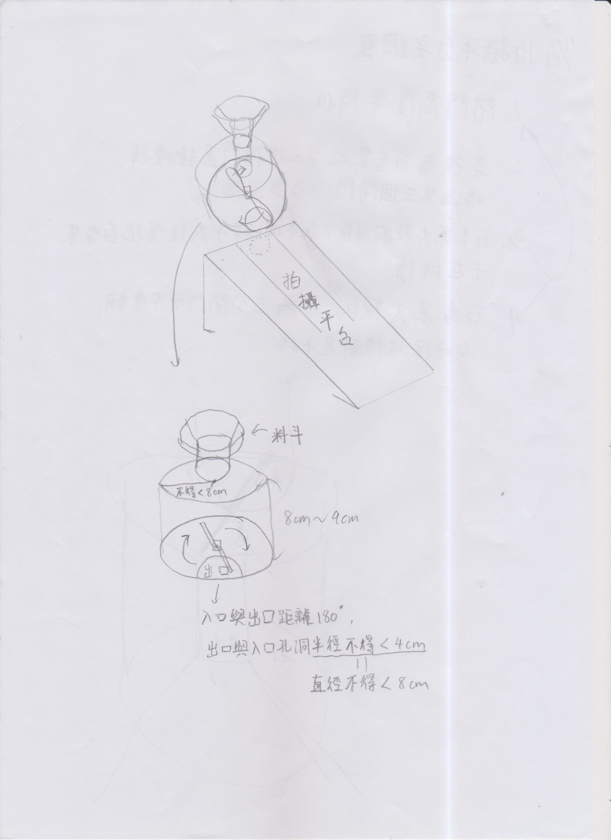
record_image/送料機構設計圖_第三版_紙稿.jpg
