Eten0721/PassionFruit_IoT_hardware/firmware/Three_Gate_Data_Collection/CaptureController.cpp

#include "CaptureController.h"

#include <Esp.h>

#include "Config.h"

void CaptureController::begin() {
  Serial.begin(115200);
  pinMode(FirmwareConfig::kBootPin, INPUT_PULLUP);

  sensor_.begin();
  gates_.begin();
  preferencesReady_ = preferences_.begin("pf-control", false);
  const size_t storedSize = preferencesReady_ ? preferences_.getBytesLength("interlock") : 0;
  if (storedSize > 0) {
    if (storedSize != sizeof(interlockRecord_) ||
        preferences_.getBytes("interlock", &interlockRecord_, sizeof(interlockRecord_)) != sizeof(interlockRecord_) ||
        interlockRecord_.schema != 1 || interlockRecord_.phase > 3 ||
        interlockRecord_.stopUS < 1400 || interlockRecord_.stopUS > 1600 || interlockRecord_.stopUS % 5 != 0) {
      interlockRecord_ = InterlockRecord();
      persistFailed_ = true;
    }
  }
  persistFailed_ = persistFailed_ || !preferencesReady_;
  networkInterlocked_ = !preferencesReady_ || persistFailed_ || interlockRecord_.phase != 0;
  generation_ = interlockRecord_.generation;
  if (!networkInterlocked_) gates_.moveAllHome();
  feeder_.attach(FirmwareConfig::kFeederPin, 1000, 2000);
  feeder_.writeMicroseconds(interlockRecord_.stopUS);

  const uint32_t currentTime = millis();
  classifier_.begin(currentTime, gates_, !networkInterlocked_);
  appliedTiming_ = defaultTimingConfig();
  appliedTiming_.feederStopUS = interlockRecord_.stopUS;
  motionPhase_ = networkInterlocked_ ? MotionPhase::kIdle : MotionPhase::kBootHomeSettling;
  phaseDeadlineAt_ = currentTime + appliedTiming_.servoSettleMS;
  lastCommandPollAt_ = currentTime - FirmwareConfig::kIdleCommandPollIntervalMS;

  Serial.println();
  Serial.println("=== Three Gate Data Collection Firmware ===");
  Serial.println("All gates are moving to HOME_ANGLE; controller is non-blocking.");
  Serial.print("HC-SR04 pulse timeout: ");
  Serial.print(FirmwareConfig::kEchoPulseTimeoutUS);
  Serial.println(" us");
  Serial.print("Automatic station-1 fast path: ");
  Serial.println(
      FirmwareConfig::kEnableAutoStation1FastPath ? "enabled" : "disabled");

  api_.begin();
  if (persistFailed_) queueReport("network_recovery_persist_failed", 0, 0, "recovery_persist_failed");
}

void CaptureController::tick() {
  uint32_t currentTime = millis();

  if (api_.setupPending()) {
    HttpResult discarded;
    if (api_.takeResult(discarded)) networkRequest_ = NetworkRequest::kNone;
    // A BOOT press during setup cancels it, so an unattended AP never strands the machine.
    if (setupButtonPressed(currentTime)) api_.cancelSetup();
    return;
  }

  checkControlSafety(currentTime);
  if (!networkInterlocked_ || recoveryRunning_) {
    classifier_.tick(currentTime);
    collectClassifierResult();
    advanceMotion(currentTime);
  }
  if (applyPendingTimingConfig(currentTime)) {
    return;
  }
  handleSensor(currentTime);
  checkControlSafety(millis());
  collectNetworkResult(millis());
  checkSetupButton(millis());
  if (setupAwaitingGrant_ && !api_.controllerReady() && millis() - setupRequestedAt_ >= 7000UL) {
    setupAwaitingGrant_ = false;
    if (setupAllowedLocal() && !centralSetupBlocked_) api_.requestSetup();
  }
  if (api_.setupPending()) return;
  api_.setControlState(generation_, networkInterlocked_,
      setupAwaitingGrant_ ? "setup" : recoveryRunning_ ? "recover_network" : motionPhase_ == MotionPhase::kFeederDriving ? "feed_one"
      : classifierCommandActive_ ? "classify_fruit" : sequenceActive_ ? "capture" : "idle",
      setupBlockReason());
  currentTime = millis();
  checkStartSequenceWaitTimeout(currentTime);
  if (networkRequest_ != NetworkRequest::kNone) {
    return;
  }
  if (setupAwaitingGrant_) {
    if (api_.heartbeat()) networkRequest_ = NetworkRequest::kHeartbeat;
    return;
  }

  if (!yieldAfterHeartbeat_ && (operationStarted_ || recoveryRunning_) && currentTime - lastHeartbeatAt_ >= 1000UL &&
      api_.heartbeat()) {
    lastHeartbeatAt_ = currentTime;
    networkRequest_ = NetworkRequest::kHeartbeat;
    return;
  }
  yieldAfterHeartbeat_ = false;
  if (flushPendingReport(currentTime)) {
    return;
  }
  if (processAutoTrigger(currentTime)) {
    return;
  }
  pollCommand(currentTime);
}

void CaptureController::collectNetworkResult(uint32_t currentTime) {
  HttpResult result;
  if (!api_.takeResult(result)) {
    return;
  }
  const NetworkRequest request = networkRequest_;
  networkRequest_ = NetworkRequest::kNone;
  const bool accepted = FirmwareConfig::kNetworkDiagnosticsOnly || acceptControlResult(result, currentTime);
  if (setupAwaitingGrant_ && request == NetworkRequest::kHeartbeat) {
    setupAwaitingGrant_ = false;
    const bool granted = accepted && DjangoApiClient::controlValue(result.body, "setup_allowed") == "1";
    const bool unreachable = result.statusCode <= 0 && !centralSetupBlocked_;
    if (setupAllowedLocal() && (granted || unreachable)) api_.requestSetup();
    return;
  }
  if (setupAwaitingGrant_) return;
  if (!accepted) return;
  if (DjangoApiClient::controlValue(result.body, "setup_requested") == "1") beginSetupRequest(currentTime, "dashboard");
  switch (request) {
    case NetworkRequest::kHeartbeat:
      yieldAfterHeartbeat_ = true;
      return;
    case NetworkRequest::kCommand:
      handleCommandResult(result, currentTime);
      return;
    case NetworkRequest::kFastTrigger:
      handleFastPathResult(result, currentTime);
      return;
    case NetworkRequest::kLegacyTrigger:
      handleLegacyTriggerResult(result, currentTime);
      return;
    case NetworkRequest::kReport:
      handleReportResult(result);
      return;
    case NetworkRequest::kNone:
      return;
  }
}

bool CaptureController::saveInterlock(uint8_t phase) {
  interlockRecord_.phase = phase;
  interlockRecord_.generation = generation_;
  interlockRecord_.stopUS = hasActiveTiming_ ? activeTiming_.feederStopUS : appliedTiming_.feederStopUS;
  const bool saved = preferencesReady_ &&
      preferences_.putBytes("interlock", &interlockRecord_, sizeof(interlockRecord_)) == sizeof(interlockRecord_);
  persistFailed_ = !saved;
  return saved;
}

void CaptureController::lockNetwork(const String& reason) {
  // The calibrated stop must precede cancellation and flash I/O.
  feeder_.writeMicroseconds(hasActiveTiming_ ? activeTiming_.feederStopUS : appliedTiming_.feederStopUS);
  classifier_.abort();
  networkInterlocked_ = true;
  recoveryRunning_ = false;
  operationStarted_ = false;
  sequenceActive_ = false;
  classifierCommandActive_ = false;
  autoTriggerEnabled_ = false;
  autoTrigger_ = AutoTrigger();
  hasPendingTiming_ = false;
  resetCommandFailures();
  lastCommandPollAt_ = millis() - FirmwareConfig::kIdleCommandPollIntervalMS;
  awaitingFruitAfterTimeout_ = false;
  motionPhase_ = MotionPhase::kIdle;
  leaseDeadline_ = 0;
  lastAcceptedSentAt_ = millis();
  hasAcceptedSentAt_ = true;
  recoveryPermission_ = false;
  const int abortedId = activeCommand_.commandId;
  saveInterlock(1);
  pendingReport_ = PendingReport();
  queueReport(persistFailed_ ? "network_recovery_persist_failed" : "network_aborted",
      0, abortedId, persistFailed_ ? "recovery_persist_failed" : reason);
}

void CaptureController::checkControlSafety(uint32_t currentTime) {
  const bool active = operationStarted_ || autoTriggerEnabled_ || recoveryRunning_;
  const String ip = WiFi.localIP().toString();
  if (active && localIP_.length() > 0 && ip != localIP_) lockNetwork("local_ip_changed");
  localIP_ = ip;
  if (WiFi.status() != WL_CONNECTED) {
    if (linkLostAt_ == 0) linkLostAt_ = currentTime;
  } else {
    linkLostAt_ = 0;
  }
  if (!active) return;
  if ((linkLostAt_ != 0 && currentTime - linkLostAt_ >= 1000UL) ||
      leaseDeadline_ == 0 || timeReached(currentTime, leaseDeadline_)) {
    lockNetwork(linkLostAt_ != 0 ? "wifi_link_lost" : "control_lease_expired");
  }
}

bool CaptureController::acceptControlResult(const HttpResult& result, uint32_t currentTime) {
  const String run = DjangoApiClient::controlValue(result.body, "server_run_id");
  const String revision = DjangoApiClient::controlValue(result.body, "network_revision");
  const String boot = DjangoApiClient::controlValue(result.body, "boot_id");
  const String generation = DjangoApiClient::controlValue(result.body, "recovery_generation");
  const String allowed = DjangoApiClient::controlValue(result.body, "control_allowed");
  if (run.length() == 0 || generation.length() == 0 || run != result.serverRunId ||
      revision != String(result.networkRevision) || boot != result.bootId ||
      (hasAcceptedSentAt_ && static_cast<int32_t>(result.sentAt - lastAcceptedSentAt_) < 0)) return false;
  const uint32_t returnedGeneration = generation.toInt();
  if (generation != String(returnedGeneration)) return false;
  if (result.statusCode > 0 && result.generation == generation_ && returnedGeneration == generation_ &&
      !timeReached(currentTime, result.sentAt + 6000UL)) {
    centralSetupBlocked_ = !result.isSuccess() || DjangoApiClient::controlValue(result.body, "setup_allowed") != "1";
  }
  if (allowed == "0") {
    if (returnedGeneration >= generation_) {
      const bool active = operationStarted_ || autoTriggerEnabled_ || recoveryRunning_;
      if (returnedGeneration != generation_ || (active &&
          DjangoApiClient::controlValue(result.body, "recovery_allowed") != "1")) {
        lockNetwork("control_not_allowed");
      }
      if ((pendingReport_.event == "network_recovery_completed" || pendingReport_.event == "network_recovery_committed") &&
          (returnedGeneration != generation_ || DjangoApiClient::controlValue(result.body, "recovery_allowed") != "1")) {
        lockNetwork("network_recovery_revoked");
      }
      if (returnedGeneration != generation_) {
        generation_ = returnedGeneration;
        if (networkInterlocked_) saveInterlock(1);
      }
    }
    if (result.generation != generation_) return false;
    if (networkInterlocked_ && (networkRequest_ == NetworkRequest::kNone)) {
      // Recovery and diagnostic responses carry no permission for ordinary motion.
      recoveryPermission_ = result.isSuccess() &&
          DjangoApiClient::controlValue(result.body, "recovery_allowed") == "1" &&
          !timeReached(currentTime, result.sentAt + 6000UL);
      if (recoveryPermission_) leaseDeadline_ = result.sentAt + 6000UL;
      return true;
    }
    return false;
  }
  if (allowed != "1" || !result.isSuccess() || result.generation != generation_ ||
      returnedGeneration != generation_ ||
      DjangoApiClient::controlValue(result.body, "control_lease_ms") != "6000" ||
      timeReached(currentTime, result.sentAt + 6000UL)) return false;
  if (networkInterlocked_ && interlockRecord_.phase != 3) return false;
  if (operationStarted_ && (leasedRunId_ != run || leasedRevision_ != result.networkRevision)) {
    lockNetwork("network_identity_changed");
    return false;
  }
  leasedRunId_ = run;
  leasedRevision_ = result.networkRevision;
  leaseDeadline_ = result.sentAt + 6000UL;
  lastAcceptedSentAt_ = result.sentAt;
  hasAcceptedSentAt_ = true;
  return true;
}

bool CaptureController::setupAllowedLocal() const {
  return setupBlockReason() == nullptr;
}

// First failing safe-idle condition, so a refused BOOT press names what to clear.
const char* CaptureController::setupBlockReason() const {
  if (persistFailed_) return "recovery_persist_failed";
  if (networkInterlocked_) return "network_interlocked";
  if (recoveryRunning_) return "network_recovery_running";
  if (operationStarted_) return "operation_started";
  if (autoTriggerEnabled_) return "auto_trigger_enabled";
  if (autoTrigger_.active()) return "auto_trigger_active";
  if (awaitingFruitAfterTimeout_) return "awaiting_fruit_after_timeout";
  if (sequenceActive_) return "capture_sequence_active";
  if (classifierCommandActive_) return "classifier_command_active";
  if (pendingReport_.active) return "report_pending";
  if (motionPhase_ != MotionPhase::kIdle) return "motion_not_idle";
  if (classifier_.busy()) return "classifier_busy";
  if (!classifier_.available()) return "classifier_unavailable";
  if (!gates_.atHome()) return "gates_not_home";
  return nullptr;
}

// True once per debounced press, and only after the button was released since boot.
bool CaptureController::setupButtonPressed(uint32_t currentTime) {
  const bool low = digitalRead(FirmwareConfig::kBootPin) == LOW;
  if (low != bootRawLow_) { bootRawLow_ = low; bootChangedAt_ = currentTime; }
  if (currentTime - bootChangedAt_ < 50UL) return false;
  if (!low) {
    bootReleased_ = true;
    bootConsumed_ = false;
    return false;
  }
  if (!bootReleased_ || bootConsumed_) return false;
  bootConsumed_ = true;
  return true;
}

void CaptureController::checkSetupButton(uint32_t currentTime) {
  if (setupButtonPressed(currentTime)) beginSetupRequest(currentTime, "boot");
}

// BOOT and the Dashboard button share one path: safe-idle check, then the central motion=setup grant.
void CaptureController::beginSetupRequest(uint32_t currentTime, const char* source) {
  if (setupAwaitingGrant_ || api_.setupPending()) return;
  const char* blocked = setupBlockReason();
  if (!blocked && centralSetupBlocked_) blocked = "central_setup_blocked";
  if (blocked) {
    Serial.print("setup_blocked: ");
    Serial.print(blocked);
    if (pendingReport_.active) { Serial.print(" event="); Serial.print(pendingReport_.event); }
    Serial.print(" source=");
    Serial.println(source);
    return;
  }
  Serial.print("setup_requested source=");
  Serial.println(source);
  autoTriggerEnabled_ = false;
  if (WiFi.status() != WL_CONNECTED || !api_.controllerReady()) {
    api_.requestSetup();
    return;
  }
  setupAwaitingGrant_ = true;
  setupRequestedAt_ = currentTime;
}

void CaptureController::recoverNetwork(const MotorCommand& command, uint32_t currentTime) {
  if (!networkInterlocked_ || !recoveryPermission_ || command.commandId <= 0 ||
      leaseDeadline_ == 0 || timeReached(currentTime, leaseDeadline_)) return;
  if (interlockRecord_.commandId == command.commandId && interlockRecord_.generation == generation_) {
    if (interlockRecord_.phase == 2 || interlockRecord_.phase == 3) {
      pendingReport_ = PendingReport();
      queueReport(interlockRecord_.phase == 2 ? "network_recovery_completed" : "network_recovery_committed",
          0, command.commandId, "network_recovery_retry");
      return;
    }
    if (recoveryRunning_) return;
  }
  interlockRecord_.commandId = command.commandId;
  if (!preferencesReady_) preferencesReady_ = preferences_.begin("pf-control", false);
  if (!saveInterlock(1)) {
    lockNetwork("recovery_persist_failed");
    return;
  }
  feeder_.writeMicroseconds(appliedTiming_.feederStopUS);
  gates_.moveAllHome();
  classifier_.home(currentTime);
  recoveryRunning_ = true;
  motionPhase_ = MotionPhase::kRecoverySettling;
  phaseDeadlineAt_ = currentTime + ClassificationSequence::kJointHomeSettleMS;
  pendingReport_ = PendingReport();
}

void CaptureController::advanceMotion(uint32_t currentTime) {
  if (!timeReached(currentTime, phaseDeadlineAt_)) {
    return;
  }

  switch (motionPhase_) {
    case MotionPhase::kBootHomeSettling:
      motionPhase_ = MotionPhase::kIdle;
      printTiming("gates_home_settled");
      return;

    case MotionPhase::kFeederDriving:
      stopFeeder("feeder_max_run_timeout", "max_run_timeout");
      return;

    case MotionPhase::kStartHomeSettling:
      motionPhase_ = MotionPhase::kStartStation1Settling;
      phaseDeadlineAt_ = currentTime + activeTiming_.firstStationSettleMS;
      printTiming("station_1_settling_started");
      return;

    case MotionPhase::kStartStation1Settling:
      activeStationIndex_ = 1;
      motionPhase_ = MotionPhase::kWaitingForReport;
      queueReport(
          "station_1_ready",
          1,
          activeCommand_.commandId,
          "start_sequence_station_1_ready");
      return;

    case MotionPhase::kReleaseServoSettling:
      if (activeCommand_.stationIndex < FirmwareConfig::kGateCount) {
        motionPhase_ = MotionPhase::kNextStationSettling;
        phaseDeadlineAt_ = currentTime + activeTiming_.fruitSettleMS;
        printTiming("next_station_fruit_settling_started");
        return;
      }
      motionPhase_ = MotionPhase::kFinalFruitSettling;
      phaseDeadlineAt_ = currentTime + activeTiming_.fruitSettleMS;
      printTiming("final_gate_fruit_settling_started");
      return;

    case MotionPhase::kNextStationSettling: {
      const int nextStation = activeCommand_.stationIndex + 1;
      activeStationIndex_ = nextStation;
      motionPhase_ = MotionPhase::kWaitingForReport;
      queueReport(
          String("station_") + String(nextStation) + String("_ready"),
          nextStation,
          activeCommand_.commandId,
          "next_station_ready");
      return;
    }

    case MotionPhase::kFinalFruitSettling:
      motionPhase_ = MotionPhase::kFinalGateReturnDelay;
      phaseDeadlineAt_ = currentTime + activeTiming_.finalGateReturnDelayMS;
      return;

    case MotionPhase::kFinalGateReturnDelay:
      gates_.moveAllHome();
      motionPhase_ = MotionPhase::kFinalHomeSettling;
      phaseDeadlineAt_ = currentTime + activeTiming_.servoSettleMS;
      printTiming("all_gates_returning_home");
      return;

    case MotionPhase::kFinalHomeSettling:
      sequenceActive_ = false;
      activeStationIndex_ = 0;
      motionPhase_ = MotionPhase::kWaitingForReport;
      queueReport(
          "capture_sequence_finished",
          0,
          activeCommand_.commandId,
          "sequence_finished");
      return;

    case MotionPhase::kRecoverySettling:
      recoveryRunning_ = false;
      motionPhase_ = MotionPhase::kIdle;
      if (!saveInterlock(2)) {
        lockNetwork("recovery_persist_failed");
        return;
      }
      pendingReport_ = PendingReport();
      queueReport("network_recovery_completed", 0, interlockRecord_.commandId, "network_recovery_completed");
      return;

    case MotionPhase::kIdle:
    case MotionPhase::kWaitingForReport:
    case MotionPhase::kWaitingForCommand:
      return;
  }
}

void CaptureController::handleSensor(uint32_t currentTime) {
  if (currentTime - lastSensorReadAt_ < FirmwareConfig::kSensorReadIntervalMS) {
    return;
  }
  lastSensorReadAt_ = currentTime;

  uint32_t elapsedUS = 0;
  const float distanceCM = sensor_.readCentimeters(&elapsedUS);
  const uint32_t sensorReadFinishedAt = millis();
  feederSensorState_ = distanceCM <= 0.0F
      ? "unavailable"
      : (distanceCM > FirmwareConfig::kRearmDistanceCM ? "clear" : "blocked");

  if (currentTime - lastDistancePrintAt_ >= FirmwareConfig::kDistancePrintIntervalMS) {
    Serial.print("Distance: ");
    Serial.print(distanceCM);
    Serial.print(" cm sensor_read_us=");
    Serial.println(elapsedUS);
    lastDistancePrintAt_ = currentTime;
  }

  if (elapsedUS > FirmwareConfig::kEchoPulseTimeoutUS + 100UL) {
    Serial.print("WARN sensor read exceeded bounded pulse window: ");
    Serial.println(elapsedUS);
  }

  if (
      !sequenceActive_ &&
      !triggerArmed_ &&
      distanceCM > FirmwareConfig::kRearmDistanceCM) {
    triggerArmed_ = true;
    Serial.println("Sensor area cleared. Trigger rearmed.");
  }

  if (motionPhase_ == MotionPhase::kFeederDriving) {
    if (timeReached(sensorReadFinishedAt, phaseDeadlineAt_)) {
      stopFeeder("feeder_max_run_timeout", "max_run_timeout");
    } else if (feederSensorState_ == "unavailable") {
      stopFeeder(
          "feeder_sensor_unavailable",
          "feeder_sensor_unavailable");
    } else if (distanceCM <= FirmwareConfig::kTriggerDistanceCM) {
      stopFeeder("feed_cycle_completed", "hcsr04");
    }
    return;
  }

  if (networkInterlocked_) return;
  if (
      awaitingFruitAfterTimeout_ &&
      !autoTrigger_.active() &&
      distanceCM > 0.0F &&
      distanceCM <= FirmwareConfig::kTriggerDistanceCM) {
    latchAutoTrigger(sensorReadFinishedAt);
    return;
  }

  String blockedReason;
  if (!shouldStartAutoTrigger(distanceCM, currentTime, blockedReason)) {
    if (blockedReason.length() > 0) {
      printTriggerDebug(blockedReason, distanceCM, currentTime, false);
    }
    return;
  }

  latchAutoTrigger(currentTime);
}

bool CaptureController::shouldStartAutoTrigger(
    float distanceCM,
    uint32_t currentTime,
    String& reason) const {
  reason = "";
  if (distanceCM <= 0.0F || distanceCM > FirmwareConfig::kTriggerDistanceCM) {
    return false;
  }
  if (!autoTriggerEnabled_) {
    reason = "server_auto_trigger_disabled";
    return false;
  }
  if (autoTrigger_.active()) {
    reason = "pending_hcsr04_trigger";
    return false;
  }
  if (sequenceActive_) {
    reason = "blocked_by_sequence_active";
    return false;
  }
  if (classifierCommandActive_ || classifier_.busy()) {
    reason = "classifier_busy";
    return false;
  }
  if (!triggerArmed_) {
    reason = "blocked_by_trigger_not_armed";
    return false;
  }
  if (motionPhase_ != MotionPhase::kIdle) {
    reason = "gates_not_settled";
    return false;
  }
  if (!gates_.atHome()) {
    reason = "gates_not_home";
    return false;
  }
  if (
      lastTriggerAt_ != 0 &&
      currentTime - lastTriggerAt_ < FirmwareConfig::kCooldownMS) {
    reason = "blocked_by_cooldown";
    return false;
  }
  return true;
}

void CaptureController::latchAutoTrigger(uint32_t currentTime) {
  const bool feederHandoff =
      motionPhase_ == MotionPhase::kFeederDriving ||
      awaitingFruitAfterTimeout_;
  awaitingFruitAfterTimeout_ = false;
  lastTriggerAt_ = currentTime;
  triggerArmed_ = false;
  setAutoTriggerEnabled(false, "local_hcsr04_trigger");

  autoTrigger_ = AutoTrigger();
  autoTrigger_.triggerId = createTriggerId(currentTime);
  if (!hasActiveTiming_) {
    snapshotActiveTiming();
  }
  printTiming("hcsr04_trigger_detected");

  if (
      FirmwareConfig::kEnableAutoStation1FastPath &&
      (gatesAreSafeForFastPath() ||
       (feederHandoff && !sequenceActive_ && gates_.atHome()))) {
    autoTrigger_.phase = AutoTriggerPhase::kFastWaitingForStationSettle;
    autoTrigger_.nextAttemptAt =
        currentTime + activeTiming_.firstStationSettleMS;
    Serial.print("Fast station-1 path armed. trigger_id=");
    Serial.println(autoTrigger_.triggerId);
    return;
  }

  startLegacyFallback(currentTime, "local_fast_path_safety_not_met");
}

bool CaptureController::processAutoTrigger(uint32_t currentTime) {
  if (!autoTrigger_.active()) {
    return false;
  }

  switch (autoTrigger_.phase) {
    case AutoTriggerPhase::kFastWaitingForStationSettle:
      if (!timeReached(currentTime, autoTrigger_.nextAttemptAt)) {
        return true;
      }
      if (!gatesAreSafeForFastPath()) {
        startLegacyFallback(currentTime, "fast_path_safety_changed_before_send");
        return true;
      }
      autoTrigger_.phase = AutoTriggerPhase::kFastReportPending;
      autoTrigger_.nextAttemptAt = currentTime;
      sendFastPathReport(currentTime);
      return true;

    case AutoTriggerPhase::kFastReportPending:
      if (!timeReached(currentTime, autoTrigger_.nextAttemptAt)) {
        return true;
      }
      sendFastPathReport(currentTime);
      return true;

    case AutoTriggerPhase::kLegacyReportPending:
      if (!timeReached(currentTime, autoTrigger_.nextAttemptAt)) {
        // A timed-out legacy report may already have created start_sequence.
        // Allow fast command polling while retaining the idempotent retry.
        return !autoTrigger_.waitingForStartSequence;
      }
      sendLegacyTriggerReport(currentTime);
      return true;

    case AutoTriggerPhase::kLegacyWaitingForStartSequence:
      return false;

    case AutoTriggerPhase::kNone:
      return false;
  }
  return false;
}

void CaptureController::sendFastPathReport(uint32_t currentTime) {
  if (!gatesAreSafeForFastPath()) {
    startLegacyFallback(currentTime, "fast_path_safety_changed_during_send");
    return;
  }

  if (!api_.postReport(
      "hcsr04_station_1_ready",
      1,
      0,
      "fast_path_station_1_ready",
      FirmwareConfig::kAutoTriggerReportTimeoutMS,
      autoTrigger_.triggerId,
      true,
      true,
      true,
      appliedTiming_.revision)) {
    return;
  }
  networkRequest_ = NetworkRequest::kFastTrigger;
}

void CaptureController::handleFastPathResult(
    const HttpResult& result, uint32_t afterRequestTime) {
  printReportSummary("hcsr04_station_1_ready", result);

  if (DjangoApiClient::isExplicitFastPathRejection(result)) {
    startLegacyFallback(afterRequestTime, "server_rejected_fast_path");
    return;
  }

  if (!result.isSuccess()) {
    autoTrigger_.phase = AutoTriggerPhase::kFastReportPending;
    autoTrigger_.nextAttemptAt =
        afterRequestTime + FirmwareConfig::kAutoTriggerReportRetryIntervalMS;
    printTiming("hcsr04_station_1_ready_retry_scheduled");
    Serial.println("Fast-path request was ambiguous; retrying the same trigger_id.");
    return;
  }

  MotorCommand startCommand;
  if (api_.parseStartSequenceFromResponse(result.body, startCommand)) {
    clearAutoTrigger("fast_path_response_contains_start_sequence");
    handleCommand(startCommand, afterRequestTime);
    return;
  }

  const bool ignored = DjangoApiClient::responseHasIgnored(result.body);
  if (!ignored || DjangoApiClient::responseHasCaptureRequest(result.body)) {
    sequenceActive_ = true;
    activeStationIndex_ = 1;
    motionPhase_ = MotionPhase::kWaitingForCommand;
    clearAutoTrigger("fast_path_station_1_capture_opened");
    printTiming("station_1_fast_path_report_success");
    return;
  }

  if (DjangoApiClient::responseSuggestsStartSequenceWaiting(result.body)) {
    autoTrigger_.phase = AutoTriggerPhase::kLegacyWaitingForStartSequence;
    startStartSequenceWait(afterRequestTime, "existing_start_sequence_after_fast_path");
    return;
  }

  clearActiveTiming();
  clearAutoTrigger("fast_path_ignored_by_server");
  Serial.println("Fast-path trigger was ignored by server; waiting for sensor rearm.");
}

void CaptureController::sendLegacyTriggerReport(uint32_t currentTime) {
  if (!api_.postReport(
      "hcsr04_trigger",
      0,
      0,
      "distance_trigger",
      FirmwareConfig::kAutoTriggerReportTimeoutMS,
      autoTrigger_.triggerId,
      false,
      false,
      false,
      appliedTiming_.revision)) {
    return;
  }
  networkRequest_ = NetworkRequest::kLegacyTrigger;
}

void CaptureController::handleLegacyTriggerResult(
    const HttpResult& result, uint32_t afterRequestTime) {
  printReportSummary("hcsr04_trigger", result);

  if (!result.isSuccess()) {
    autoTrigger_.phase = AutoTriggerPhase::kLegacyReportPending;
    autoTrigger_.nextAttemptAt =
        afterRequestTime + FirmwareConfig::kAutoTriggerReportRetryIntervalMS;
    if (!autoTrigger_.waitingForStartSequence) {
      autoTrigger_.waitingForStartSequence = true;
      autoTrigger_.waitingStartedAt = afterRequestTime;
      lastCommandPollAt_ =
          afterRequestTime - FirmwareConfig::kStartSequenceCommandPollIntervalMS;
      printTiming("legacy_hcsr04_timeout_fast_command_poll_enabled");
    }
    Serial.println("Legacy trigger request failed; retaining trigger_id for retry.");
    return;
  }

  MotorCommand startCommand;
  if (api_.parseStartSequenceFromResponse(result.body, startCommand)) {
    clearAutoTrigger("legacy_report_response_contains_start_sequence");
    handleCommand(startCommand, afterRequestTime);
    return;
  }

  if (DjangoApiClient::responseHasIgnored(result.body)) {
    if (DjangoApiClient::responseSuggestsStartSequenceWaiting(result.body)) {
      autoTrigger_.phase = AutoTriggerPhase::kLegacyWaitingForStartSequence;
      startStartSequenceWait(afterRequestTime, "duplicate_trigger_waiting_start_sequence");
      return;
    }

    clearActiveTiming();
    clearAutoTrigger("legacy_trigger_ignored_by_server");
    Serial.println("Legacy trigger was ignored by server; waiting for sensor rearm.");
    return;
  }

  autoTrigger_.phase = AutoTriggerPhase::kLegacyWaitingForStartSequence;
  startStartSequenceWait(afterRequestTime, "legacy_trigger_accepted");
}

void CaptureController::startLegacyFallback(
    uint32_t currentTime,
    const String& reason) {
  autoTrigger_.phase = AutoTriggerPhase::kLegacyReportPending;
  autoTrigger_.nextAttemptAt = currentTime;
  autoTrigger_.waitingForStartSequence = false;
  autoTrigger_.waitingStartedAt = 0;
  Serial.print("Using legacy hcsr04_trigger fallback: ");
  Serial.println(reason);
  printTiming("legacy_hcsr04_trigger_queued");
}

void CaptureController::clearAutoTrigger(const String& reason) {
  if (!autoTrigger_.active()) {
    return;
  }
  Serial.print("Auto trigger state cleared: ");
  Serial.println(reason);
  autoTrigger_ = AutoTrigger();
}

void CaptureController::startStartSequenceWait(
    uint32_t currentTime,
    const String& reason) {
  autoTrigger_.waitingForStartSequence = true;
  autoTrigger_.waitingStartedAt = currentTime;
  if (autoTrigger_.phase != AutoTriggerPhase::kLegacyReportPending) {
    autoTrigger_.phase = AutoTriggerPhase::kLegacyWaitingForStartSequence;
  }
  lastCommandPollAt_ =
      currentTime - FirmwareConfig::kStartSequenceCommandPollIntervalMS;
  commandBackoffUntilAt_ = 0;
  consecutiveCommandFailures_ = 0;
  Serial.print("Fast start_sequence polling enabled: ");
  Serial.println(reason);
  printTiming("fast_poll_start_sequence_enabled");
}

void CaptureController::checkStartSequenceWaitTimeout(uint32_t currentTime) {
  if (!autoTrigger_.waitingForStartSequence ||
      autoTrigger_.waitingStartedAt == 0 ||
      currentTime - autoTrigger_.waitingStartedAt <=
          FirmwareConfig::kStartSequenceWaitLimitMS) {
    return;
  }

  printTiming("start_sequence_wait_timeout");
  if (autoTrigger_.phase == AutoTriggerPhase::kLegacyReportPending) {
    // Keep retrying the same trigger_id, but stop prioritising command polls
    // until a later ambiguous response asks for them again.
    autoTrigger_.waitingForStartSequence = false;
    autoTrigger_.waitingStartedAt = 0;
    return;
  }

  clearActiveTiming();
  clearAutoTrigger("start_sequence_wait_timeout");
}

String CaptureController::createTriggerId(uint32_t currentTime) {
  const uint32_t chipId = static_cast<uint32_t>(ESP.getEfuseMac());
  triggerSequence_ += 1;
  return String("esp32-") + String(static_cast<unsigned long>(chipId), HEX) +
         String("-") + String(static_cast<unsigned long>(triggerSequence_)) +
         String("-") + String(static_cast<unsigned long>(currentTime));
}

bool CaptureController::gatesAreSafeForFastPath() const {
  return motionPhase_ == MotionPhase::kIdle &&
         !sequenceActive_ &&
         gates_.atHome();
}

bool CaptureController::flushPendingReport(uint32_t currentTime) {
  if (!pendingReport_.active) {
    return false;
  }
  if (!api_.wifiConnected()) {
    return true;
  }
  if (
      pendingReport_.lastAttemptAt != 0 &&
      currentTime - pendingReport_.lastAttemptAt <
          FirmwareConfig::kReportRetryIntervalMS) {
    return true;
  }

  if (!api_.postReport(
      pendingReport_.event,
      pendingReport_.stationIndex,
      pendingReport_.commandId,
      pendingReport_.message,
      FirmwareConfig::kReportHttpTimeoutMS,
      "",
      false,
      false,
      false,
      pendingReport_.timingRevision,
      pendingReport_.classificationCode,
      pendingReport_.includeStationIndex,
      pendingReport_.feederElapsedMS,
      pendingReport_.feederMaxRunMS,
      pendingReport_.feederStopReason)) {
    return true;
  }
  pendingReport_.lastAttemptAt = currentTime;
  networkRequest_ = NetworkRequest::kReport;
  return true;
}

void CaptureController::handleReportResult(const HttpResult& result) {
  printReportSummary(pendingReport_.event, result);
  if (pendingReport_.event == "network_recovery_completed") {
    if (result.isSuccess() && DjangoApiClient::controlValue(result.body, "recovery_commit") == "1") {
      if (!saveInterlock(3)) {
        pendingReport_ = PendingReport();
        queueReport("network_recovery_persist_failed", 0, interlockRecord_.commandId, "recovery_persist_failed");
        return;
      }
      pendingReport_ = PendingReport();
      queueReport("network_recovery_committed", 0, interlockRecord_.commandId, "network_recovery_committed");
    }
    return;
  }
  if (pendingReport_.event == "network_recovery_committed") {
    if (result.isSuccess() && DjangoApiClient::controlValue(result.body, "recovery_committed") == "1") {
      if (!saveInterlock(0)) {
        lockNetwork("recovery_persist_failed");
        return;
      }
      networkInterlocked_ = false;
      persistFailed_ = false;
      operationStarted_ = false;
      awaitingFruitAfterTimeout_ = false;
      pendingReport_ = PendingReport();
      activeCommand_ = MotorCommand();
      executingCommandId_ = 0;
      sequenceActive_ = false;
      clearActiveTiming();
    }
    return;
  }
  if (networkInterlocked_) {
    if (result.isSuccess()) pendingReport_ = PendingReport();
    return;
  }

  if (!result.isSuccess()) {
    Serial.println("ESP32 report failed. It will be retried without repeating motion.");
    return;
  }

  const String event = pendingReport_.event;
  const int commandId = pendingReport_.commandId;
  pendingReport_ = PendingReport();
  if (commandId > 0) {
    lastConfirmedCommandId_ = commandId;
    if (executingCommandId_ == commandId) {
      executingCommandId_ = 0;
    }
  }
  printTiming(event + String("_report_success"));
  const bool calibration = activeCommand_.feedContext == "calibration";
  handlePendingReportSuccess(event);
  if (event == "classification_sorter_completed" ||
      (event.startsWith("feeder_") && calibration) ||
      (event == "feed_cycle_completed" && calibration)) {
    operationStarted_ = false;
    if (!saveInterlock(0)) lockNetwork("recovery_persist_failed");
  }
}

void CaptureController::queueReport(
    const String& event,
    int stationIndex,
    int commandId,
    const String& message,
    uint32_t timingRevision,
    const String& classificationCode,
    bool includeStationIndex,
    uint32_t feederElapsedMS,
    uint32_t feederMaxRunMS,
    const String& feederStopReason) {
  if (pendingReport_.active) {
    Serial.println("WARN attempted to overwrite an unsent ESP32 report.");
    return;
  }

  pendingReport_.active = true;
  pendingReport_.event = event;
  pendingReport_.stationIndex = stationIndex;
  pendingReport_.commandId = commandId;
  pendingReport_.message = message;
  pendingReport_.timingRevision = timingRevision;
  pendingReport_.classificationCode = classificationCode;
  pendingReport_.includeStationIndex = includeStationIndex;
  pendingReport_.feederElapsedMS = feederElapsedMS;
  pendingReport_.feederMaxRunMS = feederMaxRunMS;
  pendingReport_.feederStopReason = feederStopReason;
  pendingReport_.lastAttemptAt = 0;
  printTiming(event + String("_queued"));
}

void CaptureController::handlePendingReportSuccess(const String& event) {
  if (event.startsWith("station_")) {
    motionPhase_ = MotionPhase::kWaitingForCommand;
    lastCommandPollAt_ =
        millis() - FirmwareConfig::kAwaitReleaseCommandPollIntervalMS;
    commandBackoffUntilAt_ = 0;
    return;
  }
  if (event == "capture_sequence_finished") {
    motionPhase_ = MotionPhase::kIdle;
    activeCommand_ = MotorCommand();
    clearActiveTiming();
    return;
  }
  if (event == "feed_cycle_completed" ||
      event == "feeder_max_run_timeout" ||
      event == "feeder_sensor_unavailable" ||
      event == "feeder_sensor_not_clear") {
    motionPhase_ = MotionPhase::kIdle;
    activeCommand_ = MotorCommand();
    if (!autoTrigger_.active()) {
      clearActiveTiming();
    }
    return;
  }
  if (event == "classification_sorter_completed" ||
      event == "classification_sorter_failed") {
    classifierCommandActive_ = false;
    sequenceActive_ = false;
    activeStationIndex_ = 0;
    motionPhase_ = MotionPhase::kIdle;
    activeCommand_ = MotorCommand();
    clearActiveTiming();
    return;
  }
}

void CaptureController::collectClassifierResult() {
  if (!classifier_.hasResult() || pendingReport_.active) {
    return;
  }
  const ClassifierController::Result result = classifier_.takeResult();
  sequenceActive_ = false;
  activeStationIndex_ = 0;
  motionPhase_ = MotionPhase::kWaitingForReport;
  queueReport(
      result.success ? "classification_sorter_completed"
                     : "classification_sorter_failed",
      0,
      result.commandId,
      result.reason,
      0,
      result.classificationCode,
      false);
}

TimingConfig CaptureController::defaultTimingConfig() const {
  TimingConfig timing;
  timing.revision = 0;
  timing.firstStationSettleMS = FirmwareConfig::kFirstStationSettleMS;
  timing.servoSettleMS = FirmwareConfig::kServoSettleMS;
  timing.fruitSettleMS = FirmwareConfig::kFruitSettleMS;
  timing.finalGateReturnDelayMS = FirmwareConfig::kFinalGateReturnDelayMS;
  timing.idleCommandPollIntervalMS = FirmwareConfig::kIdleCommandPollIntervalMS;
  timing.feederStopUS = FirmwareConfig::kFeederStopUS;
  timing.feederDriveUS = FirmwareConfig::kFeederDriveUS;
  timing.feederMaxRunMS = FirmwareConfig::kFeederMaxRunMS;
  return timing;
}

static bool servoAngleIsValid(int angle) {
  return angle >= 0 && angle <= 180;
}

static bool servoAnglesAreValid(const TimingConfig& timing) {
  for (uint8_t index = 0; index < FirmwareConfig::kGateCount; index += 1) {
    const int home = timing.gateHomeAngles[index];
    if (!servoAngleIsValid(home) || home == FirmwareConfig::kReleaseAngle) return false;
  }
  for (uint8_t index = 0; index < FirmwareConfig::kSorterBinCount; index += 1) {
    if (!servoAngleIsValid(timing.sorterBinAngles[index])) return false;
  }
  return servoAngleIsValid(timing.sorterHomeAngle);
}

static bool servoAnglesEqual(const TimingConfig& left, const TimingConfig& right) {
  for (uint8_t index = 0; index < FirmwareConfig::kGateCount; index += 1) {
    if (left.gateHomeAngles[index] != right.gateHomeAngles[index]) return false;
  }
  for (uint8_t index = 0; index < FirmwareConfig::kSorterBinCount; index += 1) {
    if (left.sorterBinAngles[index] != right.sorterBinAngles[index]) return false;
  }
  return left.sorterHomeAngle == right.sorterHomeAngle;
}

bool CaptureController::timingConfigIsValid(const TimingConfig& timing) const {
  constexpr uint32_t kMinimumSettleMS = 50UL;
  constexpr uint32_t kMaximumSettleMS = 3000UL;
  return servoAnglesAreValid(timing) &&
         timing.firstStationSettleMS >= kMinimumSettleMS &&
         timing.firstStationSettleMS <= kMaximumSettleMS &&
         timing.servoSettleMS >= kMinimumSettleMS &&
         timing.servoSettleMS <= kMaximumSettleMS &&
         timing.fruitSettleMS >= kMinimumSettleMS &&
         timing.fruitSettleMS <= kMaximumSettleMS &&
         timing.finalGateReturnDelayMS <= kMaximumSettleMS &&
         timing.idleCommandPollIntervalMS >= 100UL &&
         timing.idleCommandPollIntervalMS <= 5000UL &&
         timing.idleCommandPollIntervalMS % 50UL == 0 &&
         timing.feederStopUS >= 1400UL && timing.feederStopUS <= 1600UL &&
         timing.feederStopUS % 5UL == 0 &&
         timing.feederDriveUS >= 1000UL && timing.feederDriveUS <= 2000UL &&
         timing.feederDriveUS % 10UL == 0 &&
         timing.feederDriveUS != timing.feederStopUS &&
         timing.feederMaxRunMS >= 1000UL && timing.feederMaxRunMS <= 20000UL &&
         timing.feederMaxRunMS % 500UL == 0;
}

bool CaptureController::timingConfigCanApply() const {
  return motionPhase_ == MotionPhase::kIdle && !sequenceActive_ &&
         !classifierCommandActive_ && !classifier_.busy() &&
         !autoTrigger_.active() &&
         !pendingReport_.active && gates_.atHome();
}

void CaptureController::stageTimingConfig(const MotorCommand& command) {
  if (!command.hasTimingConfig) {
    return;
  }
  if (!timingConfigIsValid(command.timing)) {
    Serial.println("Ignoring invalid timing configuration from Django.");
    return;
  }
  if (command.timing.revision <= appliedTiming_.revision) {
    return;
  }

  pendingTiming_ = command.timing;
  hasPendingTiming_ = true;
}

bool CaptureController::applyPendingTimingConfig(uint32_t currentTime) {
  if (networkInterlocked_ || !hasPendingTiming_ || !timingConfigCanApply()) {
    return false;
  }

  if (pendingTiming_.revision <= appliedTiming_.revision) {
    hasPendingTiming_ = false;
    return false;
  }

  const bool anglesChanged = !servoAnglesEqual(appliedTiming_, pendingTiming_);
  appliedTiming_ = pendingTiming_;
  hasPendingTiming_ = false;
  gates_.setHomeAngles(appliedTiming_.gateHomeAngles);
  classifier_.setAngles(appliedTiming_.sorterHomeAngle, appliedTiming_.sorterBinAngles);
  if (!saveInterlock(networkInterlocked_ ? 1 : 0)) {
    lockNetwork("recovery_persist_failed");
    return true;
  }
  if (anglesChanged) {
    // Only applied while idle at home, so moving to the new home cannot drop a fruit mid-sequence.
    gates_.moveAllHome();
    classifier_.home(currentTime);
    motionPhase_ = MotionPhase::kBootHomeSettling;
    phaseDeadlineAt_ = currentTime + ClassificationSequence::kJointHomeSettleMS;
  }
  Serial.print("Timing configuration applied. revision=");
  Serial.print(appliedTiming_.revision);
  Serial.print(" first=");
  Serial.print(appliedTiming_.firstStationSettleMS);
  Serial.print(" servo=");
  Serial.print(appliedTiming_.servoSettleMS);
  Serial.print(" fruit=");
  Serial.print(appliedTiming_.fruitSettleMS);
  Serial.print(" final=");
  Serial.print(appliedTiming_.finalGateReturnDelayMS);
  Serial.print(" idle_poll=");
  Serial.println(appliedTiming_.idleCommandPollIntervalMS);
  queueReport(
      "timing_config_applied",
      0,
      0,
      "timing_config_applied",
      appliedTiming_.revision);
  printTiming("timing_config_applied_queued");
  return true;
}

void CaptureController::snapshotActiveTiming() {
  activeTiming_ = appliedTiming_;
  hasActiveTiming_ = true;
}

void CaptureController::clearActiveTiming() {
  activeTiming_ = TimingConfig();
  hasActiveTiming_ = false;
}

void CaptureController::pollCommand(uint32_t currentTime) {
  if (!api_.wifiConnected() || !classifier_.available()) {
    return;
  }
  const bool waitingForStartSequence = autoTrigger_.waitingForStartSequence;
  const bool waitingForRelease = motionPhase_ == MotionPhase::kWaitingForCommand;
  const bool idle = motionPhase_ == MotionPhase::kIdle;
  if (!waitingForStartSequence && !waitingForRelease && !idle) {
    return;
  }
  if (
      commandBackoffUntilAt_ != 0 &&
      !timeReached(currentTime, commandBackoffUntilAt_)) {
    return;
  }
  if (commandBackoffUntilAt_ != 0) {
    commandBackoffUntilAt_ = 0;
  }

  const uint32_t interval = currentCommandPollInterval();
  if (currentTime - lastCommandPollAt_ < interval) {
    return;
  }
  if (!api_.pollCommand(
      awaitingFruitAfterTimeout_ ? "awaiting_fruit" : "idle",
      feederSensorState_,
      lastFeedCommandId_,
      classifier_.available())) {
    return;
  }
  lastCommandPollAt_ = currentTime;
  networkRequest_ = NetworkRequest::kCommand;
}

void CaptureController::handleCommandResult(
    const HttpResult& result, uint32_t currentTime) {
  if (!result.isSuccess()) {
    Serial.print("Command GET failed: ");
    Serial.print(result.statusCode);
    Serial.print(" error=");
    Serial.print(httpErrorName(result.statusCode));
    Serial.print(" request_ms=");
    Serial.println(result.elapsedMS);
    registerCommandFailure(result.statusCode);
    return;
  }

  resetCommandFailures();
  const MotorCommand command = api_.parseCommandText(result.body);
  if (networkInterlocked_) {
    if (command.command == "recover_network") recoverNetwork(command, currentTime);
    return;
  }
  if (command.hasAutoTriggerEnabled) {
    setAutoTriggerEnabled(command.autoTriggerEnabled, command.serverStatus);
  }
  stageTimingConfig(command);
  if (applyPendingTimingConfig(currentTime)) {
    return;
  }
  if (command.command == "none" || command.commandId <= 0) {
    return;
  }

  handleCommand(command, millis());
}

uint32_t CaptureController::currentCommandPollInterval() const {
  if (autoTrigger_.waitingForStartSequence) {
    return FirmwareConfig::kStartSequenceCommandPollIntervalMS;
  }
  if (motionPhase_ == MotionPhase::kWaitingForCommand) {
    return FirmwareConfig::kAwaitReleaseCommandPollIntervalMS;
  }
  return appliedTiming_.idleCommandPollIntervalMS;
}

void CaptureController::handleCommand(
    const MotorCommand& command,
    uint32_t currentTime) {
  if (command.command == "recover_network") {
    recoverNetwork(command, currentTime);
    return;
  }
  checkControlSafety(currentTime);
  if (networkInterlocked_ || leaseDeadline_ == 0 || timeReached(currentTime, leaseDeadline_)) return;
  stageTimingConfig(command);
  if (command.commandId == lastConfirmedCommandId_ ||
      command.commandId == executingCommandId_) {
    return;
  }

  Serial.print("Command #");
  Serial.print(command.commandId);
  Serial.print(": ");
  Serial.print(command.command);
  Serial.print(" station ");
  Serial.println(command.stationIndex);

  if (!saveInterlock(1)) {
    lockNetwork("recovery_persist_failed");
    return;
  }
  operationStarted_ = true;
  if (classifierCommandActive_ && command.command != "classify_fruit") {
    logCommandRejected(command, "classifier_busy");
    return;
  }

  if (command.command == "classify_fruit") {
    const bool waitingForGate3Classification =
        sequenceActive_ &&
        activeStationIndex_ == FirmwareConfig::kGateCount &&
        motionPhase_ == MotionPhase::kWaitingForCommand &&
        gates_.atAngle(1, FirmwareConfig::kReleaseAngle) &&
        gates_.atAngle(2, FirmwareConfig::kReleaseAngle) &&
        gates_.atHome(3);
    if (!waitingForGate3Classification) {
      queueClassifierFailure(command, "gate3_classification_not_ready");
      return;
    }
    if (classifierCommandActive_ || classifier_.busy()) {
      logCommandRejected(command, "classifier_busy");
      return;
    }
    startClassifier(command, currentTime);
    return;
  }

  if (command.command == "feed_one") {
    const bool validContext =
        command.feedContext == "calibration" ||
        command.feedContext == "production";
    if (!validContext || sequenceActive_ ||
        classifierCommandActive_ || classifier_.busy() ||
        motionPhase_ != MotionPhase::kIdle) {
      queueMotorError(command, "feed_not_safe");
      return;
    }
    startFeeder(command);
    return;
  }

  if (command.command == "start_sequence") {
    if (sequenceActive_) {
      queueMotorError(command, "start_sequence_while_sequence_active");
      return;
    }
    startSequence(command, currentTime);
    return;
  }

  if (command.command == "release_gate") {
    releaseGate(command, currentTime);
    return;
  }

  queueMotorError(command, "unknown_command");
}

void CaptureController::startFeeder(const MotorCommand& command) {
  awaitingFruitAfterTimeout_ = false;
  snapshotActiveTiming();
  activeCommand_ = command;
  const float distanceCM = sensor_.readCentimeters();
  checkControlSafety(millis());
  if (networkInterlocked_) return;
  lastSensorReadAt_ = millis();
  feederSensorState_ = distanceCM <= 0.0F
      ? "unavailable"
      : (distanceCM > FirmwareConfig::kRearmDistanceCM ? "clear" : "blocked");
  if (feederSensorState_ != "clear") {
    feeder_.writeMicroseconds(activeTiming_.feederStopUS);
    motionPhase_ = MotionPhase::kWaitingForReport;
    const String event = feederSensorState_ == "unavailable"
        ? "feeder_sensor_unavailable"
        : "feeder_sensor_not_clear";
    queueReport(
        event,
        0,
        command.commandId,
        feederSensorState_,
        activeTiming_.revision,
        "",
        false,
        0,
        activeTiming_.feederMaxRunMS,
        event);
    return;
  }
  setAutoTriggerEnabled(false, command.feedContext + "_feed_active");
  executingCommandId_ = command.commandId;
  feeder_.writeMicroseconds(activeTiming_.feederDriveUS);
  feederStartedAt_ = millis();
  motionPhase_ = MotionPhase::kFeederDriving;
  phaseDeadlineAt_ = feederStartedAt_ + activeTiming_.feederMaxRunMS;
  Serial.print("Feeder started. context=");
  Serial.print(command.feedContext);
  Serial.print(" command_id=");
  Serial.print(command.commandId);
  Serial.print(" max_run_ms=");
  Serial.println(activeTiming_.feederMaxRunMS);
}

void CaptureController::stopFeeder(
    const String& event,
    const String& stopReason) {
  feeder_.writeMicroseconds(activeTiming_.feederStopUS);
  const uint32_t stoppedAt = millis();
  awaitingFruitAfterTimeout_ = (
      activeCommand_.feedContext == "production" &&
      event == "feeder_max_run_timeout");
  if (stopReason == "hcsr04") {
    if (activeCommand_.feedContext == "production") {
      latchAutoTrigger(stoppedAt);
    } else {
      triggerArmed_ = false;
    }
  }
  const uint32_t elapsedMS = stoppedAt - feederStartedAt_;
  lastFeedCommandId_ = activeCommand_.commandId;
  motionPhase_ = MotionPhase::kWaitingForReport;
  queueReport(
      event,
      0,
      activeCommand_.commandId,
      activeCommand_.feedContext + "_" + stopReason,
      activeTiming_.revision,
      "",
      false,
      elapsedMS,
      activeTiming_.feederMaxRunMS,
      stopReason);
  Serial.print("Feeder stopped locally. reason=");
  Serial.print(stopReason);
  Serial.print(" elapsed_ms=");
  Serial.println(elapsedMS);
}

void CaptureController::startClassifier(
    const MotorCommand& command,
    uint32_t currentTime) {
  classifierCommandActive_ = true;
  executingCommandId_ = command.commandId;
  activeCommand_ = command;
  motionPhase_ = MotionPhase::kWaitingForReport;
  setAutoTriggerEnabled(false, "classifier_busy");

  String reason;
  if (!classifier_.start(
          command.commandId,
          command.classificationCode,
          currentTime,
          reason)) {
    queueClassifierFailure(command, reason.length() > 0 ? reason : "classifier_busy");
    return;
  }

  Serial.print("Classifier command #");
  Serial.print(command.commandId);
  Serial.print(" code=");
  Serial.println(command.classificationCode);
}

void CaptureController::queueClassifierFailure(
    const MotorCommand& command,
    const String& reason) {
  classifierCommandActive_ = true;
  executingCommandId_ = command.commandId;
  activeCommand_ = command;
  motionPhase_ = MotionPhase::kWaitingForReport;
  setAutoTriggerEnabled(false, "classifier_error");
  logCommandRejected(command, reason);
  queueReport(
      "classification_sorter_failed",
      0,
      command.commandId,
      reason,
      0,
      command.classificationCode,
      false);
}

void CaptureController::logCommandRejected(
    const MotorCommand& command,
    const String& reason) const {
  Serial.print("Command rejected: id=");
  Serial.print(command.commandId);
  Serial.print(" type=");
  Serial.print(command.command);
  Serial.print(" reason=");
  Serial.println(reason);
}

void CaptureController::startSequence(
    const MotorCommand& command,
    uint32_t currentTime) {
  clearAutoTrigger("start_sequence_command_received");
  setAutoTriggerEnabled(false, "sequence_active");
  if (!hasActiveTiming_) {
    snapshotActiveTiming();
  }
  activeCommand_ = command;
  activeStationIndex_ = 1;
  sequenceActive_ = true;
  executingCommandId_ = command.commandId;
  printTiming("start_sequence_received");

  if (motionPhase_ == MotionPhase::kBootHomeSettling) {
    motionPhase_ = MotionPhase::kStartStation1Settling;
    phaseDeadlineAt_ += activeTiming_.firstStationSettleMS;
    return;
  }

  if (!gates_.atHome()) {
    gates_.moveAllHome();
    motionPhase_ = MotionPhase::kStartHomeSettling;
    phaseDeadlineAt_ = currentTime + activeTiming_.servoSettleMS;
    return;
  }

  motionPhase_ = MotionPhase::kStartStation1Settling;
  phaseDeadlineAt_ = currentTime + activeTiming_.firstStationSettleMS;
  printTiming("station_1_settling_started");
}

void CaptureController::releaseGate(
    const MotorCommand& command,
    uint32_t currentTime) {
  if (command.stationIndex < 1 ||
      command.stationIndex > FirmwareConfig::kGateCount) {
    queueMotorError(command, "invalid_station_index");
    return;
  }
  if (!sequenceActive_ || motionPhase_ != MotionPhase::kWaitingForCommand) {
    queueMotorError(command, "release_gate_not_expected");
    return;
  }
  if (command.stationIndex != activeStationIndex_) {
    queueMotorError(command, "release_gate_station_mismatch");
    return;
  }
  if (!gates_.moveGate(command.stationIndex, command.releaseAngle)) {
    queueMotorError(command, "gate_index_out_of_range");
    return;
  }

  if (!hasActiveTiming_) {
    snapshotActiveTiming();
  }
  activeCommand_ = command;
  executingCommandId_ = command.commandId;
  motionPhase_ = MotionPhase::kReleaseServoSettling;
  phaseDeadlineAt_ = currentTime + activeTiming_.servoSettleMS;
  printTiming(
      String("release_gate_") + String(command.stationIndex) + String("_received"));
}

void CaptureController::queueMotorError(
    const MotorCommand& command,
    const String& reason) {
  Serial.print("Motor command rejected: ");
  Serial.println(reason);
  gates_.moveAllHome();
  setAutoTriggerEnabled(false, "motor_error");
  sequenceActive_ = false;
  clearActiveTiming();
  activeStationIndex_ = 0;
  activeCommand_ = MotorCommand();
  executingCommandId_ = command.commandId;
  motionPhase_ = MotionPhase::kBootHomeSettling;
  phaseDeadlineAt_ = millis() + appliedTiming_.servoSettleMS;
  queueReport("motor_error", command.stationIndex, command.commandId, reason);
}

void CaptureController::setAutoTriggerEnabled(
    bool enabled,
    const String& serverStatus) {
  if (serverStatus.length() > 0) {
    lastServerStatus_ = serverStatus;
  }
  if (autoTriggerEnabled_ == enabled) {
    return;
  }

  autoTriggerEnabled_ = enabled;
  Serial.print("Auto trigger: ");
  Serial.print(autoTriggerEnabled_ ? "enabled" : "disabled");
  if (lastServerStatus_.length() > 0) {
    Serial.print(" (server_status=");
    Serial.print(lastServerStatus_);
    Serial.print(")");
  }
  Serial.println();
}

void CaptureController::registerCommandFailure(int httpCode) {
  consecutiveCommandFailures_ += 1;
  uint32_t backoffMS = FirmwareConfig::kCommandFailureBackoffMinMS;
  if (autoTrigger_.waitingForStartSequence) {
    backoffMS = FirmwareConfig::kStartSequenceCommandPollIntervalMS;
  } else if (motionPhase_ == MotionPhase::kWaitingForCommand) {
    backoffMS = FirmwareConfig::kAwaitReleaseCommandPollIntervalMS;
  } else if (consecutiveCommandFailures_ >= 2) {
    backoffMS = FirmwareConfig::kCommandFailureBackoffMaxMS;
  }

  commandBackoffUntilAt_ = millis() + backoffMS;
  Serial.print("Command polling backoff: ");
  Serial.print(backoffMS);
  Serial.print(" ms after ");
  Serial.print(consecutiveCommandFailures_);
  Serial.print(" failure(s), last_error=");
  Serial.println(httpErrorName(httpCode));
}

void CaptureController::resetCommandFailures() {
  consecutiveCommandFailures_ = 0;
  commandBackoffUntilAt_ = 0;
}

void CaptureController::printReportSummary(
    const String& event,
    const HttpResult& result) const {
  Serial.print("Report ");
  Serial.print(event);
  Serial.print(" HTTP ");
  Serial.print(result.statusCode);
  Serial.print(" request_ms=");
  Serial.print(result.elapsedMS);
  Serial.print(" body_length=");
  Serial.print(result.body.length());
  Serial.print(" ignored=");
  Serial.print(DjangoApiClient::responseHasIgnored(result.body) ? "1" : "0");
  Serial.print(" start_sequence=");
  Serial.println(result.body.indexOf("start_sequence") >= 0 ? "1" : "0");

  if (FirmwareConfig::kVerboseHttpResponseLog && result.body.length() > 0) {
    Serial.println(result.body);
  }
}

void CaptureController::printTriggerDebug(
    const String& reason,
    float distanceCM,
    uint32_t currentTime,
    bool force) {
  if (!force &&
      lastTriggerDebugAt_ != 0 &&
      currentTime - lastTriggerDebugAt_ < FirmwareConfig::kTriggerDebugIntervalMS) {
    return;
  }
  lastTriggerDebugAt_ = currentTime;

  Serial.print("HC-SR04 trigger debug: reason=");
  Serial.print(reason);
  Serial.print(" distance=");
  Serial.print(distanceCM);
  Serial.print(" cm auto_trigger_enabled=");
  Serial.print(autoTriggerEnabled_ ? "1" : "0");
  Serial.print(" server_status=");
  Serial.print(lastServerStatus_.length() > 0 ? lastServerStatus_ : "unknown");
  Serial.print(" trigger_armed=");
  Serial.print(triggerArmed_ ? "1" : "0");
  Serial.print(" sequence_active=");
  Serial.print(sequenceActive_ ? "1" : "0");
  Serial.print(" pending_hcsr04_trigger=");
  Serial.println(autoTrigger_.active() ? "1" : "0");
}

void CaptureController::printTiming(const String& eventName) const {
  Serial.print("TIMING ");
  Serial.print(eventName);
  Serial.print(" ms=");
  Serial.println(millis());
}

bool CaptureController::timeReached(uint32_t currentTime, uint32_t deadline) {
  return static_cast<int32_t>(currentTime - deadline) >= 0;
}

const char* CaptureController::httpErrorName(int httpCode) {
  switch (httpCode) {
    case -1:
      return "CONNECTION_REFUSED";
    case -2:
      return "SEND_HEADER_FAILED";
    case -3:
      return "SEND_PAYLOAD_FAILED";
    case -4:
      return "NOT_CONNECTED";
    case -5:
      return "CONNECTION_LOST";
    case -6:
      return "NO_STREAM";
    case -7:
      return "NO_HTTP_SERVER";
    case -8:
      return "TOO_LESS_RAM";
    case -9:
      return "ENCODING";
    case -10:
      return "STREAM_WRITE";
    case -11:
      return "READ_TIMEOUT";
    default:
      return "HTTP_ERROR";
  }
}
