Eten0721/PassionFruit_IoT_hardware/firmware/Three_Gate_Data_Collection/CaptureController.h

#pragma once

#include <Arduino.h>
#include <ESP32Servo.h>
#include <Preferences.h>

#include "Config.h"
#include "ClassifierController.h"
#include "DjangoApiClient.h"
#include "DistanceSensor.h"
#include "GateController.h"
#include "ProtocolTypes.h"

class CaptureController {
 public:
  void begin();
  void tick();

 private:
  enum class MotionPhase : uint8_t {
    kBootHomeSettling,
    kIdle,
    kFeederDriving,
    kStartHomeSettling,
    kStartStation1Settling,
    kReleaseServoSettling,
    kNextStationSettling,
    kFinalFruitSettling,
    kFinalGateReturnDelay,
    kFinalHomeSettling,
    kWaitingForReport,
    kWaitingForCommand,
    kRecoverySettling,
  };

  enum class AutoTriggerPhase : uint8_t {
    kNone,
    kFastWaitingForStationSettle,
    kFastReportPending,
    kLegacyReportPending,
    kLegacyWaitingForStartSequence,
  };

  struct PendingReport {
    bool active;
    String event;
    int stationIndex;
    int commandId;
    String message;
    uint32_t timingRevision;
    String classificationCode;
    bool includeStationIndex;
    uint32_t feederElapsedMS;
    uint32_t feederMaxRunMS;
    String feederStopReason;
    uint32_t lastAttemptAt;

    PendingReport()
        : active(false),
          event(""),
          stationIndex(0),
          commandId(0),
          message(""),
          timingRevision(0),
          classificationCode(""),
          includeStationIndex(true),
          feederElapsedMS(0),
          feederMaxRunMS(0),
          feederStopReason(""),
          lastAttemptAt(0) {}
  };

  struct AutoTrigger {
    AutoTriggerPhase phase;
    String triggerId;
    uint32_t nextAttemptAt;
    bool waitingForStartSequence;
    uint32_t waitingStartedAt;

    AutoTrigger()
        : phase(AutoTriggerPhase::kNone),
          triggerId(""),
          nextAttemptAt(0),
          waitingForStartSequence(false),
          waitingStartedAt(0) {}

    bool active() const {
      return phase != AutoTriggerPhase::kNone;
    }
  };

  DistanceSensor sensor_{FirmwareConfig::kUltrasonicTrigPin,
                         FirmwareConfig::kUltrasonicEchoPin};
  GateController gates_;
  ClassifierController classifier_;
  Servo feeder_;
  DjangoApiClient api_;
  bool bootReleased_ = false;
  bool bootRawLow_ = false;
  bool bootConsumed_ = false;
  bool setupAwaitingGrant_ = false;
  bool centralSetupBlocked_ = false;
  uint32_t bootChangedAt_ = 0;
  uint32_t setupRequestedAt_ = 0;
  bool setupAllowedLocal() const;
  const char* setupBlockReason() const;
  bool setupButtonPressed(uint32_t currentTime);
  void checkSetupButton(uint32_t currentTime);
  void beginSetupRequest(uint32_t currentTime, const char* source);

  MotionPhase motionPhase_ = MotionPhase::kBootHomeSettling;
  uint32_t phaseDeadlineAt_ = 0;
  MotorCommand activeCommand_;
  int activeStationIndex_ = 0;
  bool sequenceActive_ = false;
  bool classifierCommandActive_ = false;
  TimingConfig appliedTiming_;
  TimingConfig pendingTiming_;
  TimingConfig activeTiming_;
  bool hasPendingTiming_ = false;
  bool hasActiveTiming_ = false;

  enum class NetworkRequest : uint8_t { kNone, kCommand, kFastTrigger, kLegacyTrigger, kReport, kHeartbeat };
  NetworkRequest networkRequest_ = NetworkRequest::kNone;
  void collectNetworkResult(uint32_t currentTime);
  void handleCommandResult(const HttpResult& result, uint32_t currentTime);
  void handleFastPathResult(const HttpResult& result, uint32_t currentTime);
  void handleLegacyTriggerResult(const HttpResult& result, uint32_t currentTime);
  void handleReportResult(const HttpResult& result);

  PendingReport pendingReport_;
  AutoTrigger autoTrigger_;

  uint32_t lastSensorReadAt_ = 0;
  uint32_t lastDistancePrintAt_ = 0;
  uint32_t lastTriggerDebugAt_ = 0;
  uint32_t lastTriggerAt_ = 0;
  uint32_t lastCommandPollAt_ = 0;
  uint32_t commandBackoffUntilAt_ = 0;
  uint32_t triggerSequence_ = 0;
  int consecutiveCommandFailures_ = 0;
  int lastConfirmedCommandId_ = 0;
  int executingCommandId_ = 0;
  int lastFeedCommandId_ = 0;
  uint32_t feederStartedAt_ = 0;
  String feederSensorState_ = "unavailable";
  bool awaitingFruitAfterTimeout_ = false;
  bool triggerArmed_ = true;
  bool autoTriggerEnabled_ = false;
  String lastServerStatus_;
  struct InterlockRecord {
    uint32_t schema = 1;
    uint32_t generation = 0;
    int commandId = 0;
    uint32_t stopUS = FirmwareConfig::kFeederStopUS;
    uint8_t phase = 0;  // 0 idle, 1 locked/unfinished, 2 homed, 3 locally committed.
  } interlockRecord_;
  Preferences preferences_;
  bool preferencesReady_ = false;
  bool networkInterlocked_ = false;
  bool persistFailed_ = false;
  bool operationStarted_ = false;
  uint32_t generation_ = 0;
  uint32_t leaseDeadline_ = 0;
  uint32_t lastHeartbeatAt_ = 0;
  bool yieldAfterHeartbeat_ = false;
  uint32_t linkLostAt_ = 0;
  String leasedRunId_;
  uint32_t leasedRevision_ = 0;
  uint32_t lastAcceptedSentAt_ = 0;
  bool hasAcceptedSentAt_ = false;
  bool recoveryPermission_ = false;
  String localIP_;
  bool recoveryRunning_ = false;
  bool saveInterlock(uint8_t phase);
  void lockNetwork(const String& reason);
  void checkControlSafety(uint32_t currentTime);
  bool acceptControlResult(const HttpResult& result, uint32_t currentTime);
  void recoverNetwork(const MotorCommand& command, uint32_t currentTime);

  void advanceMotion(uint32_t currentTime);
  void handleSensor(uint32_t currentTime);
  bool shouldStartAutoTrigger(float distanceCM, uint32_t currentTime, String& reason) const;
  void latchAutoTrigger(uint32_t currentTime);
  bool processAutoTrigger(uint32_t currentTime);
  void sendFastPathReport(uint32_t currentTime);
  void sendLegacyTriggerReport(uint32_t currentTime);
  void startLegacyFallback(uint32_t currentTime, const String& reason);
  void clearAutoTrigger(const String& reason);
  void startStartSequenceWait(uint32_t currentTime, const String& reason);
  void checkStartSequenceWaitTimeout(uint32_t currentTime);
  String createTriggerId(uint32_t currentTime);
  bool gatesAreSafeForFastPath() const;

  bool flushPendingReport(uint32_t currentTime);
  void queueReport(
      const String& event,
      int stationIndex,
      int commandId,
      const String& message,
      uint32_t timingRevision = 0,
      const String& classificationCode = "",
      bool includeStationIndex = true,
      uint32_t feederElapsedMS = 0,
      uint32_t feederMaxRunMS = 0,
      const String& feederStopReason = "");
  void handlePendingReportSuccess(const String& event);
  void collectClassifierResult();

  TimingConfig defaultTimingConfig() const;
  bool timingConfigIsValid(const TimingConfig& timing) const;
  bool timingConfigCanApply() const;
  void stageTimingConfig(const MotorCommand& command);
  bool applyPendingTimingConfig(uint32_t currentTime);
  void snapshotActiveTiming();
  void clearActiveTiming();

  void pollCommand(uint32_t currentTime);
  uint32_t currentCommandPollInterval() const;
  void handleCommand(const MotorCommand& command, uint32_t currentTime);
  void startSequence(const MotorCommand& command, uint32_t currentTime);
  void releaseGate(const MotorCommand& command, uint32_t currentTime);
  void startClassifier(const MotorCommand& command, uint32_t currentTime);
  void startFeeder(const MotorCommand& command);
  void stopFeeder(
      const String& event,
      const String& stopReason);
  void queueClassifierFailure(const MotorCommand& command, const String& reason);
  void logCommandRejected(const MotorCommand& command, const String& reason) const;
  void queueMotorError(const MotorCommand& command, const String& reason);
  void setAutoTriggerEnabled(bool enabled, const String& serverStatus);
  void registerCommandFailure(int httpCode);
  void resetCommandFailures();

  void printReportSummary(const String& event, const HttpResult& result) const;
  void printTriggerDebug(
      const String& reason,
      float distanceCM,
      uint32_t currentTime,
      bool force);
  void printTiming(const String& eventName) const;
  static bool timeReached(uint32_t currentTime, uint32_t deadline);
  static const char* httpErrorName(int httpCode);
};
