Eten0721/PassionFruit_IoT_hardware/Django_Server/fruit_app/detection.py

"""Local four-model inference and durable capture-session results."""

from __future__ import annotations

import copy
import csv
import json
import shutil
import threading
import uuid
from datetime import datetime
from pathlib import Path
from time import perf_counter
from typing import Any, Callable

import cv2
import numpy as np

from . import dataset_store, grading


ARTIFACT_NAMES = (
    'roi_annotated',
    'masked_roi',
    'wrinkle_gray',
    'defect_annotated',
    'defect_marked',
)
MODEL_ROLES = ('roi', 'color', 'wrinkle', 'defect')
DEFECT_CLASSES = {'abrasion', 'anthracnose', 'insect_bite', 'insect_track'}
# RGB; shared by farmer markings and Chinese legends, independent of class indexes.
DEFECT_COLORS = {
    'abrasion': (210, 35, 45), 'anthracnose': (20, 85, 210),
    'insect_bite': (0, 130, 85), 'insect_track': (165, 35, 175),
}
DEFECT_MARKED_SUFFIX = '_defect_marked_farmer_v1.jpg'
CONTRACT_VERSION = 1
MANUAL_SOURCE = 'manual'
SUMMARY_FIELDS = [
    'result_id', 'fruit_id', 'capture_time', 'completed_at', 'hardware_mode',
    'result_status', 'classification_status', 'reason', 'view_01_grade', 'view_02_grade', 'view_03_grade',
    'final_grade', 'final_label', 'final_code', 'classification_source',
    'model_version', 'result_json',
]
_SUMMARY_LOCK = threading.Lock()


def _class_names(model) -> set[str]:
    names = getattr(model, 'names', {})
    values = names.values() if isinstance(names, dict) else names
    return {str(value) for value in values}


def _validate_class_semantics(role: str, names: set[str]) -> None:
    if role == 'roi' and len(names) != 1:
        raise ValueError('ROI 模型必須只有一個果實類別。')
    if role == 'color' and names != {'good_color', 'bad_color'}:
        raise ValueError(
            'color 模型類別必須是 good_color 與 bad_color。'
        )
    if role == 'wrinkle':
        mapped = {_wrinkle_label(name) for name in names}
        if mapped != {'無皺褶（好）', '有皺褶（壞）'}:
            raise ValueError('wrinkle 模型類別語意無法對應皺褶好壞。')
    if role == 'defect' and names != DEFECT_CLASSES:
        raise ValueError('defect 模型類別與四類局部瑕疵契約不符。')


def _wrinkle_label(class_name: str) -> str | None:
    normalized = class_name.casefold().replace('-', '_').replace(' ', '_')
    good_markers = ('沒皺褶', '無皺褶', 'smooth', 'no_wrinkle', 'false')
    bad_markers = ('有皺褶', 'wrinkle', 'true')
    if any(marker in normalized for marker in good_markers):
        return '無皺褶（好）'
    if any(marker in normalized for marker in bad_markers):
        return '有皺褶（壞）'
    return None


def _predict_batch(model, role, images, device, model_options):
    if not images:
        return [], 0.0
    options = {'device': device, 'verbose': False}
    settings = (model_options or {}).get(role, {})
    confidence = settings.get('confidence', 0.30 if role == 'roi' else None)
    if confidence is not None:
        options['conf'] = float(confidence)
    if settings.get('imgsz') is not None:
        options['imgsz'] = int(settings['imgsz'])
    started = perf_counter()
    results = model.predict(source=images, **options)
    if len(results) != len(images):
        raise RuntimeError(
            f'{role} batch 推論回傳數量（{len(results)}）與輸入數量'
            f'（{len(images)}）不一致。'
        )
    return results, round((perf_counter() - started) * 1000 / len(images), 2)


def _prepare_roi(image, result, elapsed_ms):
    boxes = getattr(result, 'boxes', None)
    if boxes is None or not len(boxes):
        return {
            'status': 'error', 'reason': 'roi_not_detected',
            'elapsed_ms': elapsed_ms,
        }, {}
    confidences = boxes.conf.detach().cpu().numpy().reshape(-1)
    best = int(np.argmax(confidences))
    bbox = boxes.xyxy[best].detach().cpu().numpy().reshape(-1)
    if bbox.size != 4 or not np.isfinite(bbox).all():
        raise ValueError('ROI 模型回傳的 bbox 格式不正確。')
    height, width = image.shape[:2]
    dx1, dy1, dx2, dy2 = map(float, bbox)
    x1, x2 = (int(round(np.clip(value, 0, width))) for value in sorted((dx1, dx2)))
    y1, y2 = (int(round(np.clip(value, 0, height))) for value in sorted((dy1, dy2)))
    if x2 <= x1 or y2 <= y1:
        raise ValueError('ROI bbox 經邊界修正後沒有有效面積。')
    crop = image[y1:y2, x1:x2]
    crop_height, crop_width = crop.shape[:2]
    mask = np.zeros((crop_height, crop_width), dtype=np.uint8)
    cv2.ellipse(
        mask, (crop_width // 2, crop_height // 2),
        (max(1, int(crop_width / 2 * 1.01)),
         max(1, int(crop_height / 2 * 1.01))),
        0, 0, 360, 255, -1,
    )
    masked = cv2.bitwise_and(crop, crop, mask=mask)
    roi = {
        'bbox': [round(value, 2) for value in (dx1, dy1, dx2, dy2)],
        'crop_bbox': [x1, y1, x2, y2],
        'confidence': round(float(confidences[best]), 6),
        'roi_area_ratio': round(
            max(0.0, dx2 - dx1) * max(0.0, dy2 - dy1) / (width * height), 8,
        ),
        'status': 'ok', 'reason': None, 'elapsed_ms': elapsed_ms,
    }
    annotated = image.copy()
    ax1, ay1, ax2, ay2 = (int(round(value)) for value in roi['bbox'])
    cv2.rectangle(annotated, (ax1, ay1), (ax2, ay2), (0, 220, 0), 3)
    cv2.putText(
        annotated, f"PF {roi['confidence']:.1%}",
        (max(0, ax1), max(25, ay1 - 8)), cv2.FONT_HERSHEY_SIMPLEX,
        0.8, (0, 220, 0), 2, cv2.LINE_AA,
    )
    gray = cv2.createCLAHE(clipLimit=2.0, tileGridSize=(8, 8)).apply(
        cv2.cvtColor(masked, cv2.COLOR_BGR2GRAY)
    )
    return roi, {
        'roi_annotated': annotated, 'masked_roi': masked,
        'roi_mask': mask, 'wrinkle_gray': gray,
    }


def _classification_summary(result, elapsed_ms):
    probabilities = getattr(result, 'probs', None)
    if probabilities is None:
        raise ValueError('分類模型沒有回傳 probabilities。')
    index = int(probabilities.top1)
    return {
        'status': 'ok', 'class_name': str(result.names[index]),
        'class_index': index,
        'confidence': round(float(probabilities.top1conf.item()), 6),
        'elapsed_ms': elapsed_ms, 'reason': None,
    }


def _segmentation_summary(result, elapsed_ms, roi_mask):
    boxes = getattr(result, 'boxes', None)
    masks = getattr(result, 'masks', None)
    area_ratios = {name: 0.0 for name in sorted(DEFECT_CLASSES)}
    max_confidences = dict(area_ratios)
    detections = []
    if boxes is not None and len(boxes):
        if masks is None or getattr(masks, 'data', None) is None:
            raise ValueError('局部瑕疵模型有偵測結果，但沒有回傳 segmentation masks。')
        classes = boxes.cls.detach().cpu().numpy().astype(int)
        confidences = boxes.conf.detach().cpu().numpy()
        mask_data = masks.data.detach().cpu().numpy()
        if len(mask_data) != len(classes) or len(confidences) != len(classes):
            raise ValueError('局部瑕疵模型回傳的 boxes 與 masks 數量不一致。')
        denominator = int(np.count_nonzero(roi_mask))
        if denominator <= 0:
            raise ValueError('果實 ROI 面積為 0，無法計算局部瑕疵比例。')
        union_masks = {
            name: np.zeros(roi_mask.shape, dtype=bool) for name in area_ratios
        }
        class_indexes = {}
        for class_index, confidence, instance in zip(
            classes, confidences, mask_data, strict=True,
        ):
            class_index = int(class_index)
            name = str(result.names[class_index])
            if name not in union_masks:
                raise ValueError(f'未知的局部瑕疵類別：{name}')
            resized = cv2.resize(
                instance, (roi_mask.shape[1], roi_mask.shape[0]),
                interpolation=cv2.INTER_NEAREST,
            )
            union_masks[name] |= (resized > 0.5) & (roi_mask > 0)
            class_indexes[name] = class_index
            max_confidences[name] = max(
                max_confidences[name], round(float(confidence), 6),
            )
        for name, union in union_masks.items():
            area_ratios[name] = round(
                min(1.0, np.count_nonzero(union) / denominator), 8,
            )
            if name in class_indexes:
                detections.append({
                    'class_name': name, 'class_index': class_indexes[name],
                    'confidence': max_confidences[name],
                    'mask_area_ratio': area_ratios[name],
                })
    return {
        'status': 'ok', 'detections': detections, 'area_ratios': area_ratios,
        'max_confidences': max_confidences, 'elapsed_ms': elapsed_ms,
        'reason': None,
    }


def render_defect_marked(result):
    """Draw real masks/boxes with fixed farmer colors and no text, in BGR."""
    marked = result.orig_img.copy()
    boxes = getattr(result, 'boxes', None)
    if boxes is None or not len(boxes):
        return marked
    masks = getattr(result, 'masks', None)
    if masks is None:
        raise ValueError('瑕疵標示缺少 segmentation masks。')
    from ultralytics.utils.ops import scale_masks

    classes = boxes.cls.detach().cpu().numpy().astype(int)
    coordinates = boxes.xyxy.detach().cpu().numpy()
    height, width = marked.shape[:2]
    instances = scale_masks(masks.data.detach().cpu()[None], (height, width))[0].numpy()
    colors = []
    for class_index, instance in zip(classes, instances, strict=True):
        color = tuple(reversed(DEFECT_COLORS[result.names[int(class_index)]]))
        colors.append(color)
        mask = instance > 0.5
        marked[mask] = (marked[mask] * 0.5 + np.asarray(color) * 0.5).astype(np.uint8)
    for bbox, color in zip(coordinates, colors, strict=True):
        x1, y1, x2, y2 = np.rint(bbox).astype(int)
        # A white halo keeps the colored outline visible on dark fruit skins.
        cv2.rectangle(marked, (x1, y1), (x2, y2), (255, 255, 255), 8)
        cv2.rectangle(marked, (x1, y1), (x2, y2), color, 4)
    return marked


def _summarise_role(role, ready_indices, results, elapsed_ms, reports, artifacts_list):
    for index, result in zip(ready_indices, results, strict=True):
        try:
            if role == 'defect':
                summary = _segmentation_summary(
                    result, elapsed_ms, artifacts_list[index]['roi_mask'],
                )
                artifacts_list[index]['defect_annotated'] = result.plot()
            else:
                summary = _classification_summary(result, elapsed_ms)
            reports[index]['models'][role] = summary
        except Exception as error:
            reports[index]['models'][role] = {
                'status': 'error', 'reason': f'{type(error).__name__}: {error}',
            }
            continue
        if role == 'defect':
            try:
                artifacts_list[index]['defect_marked'] = render_defect_marked(result)
            except Exception:
                pass  # Optional farmer preview falls back to the original image.


def execute_model_batch(
    image_paths: list[Path],
    model_paths: dict[str, str],
    *,
    model_options: dict[str, dict] | None = None,
    on_stage: Callable[[str, list[dict], list[dict]], None] | None = None,
):
    """Run the fixed deployment pipeline using installed YOLO and local weights.

    ``on_stage`` receives the reports and artifacts after ROI and after each
    later model, so callers can show real progress instead of guessing it.
    """
    paths = {}
    for role in MODEL_ROLES:
        path = model_paths.get(role, '')
        if not path:
            raise FileNotFoundError(f'未設定 {role} 模型路徑。')
        paths[role] = Path(path).expanduser().resolve()
        if not paths[role].is_file():
            raise FileNotFoundError(f'找不到 {role} 模型：{paths[role]}')

    import torch
    from ultralytics import YOLO

    device = 'cuda:0' if torch.cuda.is_available() else 'cpu'
    tasks = {'roi': 'detect', 'color': 'classify',
             'wrinkle': 'classify', 'defect': 'segment'}
    models = {}
    for role, path in paths.items():
        model = YOLO(str(path))
        actual_task = getattr(model, 'task', None)
        if actual_task != tasks[role]:
            raise ValueError(
                f"{role} 應為 {tasks[role]} 模型，目前權重是 {actual_task or 'unknown'}。"
            )
        _validate_class_semantics(role, _class_names(model))
        models[role] = model

    started = perf_counter()
    sources = [Path(path).resolve() for path in image_paths]
    source_images = []
    for source in sources:
        if not source.is_file():
            raise FileNotFoundError(f'找不到圖片：{source}')
        image = cv2.imdecode(np.fromfile(source, dtype=np.uint8), cv2.IMREAD_COLOR)
        if image is None:
            raise ValueError(f'無法讀取圖片：{source}')
        source_images.append(image)
    reports = [{
        'ok': False, 'source': str(source), 'mode': 'pipeline_batch',
        'device': device, 'model_paths': {role: str(path) for role, path in paths.items()},
        'parameters': {
            'confidence': 0.30, 'shrink_ratio': 0.0, 'mask_scale': 1.01,
            'clahe_clip_limit': 2.0, 'clahe_tile_size': 8,
        },
        'roi': None, 'models': {},
    } for source in sources]
    artifacts_list = [{'original': image} for image in source_images]
    ready_indices = []
    try:
        results, elapsed_ms = _predict_batch(
            models['roi'], 'roi', source_images, device, model_options,
        )
    except Exception as error:
        reason = f'{type(error).__name__}: {error}'
        for report in reports:
            report['roi'] = {'status': 'error', 'reason': reason}
    else:
        for index, (image, result) in enumerate(zip(source_images, results, strict=True)):
            try:
                roi, artifacts = _prepare_roi(image, result, elapsed_ms)
                reports[index]['roi'] = roi
                artifacts_list[index].update(artifacts)
                if roi['status'] == 'ok':
                    ready_indices.append(index)
            except Exception as error:
                reports[index]['roi'] = {
                    'status': 'error', 'reason': f'{type(error).__name__}: {error}',
                }
    for index, report in enumerate(reports):
        if index in ready_indices:
            continue
        report['reason'] = report['roi']['reason']
        report['models'] = {
            role: {'status': 'skipped', 'reason': 'roi_unavailable'}
            for role in MODEL_ROLES[1:]
        }
    if on_stage is not None:
        on_stage('roi', reports, artifacts_list)
    for role in MODEL_ROLES[1:]:
        inputs = [
            cv2.cvtColor(artifacts_list[index]['wrinkle_gray'], cv2.COLOR_GRAY2BGR)
            if role == 'wrinkle' else artifacts_list[index]['masked_roi']
            for index in ready_indices
        ]
        try:
            results, elapsed_ms = _predict_batch(
                models[role], role, inputs, device, model_options,
            )
        except Exception as error:
            for index in ready_indices:
                reports[index]['models'][role] = {
                    'status': 'error', 'reason': f'{type(error).__name__}: {error}',
                }
        else:
            _summarise_role(role, ready_indices, results, elapsed_ms,
                            reports, artifacts_list)
        if on_stage is not None:
            on_stage(role, reports, artifacts_list)
    for report in reports:
        report['ok'] = report['roi']['status'] == 'ok' and all(
            summary['status'] == 'ok' for summary in report['models'].values()
        )
        if not report['ok'] and report.get('reason') is None:
            report['reason'] = 'model_inference_failed'
        report['elapsed_ms'] = round((perf_counter() - started) * 1000, 2)
    return reports, artifacts_list


def _atomic_json(path: Path, payload: dict[str, Any]) -> None:
    dataset_store.atomic_write_json(path, payload)


def _copy_original(source: Path, target: Path) -> None:
    dataset_store.atomic_write(target, lambda staging: shutil.copyfile(source, staging))


def _write_artifact(path: Path, image: np.ndarray) -> None:
    success, encoded = cv2.imencode(path.suffix, image)
    if not success:
        raise ValueError(f'圖片編碼失敗：{path.name}')
    dataset_store.atomic_write(path, encoded.tofile)


def _display_models(models: dict[str, dict]) -> dict[str, dict]:
    displayed = {role: dict(models.get(role) or {}) for role in MODEL_ROLES[1:]}
    color = displayed['color']
    if color.get('status') == 'ok':
        color['display_label'] = {
            'good_color': '好',
            'bad_color': '壞',
        }.get(color.get('class_name'))
        if color['display_label'] is None:
            color.update(status='error', reason='color_class_unknown')

    wrinkle = displayed['wrinkle']
    if wrinkle.get('status') == 'ok':
        wrinkle['display_label'] = _wrinkle_label(
            str(wrinkle.get('class_name', ''))
        )
        if wrinkle['display_label'] is None:
            wrinkle.update(status='error', reason='wrinkle_class_unknown')

    defect = displayed['defect']
    if defect.get('status') == 'ok':
        detections = defect.get('detections') or []
        defect['display_label'] = (
            '未偵測到局部瑕疵' if not detections else '偵測到局部瑕疵'
        )
    return displayed


def _image_complete(image: dict) -> bool:
    if image['roi'].get('status') != 'ok':
        return False
    if any(
        image['models'][role].get('status') != 'ok'
        for role in MODEL_ROLES[1:]
    ):
        return False
    return all(name in image['artifacts'] for name in ARTIFACT_NAMES
               if name != 'defect_marked')


def view_features(image: dict) -> dict:
    """Convert one saved view to the delivered XGBoost raw-feature contract.

    A view that lacks any required ROI or model output is reported as
    unavailable instead of being filled with zeros.
    """
    roi = image.get('roi') or {}
    if roi.get('status') != 'ok':
        return {'unavailable': f"roi:{roi.get('reason') or 'unavailable'}"}
    models = image.get('models') or {}
    for role in MODEL_ROLES[1:]:
        summary = models.get(role) or {}
        if summary.get('status') != 'ok':
            return {
                'unavailable': f"{role}:{summary.get('reason') or 'unavailable'}"
            }
    color, wrinkle, defect = models['color'], models['wrinkle'], models['defect']
    color_bad = {'bad_color': 1, 'good_color': 0}.get(color.get('class_name'))
    wrinkle_label = _wrinkle_label(str(wrinkle.get('class_name', '')))
    features = {
        'fruit_area_ratio': roi.get('roi_area_ratio'),
        'color_bad': color_bad,
        'color_confidence': color.get('confidence'),
        'wrinkle': None if wrinkle_label is None else int(
            wrinkle_label == '有皺褶（壞）'
        ),
        'wrinkle_confidence': wrinkle.get('confidence'),
    }
    area_ratios = defect.get('area_ratios') or {}
    max_confidences = defect.get('max_confidences') or {}
    for name in sorted(DEFECT_CLASSES):
        features[f'{name}_area_ratio'] = area_ratios.get(name)
        features[f'{name}_max_confidence'] = max_confidences.get(name)
    return features


def _grade(images: dict[str, dict], grade_model_paths) -> dict:
    try:
        return grading.grade_views(
            {name: view_features(image) for name, image in images.items()},
            grade_model_paths,
        )
    except Exception as error:
        reason = f'grade_model_failed: {type(error).__name__}: {error}'
    return {
        'views': {
            name: grading.unavailable_view('grade_model_failed')
            for name in images
        },
        'classification': grading.needs_review(reason),
        'model': None,
    }


def _sorting(hardware_mode: str) -> dict:
    if hardware_mode == 'photo_only':
        return {'status': 'skipped', 'reason': 'photo_only'}
    return {'status': 'not_started', 'reason': 'gate3_held'}


def _now() -> str:
    return datetime.now().astimezone().isoformat(timespec='seconds')


def _finalise(
    result: dict, *, run_dir: Path, summary_path: Path, replace: bool = True,
) -> dict:
    """Persist JSON, then the summary row; never claim a failed save."""
    fruit_id = result['fruit_id']
    result['storage'] = {
        'status': 'saved', 'reason': None,
        'result_json': f'{run_dir.parent.name}/{fruit_id}/result.json',
        'summary_csv': summary_path.name,
    }
    _set_overall_status(result)
    try:
        _atomic_json(run_dir / 'result.json', result)
    except OSError as error:
        # Still record the failed round in the summary before reporting it.
        result['storage'].update(
            status='failed', result_json=None,
            reason=f'result_json_save_failed: {type(error).__name__}: {error}',
        )
        _set_overall_status(result)
        try:
            upsert_summary(summary_path, result, replace=replace)
        except Exception:
            pass
        return result
    try:
        upsert_summary(summary_path, result, replace=replace)
    except Exception as error:
        result['storage'].update(
            status='failed',
            reason=f'summary_save_failed: {type(error).__name__}: {error}',
        )
        _set_overall_status(result)
        try:
            _atomic_json(run_dir / 'result.json', result)
        except OSError as json_error:
            result['save_errors'].append(
                f'result.json: {type(json_error).__name__}: {json_error}'
            )
    return result


def _set_overall_status(result: dict) -> None:
    """``complete`` means a fully saved model result; a manual grade never is."""
    inference = result['inference']
    classification = result['classification']
    storage = result['storage']
    saved = storage['status'] == 'saved'
    if classification.get('source') == MANUAL_SOURCE and saved:
        # Keep the original failure visible next to the operator's decision.
        result['complete'] = False
        result['status'] = (
            'manual_abandoned' if classification['status'] == 'abandoned'
            else 'manual_completed'
        )
        result['reason'] = (
            inference['reason']
            or (result.get('model_classification') or {}).get('reason')
        )
        return
    complete = (
        inference['status'] == 'completed'
        and classification['status'] == 'graded'
        and saved
    )
    result['complete'] = complete
    result['status'] = 'completed' if complete else 'failed'
    result['reason'] = None if complete else (
        inference['reason'] or classification['reason'] or storage['reason']
    )


def apply_manual_decision(
    *, output_root: Path, summary_path: Path, fruit_id: str, result_id: str,
    grade: int | None,
) -> dict:
    """Record an operator grade, or ``grade=None`` to abandon the round.

    Only a saved needs-review result of this round qualifies. The model's
    classification moves unchanged to ``model_classification``; images,
    inference failure and storage locations are kept. JSON and the summary
    row change together or not at all. An identical repeat is a duplicate
    that only re-syncs the summary row.
    """
    if grade is not None and grade not in range(len(grading.GRADES)):
        raise ValueError(f'人工等級必須是 0～3：{grade!r}')
    result = load_result(output_root, fruit_id)
    if result is None:
        return {'ok': False, 'reason': 'result_not_found'}
    if result.get('result_id') != result_id:
        return {'ok': False, 'reason': 'stale_detection_result'}
    if (result.get('storage') or {}).get('status') != 'saved':
        return {'ok': False, 'reason': 'result_not_saved'}
    classification = result['classification']
    if classification.get('source') == MANUAL_SOURCE:
        if classification.get('grade') != grade:
            return {'ok': False, 'reason': 'already_manual_graded'}
        try:
            upsert_summary(Path(summary_path), result)
        except Exception as error:
            return _save_failure('summary_save_failed', error)
        return {'ok': True, 'duplicate': True, 'result': result}
    if classification.get('status') != 'needs_review':
        return {'ok': False, 'reason': 'not_needs_review'}

    updated = copy.deepcopy(result)
    updated['model_classification'] = classification
    updated['classification'] = _manual_classification(grade)
    _set_overall_status(updated)
    json_path = Path(output_root) / fruit_id / 'result.json'
    try:
        _atomic_json(json_path, updated)
    except OSError as error:
        return _save_failure('result_json_save_failed', error)
    try:
        upsert_summary(Path(summary_path), updated)
    except Exception as error:
        failure = _save_failure('summary_save_failed', error)
        try:
            _atomic_json(json_path, result)
        except OSError as rollback_error:
            # The JSON now runs ahead of the CSV; an identical retry resyncs.
            failure['rollback_error'] = (
                f'{type(rollback_error).__name__}: {rollback_error}'
            )
        return failure
    return {'ok': True, 'duplicate': False, 'result': updated}


def _manual_classification(grade: int | None) -> dict:
    if grade is None:
        return {
            'status': 'abandoned', 'grade': None, 'label': None, 'code': None,
            'source': MANUAL_SOURCE, 'worst_view': None,
            'reason': 'operator_abandoned', 'decided_at': _now(),
        }
    label, code = grading.grade_label(grade)
    return {
        'status': 'graded', 'grade': grade, 'label': label, 'code': code,
        'source': MANUAL_SOURCE, 'worst_view': None, 'reason': None,
        'decided_at': _now(),
    }


def _save_failure(reason: str, error: Exception) -> dict:
    return {
        'ok': False, 'reason': reason,
        'detail': f'{type(error).__name__}: {error}',
    }


def run_and_save(
    *,
    fruit_id: str,
    image_paths: list[Path],
    output_root: Path,
    summary_path: Path,
    model_paths: dict[str, str],
    grade_model_paths: dict[str, str],
    result_id: str | None = None,
    capture_time: str | None = None,
    hardware_mode: str = 'photo_only',
    model_options: dict[str, dict] | None = None,
    progress: Callable[[str, dict], None] | None = None,
) -> dict:
    """Run one three-image batch, grade it and save one durable fruit result.

    ``progress`` receives a copy of the per-image results each time originals
    or a model stage's artifacts are saved; it never decides the outcome.
    """
    root = Path(output_root).resolve()
    root.mkdir(parents=True, exist_ok=True)
    run_dir = root / fruit_id
    if run_dir.exists():
        raise FileExistsError(f'檢測輸出已存在：{run_dir}')
    run_dir.mkdir()

    images: dict[str, dict] = {}
    save_errors = []
    for source in image_paths:
        source = Path(source)
        target_name = f'{source.stem}_original{source.suffix.lower()}'
        images[source.name] = {
            'roi': {'status': 'pending', 'reason': None},
            'models': {},
            'artifacts': {},
        }
        try:
            _copy_original(source, run_dir / target_name)
            images[source.name]['artifacts']['original'] = target_name
        except Exception as error:
            save_errors.append(
                f'{source.name}/original: {type(error).__name__}: {error}'
            )

    written = {Path(source).name: set() for source in image_paths}

    def apply_reports(reports, artifacts_list, missing_roi):
        for source, report, artifacts in zip(
            image_paths, reports, artifacts_list, strict=True
        ):
            source = Path(source)
            image = images[source.name]
            image['roi'] = dict(report.get('roi') or missing_roi)
            image['models'] = _display_models(report.get('models') or {})
            for name in ARTIFACT_NAMES:
                artifact = artifacts.get(name)
                if artifact is None or name in written[source.name]:
                    continue
                written[source.name].add(name)
                relative = f'{source.stem}_{name}.jpg'
                if name == 'defect_marked':
                    relative = f'{source.stem}{DEFECT_MARKED_SUFFIX}'
                try:
                    _write_artifact(run_dir / relative, artifact)
                    image['artifacts'][name] = relative
                except Exception as error:
                    if name != 'defect_marked':
                        save_errors.append(
                            f'{source.name}/{name}: {type(error).__name__}: {error}'
                        )

    def publish(stage):
        if progress is None:
            return
        try:
            progress(stage, copy.deepcopy(images))
        except Exception:
            pass  # Progress is display-only; it must not change the result.

    def on_stage(stage, reports, artifacts_list):
        apply_reports(
            reports, artifacts_list, {'status': 'pending', 'reason': None},
        )
        publish(stage)

    publish('originals')
    try:
        reports, artifacts_list = execute_model_batch(
            image_paths,
            model_paths,
            model_options=model_options,
            on_stage=on_stage,
        )
        if len(reports) != len(image_paths) or len(artifacts_list) != len(image_paths):
            raise RuntimeError('批次推論結果數量與三張輸入不一致。')
    except Exception as error:
        reason = f'{type(error).__name__}: {error}'
        reports = [
            {
                'roi': {'status': 'error', 'reason': reason},
                'models': {
                    role: {'status': 'skipped', 'reason': 'batch_unavailable'}
                    for role in MODEL_ROLES[1:]
                },
            }
            for _ in image_paths
        ]
        artifacts_list = [{} for _ in image_paths]

    apply_reports(
        reports, artifacts_list,
        {'status': 'error', 'reason': 'roi_result_missing'},
    )

    inference_complete = not save_errors and all(
        _image_complete(image) for image in images.values()
    )
    graded = _grade(images, grade_model_paths)
    for name, image in images.items():
        image['grade'] = graded['views'][name]
    result = {
        'contract_version': CONTRACT_VERSION,
        'result_id': result_id or uuid.uuid4().hex,
        'fruit_id': fruit_id,
        'work_mode': 'detection',
        'hardware_mode': hardware_mode,
        'capture_time': capture_time,
        'completed_at': _now(),
        'inference': {
            'status': 'completed' if inference_complete else 'failed',
            'reason': None if inference_complete else (
                'artifact_save_failed' if save_errors else 'detection_incomplete'
            ),
        },
        'classification': graded['classification'],
        'sorting': _sorting(hardware_mode),
        'model': {
            'yolo': {role: Path(path).name for role, path in model_paths.items()},
            'grading': graded['model'],
        },
        'save_errors': save_errors,
        'images': images,
    }
    if (run_dir / 'result.json').exists():
        # A restart already recorded this round as interrupted; keep that.
        existing = load_result(root, fruit_id)
        if existing is not None:
            return existing
    return _finalise(result, run_dir=run_dir, summary_path=Path(summary_path))


def interrupted_result(
    *, fruit_id: str, image_paths: list[Path], result_id: str | None = None,
    capture_time: str | None = None, hardware_mode: str = 'photo_only',
    save_errors=None,
) -> dict:
    result = {
        'contract_version': CONTRACT_VERSION,
        'result_id': result_id or uuid.uuid4().hex,
        'fruit_id': fruit_id,
        'work_mode': 'detection',
        'hardware_mode': hardware_mode,
        'capture_time': capture_time,
        'completed_at': _now(),
        'inference': {'status': 'failed', 'reason': 'service_restarted'},
        'classification': grading.needs_review('service_restarted'),
        'sorting': _sorting(hardware_mode),
        'model': None,
        'storage': {
            'status': 'failed' if save_errors else 'pending',
            'reason': '; '.join(save_errors or []) or None,
            'result_json': None, 'summary_csv': None,
        },
        'save_errors': list(save_errors or []),
        'images': {
            Path(source).name: {
                'roi': {'status': 'error', 'reason': 'service_restarted'},
                'models': {
                    role: {'status': 'skipped', 'reason': 'service_restarted'}
                    for role in MODEL_ROLES[1:]
                },
                'artifacts': {},
                'grade': grading.unavailable_view('service_restarted'),
            }
            for source in image_paths
        },
    }
    _set_overall_status(result)
    return result


def save_interrupted_result(
    *, fruit_id: str, image_paths: list[Path], output_root: Path,
    summary_path: Path, result_id: str | None = None,
    capture_time: str | None = None, hardware_mode: str = 'photo_only',
) -> dict:
    """Persist a restart terminal state without re-running any model."""
    run_dir = Path(output_root).resolve() / fruit_id
    run_dir.mkdir(parents=True, exist_ok=True)
    result = interrupted_result(
        fruit_id=fruit_id, image_paths=image_paths, result_id=result_id,
        capture_time=capture_time, hardware_mode=hardware_mode,
    )
    for source in map(Path, image_paths):
        artifacts = result['images'][source.name]['artifacts']
        original_name = f'{source.stem}_original{source.suffix.lower()}'
        original_path = run_dir / original_name
        try:
            if not original_path.is_file():
                _copy_original(source, original_path)
            artifacts['original'] = original_name
        except Exception as error:
            result['save_errors'].append(
                f'{source.name}/original: {type(error).__name__}: {error}'
            )
        for name in ARTIFACT_NAMES:
            filename = f'{source.stem}_{name}.jpg'
            if name == 'defect_marked':
                filename = f'{source.stem}{DEFECT_MARKED_SUFFIX}'
            if (run_dir / filename).is_file():
                artifacts[name] = filename
    return _finalise(
        result, run_dir=run_dir, summary_path=Path(summary_path), replace=False,
    )


def load_result(output_root: Path, fruit_id: str) -> dict | None:
    try:
        return json.loads(
            (Path(output_root) / fruit_id / 'result.json').read_text(
                encoding='utf-8'
            )
        )
    except (FileNotFoundError, json.JSONDecodeError, OSError):
        return None


def summary_row(result: dict) -> dict:
    classification = result['classification']
    view_grades = [
        image.get('grade', {}).get('grade') for image in result['images'].values()
    ]
    versions = (result.get('model') or {}).get('grading') or {}
    model_version = ';'.join(
        f"{stage}:{versions[stage]['sha256'][:12]}"
        for stage in ('stage1', 'stage2') if stage in versions
    )
    row = {
        'result_id': result['result_id'],
        'fruit_id': result['fruit_id'],
        'capture_time': result.get('capture_time') or '',
        'completed_at': result.get('completed_at') or '',
        'hardware_mode': result.get('hardware_mode') or '',
        'result_status': result['status'],
        'classification_status': classification['status'],
        'reason': result['reason'] or classification['reason'] or '',
        'final_grade': _blank(classification['grade']),
        'final_label': classification['label'] or '',
        'final_code': classification['code'] or '',
        'classification_source': classification['source'] or '',
        'model_version': model_version,
        'result_json': result['storage']['result_json'] or '',
    }
    for index in range(3):
        grade = view_grades[index] if index < len(view_grades) else None
        row[f'view_{index + 1:02d}_grade'] = _blank(grade)
    return row


def _blank(value) -> str:
    return '' if value is None else str(value)


def _read_summary_rows(path: Path) -> list[dict]:
    try:
        with path.open(encoding='utf-8-sig', newline='') as stream:
            return list(csv.DictReader(stream))
    except FileNotFoundError:
        return []


def _write_summary_rows(path: Path, rows: list[dict]) -> None:
    def write(staging):
        with staging.open('w', encoding='utf-8-sig', newline='') as stream:
            writer = csv.DictWriter(
                stream, fieldnames=SUMMARY_FIELDS, extrasaction='ignore',
            )
            writer.writeheader()
            writer.writerows(rows)

    dataset_store.atomic_write(path, write)


def upsert_summary(path: Path, result: dict, *, replace: bool = True) -> None:
    """Keep exactly one row per result_id; retries replace instead of append.

    ``replace=False`` keeps an existing row, so restart recovery never hides
    the more specific failure the interrupted job already recorded.
    """
    row = summary_row(result)
    with _SUMMARY_LOCK:
        existing_rows = _read_summary_rows(path)
        rows = [
            existing for existing in existing_rows
            if existing.get('result_id') != row['result_id']
        ]
        if not replace and len(rows) != len(existing_rows):
            return
        rows.append(row)
        _write_summary_rows(path, rows)


def remove_summary_rows(path: Path, fruit_id: str) -> None:
    with _SUMMARY_LOCK:
        rows = _read_summary_rows(path)
        kept = [row for row in rows if row.get('fruit_id') != fruit_id]
        if len(kept) != len(rows):
            _write_summary_rows(path, kept)


def reset_summary(path: Path) -> None:
    with _SUMMARY_LOCK:
        _write_summary_rows(path, [])
