Eten0721/PassionFruit_IoT_hardware/Django_Server/fruit_app/reason_text.py

"""Shared Dashboard reason-code descriptions."""

REASON_TEXT = {
    'active_fruit_exists': '目前仍有未處理的本輪資料',
    'auto_run_active': '自動運轉中',
    'camera_busy': '照片上傳中',
    'camera_not_ready': '手機拍攝端未就緒',
    'capture_incomplete': '三張照片尚未完成',
    'classifier_busy': '分類器執行中',
    'dataset_operation_in_progress': '資料處理中',
    'detection_in_progress': '檢測進行中',
    'detection_mode': '自動檢測由模型判級，不開放人工分類',
    'esp32_offline': 'ESP32 已離線，Gate 3 維持關閉',
    'sorter_capability_missing': 'Firmware 缺少安全分槽能力',
    'gate3_boot_unconfirmed': 'Gate 3 狀態需人工安全復原',
    'network_recovery_required': '待完成網路安全復原',
    'result_not_saved': '檢測結果尚未保存成功',
    'dataset_busy': '資料處理中',
    'no_detection_result': '沒有待處理的檢測結果',
    'feed_arrival_unconfirmed': '送料到位尚未確認',
    'gate3_manual_removal_required': 'Gate 3 待人工安全復原',
    'network_selection_required': '尚未確認本次使用的網路',
    'network_recovery_in_progress': '安全復原進行中，等待 ESP32 歸位與清鎖交握',
    'no_active_fruit': '沒有待分類的資料',
    'pending_motor_command': '有待執行的馬達命令',
    'photo_only_required': '目前不是純拍攝',
    'sorter_recovery_required': '分類器待人工復原',
    'system_not_idle': '系統尚未閒置',
    'temp_fruit_exists': '暫存區仍有未處理資料',
    'line_credentials_missing': '尚未設定通知憑證，請聯絡專案擁有者',
    'line_credentials_unreadable': '通知憑證無法讀取，請聯絡專案擁有者',
    'line_credentials_invalid': '通知憑證必須是有效的 JSON 物件，請聯絡專案擁有者',
    'line_credentials_incomplete': '通知憑證欄位不完整，請聯絡專案擁有者',
    # 開始、切換與人工操作的停用原因
    'already_manual_graded': '本輪已人工判級',
    'auto_run_must_be_stopped': '請先停止拍攝',
    'auto_trigger_disabled': '自動觸發已停用',
    'duplicate_trigger_waiting_start_sequence': '上一筆觸發仍在等待開始拍攝',
    'hardware_mode_required': '目前不是使用硬體模式',
    'not_detection_mode': '目前不是自動檢測模式',
    'not_needs_review': '本輪已由模型判級，不需人工處理',
    'hardware_abandon_requires_discard': '使用硬體時請改用安全復原移除果實',
    'stale_detection_result': '畫面上的檢測結果已過期，請重新整理',
    'operator_abandoned': '操作員已放棄本輪',
    # ESP32 與送料
    'feeder_capability_missing': 'ESP32 韌體缺少送料功能',
    'feeder_sensor_not_clear': 'HC-SR04 感測區有東西，請先清空',
    'feeder_sensor_unavailable': 'HC-SR04 沒有有效回音，請檢查接線',
    'feeder_state_not_idle': '送料機構尚未停止',
    'feeder_timing_not_applied': 'ESP32 尚未套用最新硬體參數',
    'feeder_max_run_timeout': '送料超過最長運轉時間，進料未確認',
    'hcsr04': 'HC-SR04 偵測到果實後停止',
    'max_run_timeout': '達到送料最長運轉時間',
    'esp32_setup_active': 'ESP32 正在設定網路',
    'esp32_not_idle': 'ESP32 尚未安全閒置，暫時不能設定網路',
    'esp32_start_timeout': 'ESP32 沒有在時限內開始動作',
    'esp32_timeout': 'ESP32 回應逾時',
    'hardware_timeout': '硬體動作逾時',
    'motor_error': '馬達動作失敗',
    'esp32_restarted': 'ESP32 重新啟動',
    'esp32_restarted_during_feed': 'ESP32 在送料途中重新啟動',
    'esp32_restarted_during_capture': 'ESP32 在拍攝途中重新啟動',
    'esp32_restarted_during_sorter': 'ESP32 在分槽途中重新啟動',
    'esp32_restarted_while_gate3_waiting': 'ESP32 在 Gate 3 等待時重新啟動',
    'django_restarted_during_sorter': 'Django 在分槽途中重新啟動，請檢查 Gate 3 與分類器',
    # 分類器
    'classifier_timeout': '分類器動作逾時',
    'classifier_attach_failed': '分類器馬達無法啟動',
    'gate3_release_failed': 'Gate 3 放行失敗',
    'invalid_classification_code': '分類代碼無效',
    'sorter_command_slot_busy': '分類命令仍在執行',
    'sorter_recovery_clear_failed': '無法清除分類器復原紀錄',
    'gate3_recovery_clear_failed': '無法清除 Gate 3 復原紀錄',
    # 網路
    'network_capability_missing': 'ESP32 韌體尚未支援目前的網路協定',
    'network_local_dashboard_required': '這項操作只能在電腦上的 Dashboard 執行',
    'network_origin_mismatch': '連線位址與本次選擇的網路不符',
    'network_source_invalid': '連線來源無效',
    'network_subnet_mismatch': '裝置不在本次選擇的網段',
    'network_selection_stale': '網路介面已變更，請重新確認網路',
    'network_changed': '網路已變更，請重新確認',
    'network_inventory_pending': '正在讀取網路介面',
    'network_inventory_failed': '無法讀取網路介面',
    'network_monitor_start_failed': '網路監測無法啟動',
    'no_connected_network': '電腦沒有已連線的網路',
    'network_discovery_pending': '正在啟動裝置探索',
    'network_discovery_registration_failed': '裝置探索服務啟動失敗',
    'network_discovery_unavailable': '裝置探索無法使用',
    'multiple_controllers_found': '發現多個控制端，請關閉多餘的 Django',
    'controller_not_found': 'ESP32 找不到控制端',
    'discovery_timeout': 'ESP32 探索控制端逾時',
    'waiting_for_report': '等待 ESP32 回報',
    'network_identity_mismatch': 'ESP32 連到的不是這次啟動的控制端',
    'network_server_not_serving': '控制端尚未開始服務',
    'network_info_unavailable': '無法取得控制端資訊',
    'network_info_invalid': '控制端資訊無效',
    'network_persist_failed': '無法保存網路設定',
    # 網路安全鎖與復原
    'camera_connection_lost': '手機拍攝端連線中斷',
    'esp32_connection_lost': 'ESP32 連線中斷',
    'esp32_network_interlocked': 'ESP32 斷線後已鎖定馬達',
    'esp32_interlocked': 'ESP32 已鎖定馬達',
    'network_interlocked': '網路安全鎖啟動中',
    'network_recovery_confirmation_required': '請先確認安全復原',
    'network_recovery_not_required': '不需要安全復原',
    'network_recovery_ack_mismatch': 'ESP32 復原回報不符',
    'network_recovery_ack_timeout': 'ESP32 復原回報逾時',
    'recovery_persist_failed': '無法保存復原狀態',
    # 拍攝、資料與檢測
    'camera_upload_timeout': '手機上傳照片逾時',
    'upload_timeout': '照片寫入逾時',
    'detection_timeout': '檢測逾時',
    'detection_job_crashed': '檢測程序意外中止',
    'capture_options_invalid': '本輪拍攝設定紀錄有誤',
    'dataset_commit_failed': '照片保存狀態不確定',
    'dataset_options_invalid': '工作模式紀錄損壞',
    'result_not_found': '找不到檢測結果',
    'result_json_save_failed': '檢測結果檔保存失敗',
    'summary_save_failed': '檢測總表保存失敗',
    'roi_not_detected': '找不到果實位置',
    'roi_result_missing': '缺少果實位置結果',
    'roi_unavailable': '果實位置模型無法使用',
    'batch_unavailable': '檢測模型無法使用',
    'detection_incomplete': '檢測未完成',
    'model_inference_failed': '模型推論失敗',
    'grade_model_failed': '判級模型執行失敗',
    'color_class_unknown': '色澤分類結果無法辨識',
    'wrinkle_class_unknown': '皺褶分類結果無法辨識',
    'service_restarted': '伺服器重新啟動，本輪中斷',
    # LINE 通知
    'not_graded': '尚未判級',
    'not_processing': '不是加工果',
    'no_images': '沒有可用照片',
    'notifications_disabled': '通知已關閉',
}

# Status words that are not reason codes but still appear on the main screen.
STATUS_TEXT = {
    'waiting': '等待中',
    'pending': '啟動中',
    'advertising': '已啟動',
    'unavailable': '無法使用',
    'discovery_conflict': '發現多個控制端',
    'round_trip_complete': '已完成',
    'waiting_for_report': '等待回報',
    'allowed': '可設定',
    'blocked': '暫時不能設定',
    'unknown': '無法確認',
}


def describe(code):
    """Chinese text for a reason code; mirrors reasonText() in dashboard.js."""
    if not code:
        return ''
    base = str(code).split(':', 1)[0].strip()
    return REASON_TEXT.get(base, '其他狀態，詳見診斷區')
