Eten0721/PassionFruit_IoT_hardware/Django_Server/fruit_app/urls.py

from django.urls import path

from . import views


urlpatterns = [
    path('', views.home_view, name='home'),
    path('camera/', views.camera_view, name='camera'),
    path('dashboard/', views.dashboard_view, name='dashboard'),
    path('api/network/', views.network_api, name='network_api'),
    path('api/network/info/', views.network_info_api, name='network_info_api'),
    path('api/network/qr.svg', views.network_qr_api, name='network_qr_api'),
    path('api/network/setup_qr.svg', views.network_setup_qr_api, name='network_setup_qr_api'),
    path('api/network/setup_request/', views.network_setup_request_api, name='network_setup_request_api'),
    path('api/state/', views.state_api, name='state_api'),
    path('api/camera/state/', views.camera_state_api, name='camera_state_api'),
    path('api/camera/diagnostics/', views.camera_diagnostics_api, name='camera_diagnostics_api'),
    path('api/set_counter/', views.set_counter_api, name='set_counter_api'),
    path('api/collection_options/', views.collection_options_api, name='collection_options_api'),
    path('api/photo_capture/', views.photo_capture_api, name='photo_capture_api'),
    path('api/auto_run/', views.auto_run_api, name='auto_run_api'),
    path('api/feeder/test/', views.feeder_test_api, name='feeder_test_api'),
    path('api/feeder/finish_wait/', views.finish_feeder_wait_api, name='finish_feeder_wait_api'),
    path('api/runtime/reset/', views.runtime_reset_api, name='runtime_reset_api'),
    path('api/esp32_trigger/', views.esp32_trigger_api, name='esp32_trigger_api'),
    path('api/esp32/command/', views.esp32_command_api, name='esp32_command_api'),
    path('api/esp32/heartbeat/', views.esp32_heartbeat_api, name='esp32_heartbeat_api'),
    path('api/esp32/report/', views.esp32_report_api, name='esp32_report_api'),
    path('api/recapture/', views.recapture_api, name='recapture_api'),
    path('api/capture_started/', views.capture_started_api, name='capture_started_api'),
    path('api/upload_images/', views.upload_images_api, name='upload_images_api'),
    path('api/classify/', views.classify_api, name='classify_api'),
    path('api/discard/', views.discard_api, name='discard_api'),
    path(
        'api/detection/manual_grade/',
        views.manual_grade_api,
        name='manual_grade_api',
    ),
    path('api/notification/', views.notification_api, name='notification_api'),
    path('api/trend_alerts/', views.trend_alerts_api, name='trend_alerts_api'),
    path('api/trend_alerts/test/', views.trend_alert_test_api, name='trend_alert_test_api'),
    path('api/detection/stats/', views.detection_stats_api, name='detection_stats_api'),
    path('api/assistant/', views.assistant_api, name='assistant_api'),
    path('api/assistant/icon/', views.assistant_icon_api, name='assistant_icon_api'),
    path('api/assistant/icon.png', views.assistant_icon_image, name='assistant_icon_image'),
    path('api/reset_dataset/', views.reset_dataset_api, name='reset_dataset_api'),
    path('api/image/<str:fruit_id>/<str:filename>/', views.dataset_image_api, name='dataset_image_api'),
    path(
        'api/detection/image/<str:fruit_id>/<str:filename>/',
        views.detection_image_api,
        name='detection_image_api',
    ),
    path('api/export_detection/', views.export_detection_api, name='export_detection_api'),
    path('api/open_dataset_folder/', views.open_dataset_folder_api, name='open_dataset_folder_api'),
    path('api/webrtc/offer', views.webrtc_offer_api, name='webrtc_offer_api'),
    path('api/webrtc/answer', views.webrtc_answer_api, name='webrtc_answer_api'),
    path('api/webrtc/ice', views.webrtc_ice_api, name='webrtc_ice_api'),
    path('api/webrtc/state', views.webrtc_state_api, name='webrtc_state_api'),
]
