Eten0721/PassionFruit_IoT_hardware/firmware/tests/control_network_test.cpp

#include "CaptureController.h"
#include <iostream>
#include <functional>

#undef assert
#define assert(condition) ((condition) ? static_cast<void>(0) : Fake::fail(#condition, __LINE__))

static void tickAt(CaptureController& controller, uint32_t time) {
  Fake::now = time;
  const int sensorReads = Fake::sensorReads;
  controller.tick();
  assert(millis() == time + (Fake::sensorReads - sensorReads) * Fake::sensorLatencyMS && "HTTPS waiting must not advance the control clock");
  std::this_thread::sleep_for(std::chrono::milliseconds(2));
}

static void pumpUntil(CaptureController& controller, const std::function<bool()>& ready) {
  for (int attempt = 0; attempt < 200 && !ready(); ++attempt) tickAt(controller, millis() + 10);
  assert(ready());
}

static int outputCount(int pin, int value) {
  int count = 0;
  for (const auto& output : Fake::outputs) if (output.pin == pin && output.value == value) ++count;
  return count;
}

static uint32_t lastOutputAt(int pin, int value) {
  for (auto it = Fake::outputs.rbegin(); it != Fake::outputs.rend(); ++it) {
    if (it->pin == pin && it->value == value) return it->at;
  }
  assert(false && "Expected actuator output is missing");
  return 0;
}

static std::vector<Fake::Request> reports(const std::string& event) {
  std::vector<Fake::Request> matches;
  for (const auto& request : Fake::requestSnapshot()) {
    if (request.method == "POST" && request.body.find("event=" + event + "&") == 0) matches.push_back(request);
  }
  return matches;
}

static std::string command(const std::string& name, int id, const std::string& fields = "") {
  return "command=" + name + "\ncommand_id=" + std::to_string(id) + "\n" + fields;
}

static uint32_t startFeed(CaptureController& controller, const char* context = "calibration") {
  Fake::enqueue({200, command("feed_one", 1, std::string("feed_context=") + context + "\n")});
  controller.begin();
  pumpUntil(controller, [] { return outputCount(23, 1300) == 1; });
  return lastOutputAt(23, 1300);
}

static void holdWorker() {
  {
    std::lock_guard<std::mutex> lock(Fake::mutex);
    Fake::holdWiFi = true;
  }
  std::unique_lock<std::mutex> lock(Fake::mutex);
  assert(Fake::changed.wait_for(lock, std::chrono::seconds(1), [] { return Fake::workerInWiFi; }));
}

static void delayedCommandKeepsReadingSensor() {
  Fake::nvs.clear();
  Fake::reset();
  Fake::enqueue({200, "command=none\nauto_trigger_enabled=0\n", "", true});
  CaptureController controller;
  controller.begin();
  pumpUntil(controller, [] { return Fake::requestSnapshot().size() == 1; });
  const uint32_t started = millis();
  const int initialReads = Fake::sensorReads;
  for (uint32_t elapsed = 50; elapsed <= 400; elapsed += 50) tickAt(controller, started + elapsed);
  assert(Fake::sensorReads >= initialReads + 8);
  assert(Fake::requestSnapshot().size() == 1 && "Only one in-flight request is allowed");
  Fake::unblock();
}

static void stalledWorkerCannotDelayFeederStop(const std::string& reason, uint32_t initialTime = 100) {
  std::cout << "  " << reason << " start=" << initialTime << '\n';
  Fake::nvs.clear();
  Fake::reset(initialTime);
  CaptureController controller;
  const uint32_t started = startFeed(controller);
  holdWorker();
  if (reason == "max_run_timeout" || reason == "boundary") {
    tickAt(controller, started + 4999);
    assert(outputCount(23, 1500) == 1);
    if (reason == "boundary") Fake::echoUS = 290;
    tickAt(controller, started + 5000);
    assert(lastOutputAt(23, 1500) - started == 5000);
  } else {
    Fake::echoUS = reason == "hcsr04" ? 290 : 0;
    tickAt(controller, started + 50);
    assert(lastOutputAt(23, 1500) - started == 50);
  }
  assert(outputCount(23, 1300) == 1);
  const auto sensorReadsAtStop = Fake::sensorReads;
  tickAt(controller, millis() + 50);
  assert(Fake::sensorReads > sensorReadsAtStop);
  Fake::unblock();
  const std::string event = reason == "hcsr04" ? "feed_cycle_completed"
      : reason == "unavailable" ? "feeder_sensor_unavailable" : "feeder_max_run_timeout";
  pumpUntil(controller, [&] { return !reports(event).empty(); });
  const auto report = reports(event).front();
  assert(report.body.find("command_id=1") != std::string::npos);
  assert(report.body.find("feeder_elapsed_ms=" + std::string(reason == "hcsr04" || reason == "unavailable" ? "50" : "5000")) != std::string::npos);
}

static void terminalReportRetryDoesNotRepeatFeed() {
  Fake::nvs.clear();
  Fake::reset();
  CaptureController controller;
  const uint32_t started = startFeed(controller);
  Fake::enqueue({-11, "", "", true});
  tickAt(controller, started + 5000);
  pumpUntil(controller, [] { return reports("feeder_max_run_timeout").size() == 1; });
  const auto sensorReads = Fake::sensorReads;
  for (int count = 0; count < 20; ++count) tickAt(controller, millis() + 50);
  assert(Fake::sensorReads == sensorReads + 20);
  assert(reports("feeder_max_run_timeout").size() == 1);
  assert(outputCount(23, 1500) == 2);
  Fake::enqueue({200, "{}", "close"});
  Fake::unblock();
  pumpUntil(controller, [] { return reports("feeder_max_run_timeout").size() == 2; });
  const auto retried = reports("feeder_max_run_timeout");
  assert(retried[0].body == retried[1].body);
  assert(retried[0].timeout == 5000 && retried[1].timeout == 5000);
  Fake::enqueue({200, command("feed_one", 1, "feed_context=calibration\n")});
  for (int count = 0; count < 40; ++count) tickAt(controller, millis() + 50);
  assert(outputCount(23, 1300) == 1);
  std::lock_guard<std::mutex> lock(Fake::mutex);
  assert(Fake::connectionStops >= 2);
}
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
