Eten0721/PassionFruit_IoT_hardware/(commit log)

2026-07-06 v1.0, data_collection, 連續拍攝六張照片
2026-07-06 v1.1, 已更新階梯式拍攝架構相關文件說明
2026-07-07 v1.1, 硬體開發測試, 三個SG90+HCSR04可以在外接電池的情形下正常運行
2026-07-07 v1.1.1, 照片蒐集系統, 初版
2026-07-07 v1.1.2, 速度優化
2026-07-08 v1.1.3, 馬達時間修正
2026-07-08 v1.1.4, 第一張照片延遲優化
2026-07-08 v1.1.5, 自動觸發交握延遲優化
2026-07-08 docs文件修改: 同步 v1.1.5 照片蒐集流程文件
2026-07-10 v1.1.6, 首站捷徑、停穩設定與預覽體驗重構
2026-07-10 v1.1.6, 強化刪除復原、持久化校正設定與安全稽核
2026-07-10 v1.1.7, Django與ESP32效能、狀態管理和輪詢最佳化
2026-07-11 v1.1.8, 參數校正與硬體開發紀錄撰寫
2026-07-12 v1.1.9, 1.1版本最終版_階梯式拍攝與照片蒐集系統
2026-07-12 1.2.0, 新增MG996R馬達
2026-07-13 v1.2.1, 新增可調整的MG996R命令輪詢間隔
2026-07-13 v1.2.2, README的補充與.env Django密鑰更新
2026-07-13 v1.2.3, 補充決策層與ESP32快速部署資源
2026-07-14 v1.2.4, docs文件更新
2026-07-14 v1.2.5, 文件維護
2026-07-15 v1.2.6, 重整外部模型工作區與整合文件
2026-07-16 v1.2.7, 更新實地考察分類級距與資料
2026-07-21 v1.2.8, 統一分類協定、重排角度與保存實地資料快照
2026-07-21 v1.2.9, 實地考察後的文本全面修正
2026-07-21 v1.2.10, 程式碼優化
2026-07-22 v1.2.11, 一票否決制取消_文本修正
2026-07-26 v1.2.12, 文本維護與大量翻修
2026-07-26 新增送料自動運轉規格
2026-07-27 實作送料校正與單次測試 (#4)
2026-07-27 補充深模組設計規則
2026-07-27 issue#5 完成
2026-07-27 issue#6 完成
2026-07-27 issue#7 完成
2026-07-29 轉折點-1, 送料由時間計時管理
2026-07-29 issue#9 文件規格更新
2026-07-29 issue#9 完成
2026-08-03 SG90升級為MG996R的文件更新
2026-08-08 送料機構架構修改
2026-08-08 issue#12 已完成
2026-08-08 v1.2.14, python運行環境變更_軟硬體開發環境一致化
2026-08-09 issue#11 正式自動送料已完成
2026-08-12 8/12-dashboard修復&測試送料重構&新增實驗記錄
2026-08-12 重新設計 Dashboard 操作介面與狀態呈現
2026-08-22 8/22, 硬體重構決策紀錄
2026-08-22 docs: 同步硬體重構後的專案說明
2026-08-22 8/22,硬體重構文件定稿
2026-08-24 8/24, issue#14 實作完畢
2026-09-27 fix: harden detection recovery and result state
    [detection.py, test_detection.py, views.py]
2026-09-27 v1.2.15, 拍攝系統demo簡化
2026-09-27 feat: bundle fixed detection weights for deployment (#18)
    [test_detection.py]
2026-09-28 fix: persist gate 3 recovery across restarts
    [dataset_store.py, test_detection.py, test_photo_only.py, views.py]
2026-09-28 fix: enable cleanup after photo detection
    [test_detection.py, tests.py, views.py]
2026-10-11 Keep ESP32 control responsive during HTTPS waits (#21)
2026-10-11 Implement local network confirmation and camera QR (#22)
2026-10-11 Complete Chrome camera acceptance and document hardware setup (#23)
2026-10-11 Implement ESP32 discovery and dynamic diagnostic communication (#24)
2026-10-13 Enforce dataset mode on every data request (#29)
    Requests that omit dataset_mode, and photo URLs without work_mode, are
    now rejected like a stale mode instead of falling through to the current
    mode. A corrupt dataset_options record also blocks starting a capture
    (including ESP32 triggers), capture_started and photo upload, not only
    Dashboard operations. The Dashboard no longer sends "undefined" when
    opening the data folder before its first state load. The deployment doc
    links to the partition spec instead of restating it.
2026-10-13 Grade photo-only detection with two-stage XGBoost and save JSON/CSV (#30)
    After the four YOLO models, each view's 13 raw + 3 derived features go
    through the delivered two-stage XGBoost (stage 1 threshold 0.5, stage 2
    mapped to low/medium/high); the fruit takes the worst view. Missing ROI,
    model output or invalid features mark the fruit as needing manual review
    instead of filling zeros.
    result.json now carries contract_version 1, a result_id fixed at session
    start, separate inference/classification/storage/sorting states, per-view
    features and grades and model SHA-256 versions. detection_summary.csv keeps
    one row per result_id, records failed rounds, and never reports a failed
    save as comple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
2026-10-13 Harden ESP32 setup hotspot and Wi-Fi reconnect
    - Add setup cancel (page button or BOOT) and a 10 min idle timeout that
    restores the saved Wi-Fi, so an abandoned hotspot no longer strands
    the machine.
    - Accept setup requests only from the softAP interface (403 setup_ap_only).
    - Require a fresh GOT_IP event before saving a candidate; fail fast with
    wifi_auth_failed / wifi_ssid_not_found on definitive disconnect reasons.
    - Reconnect the saved network when it drops during setup; reduce AP
    channel hopping with a scanned channel hint.
    - Report setup_ap_failed to Django via setup_failure and retry automatic
    setup every 30 s; Dashboard shows the reason.
    - Let ensureWiFi own all STA retries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
2026-10-13 Apply detection dashboard layout with real progress and photo interval (#31)
    - Collapsible operation bar below network confirmation; start/recapture/skip
    and their blocking reasons stay visible when collapsed.
    - Main area shows three photos x four model cells; each saved original sits
    in its ROI cell until the real ROI artifact replaces it. Backend publishes
    detection_progress after each stage's artifacts are saved.
    - Right column shows the prominent whole-fruit grade (or needs-review) above
    the phone preview; collection mode shows only the three originals.
    - Photo-only detection waits 1000 ms after photos 1 and 2 are saved
    (photo_interval state) before requesting the next one, rel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
2026-10-13 Clear saved photo-only detection temp and simplify operation bar (#31)
    - After result.json and the summary row are saved, photo-only detection
    removes its temp originals (results/ already holds them); restart cleans
    any leftover. Skip/delete no longer removes saved detection results; it
    only handles temp and unsaved partial output.
    - Operation bar gets a +/- disclosure toggle; blocking reasons show only
    when expanded and as tooltips on disabled buttons.
    - The global message line shows only operator-action feedback and clears
    itself, instead of repeating the backend status text.
2026-10-13 Let operators grade needs-review photo-only rounds manually (#32)
    When the model cannot grade a photo-only detection round, the result card
    (visible even with the operation bar collapsed) shows the failure reasons
    and four manual grade buttons. POST /api/detection/manual_grade/ checks
    dataset_mode, fruit_id and result_id against the current saved
    needs-review result, then updates the same result.json and summary row:
    - classification becomes graded with source=manual and decided_at; the
    model's needs_review outcome moves unchanged to model_classification,
    and inference, images and per-view grades keep the failure evidence.
    - status is manual_completed with complete=false and the origina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
2026-10-14 Allow abandoning needs-review rounds; drop unused detection label folders (#32)
    - The manual takeover card gets "放棄本輪（不分級）" (with confirm). The
    same API accepts abandon=true: classification becomes abandoned with
    source=manual and reason operator_abandoned, status manual_abandoned;
    photos, model_classification and failure reasons stay in the same
    result.json and summary row. Identical repeats are duplicates; switching
    between abandon and a grade is rejected as already_manual_graded.
    - Only the collection partition keeps the four label folders and
    metadata.csv. Detection no longer creates or resets them, and on start
    removes empty label folders and a header-onl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
2026-10-14 Route AI and manual grades through safe sorting for continuous detection (#33)
    Saved detection results (model or operator grade) now enter the existing
    classify_fruit boundary once, after JSON/CSV commit. The next feed only
    follows a matching sorter completion while auto-run and all safety
    conditions still hold. Manual takeover in hardware mode reuses the same
    path and cannot bypass disconnect or sorter recovery locks. The dashboard
    separates graded, saved, sorting, sorted/failed and recovery states.
    Also refresh the feeder sensor state before the network-recovery early
    return so a stale "blocked" reading no longer prevents the post-recovery
    feed, and update the host harness stubs to compil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
2026-10-14 Farmer-friendly notification format and simplified dashboard (#34)
    Notification text now uses the |瑕疵通知| layout: detection time, grade,
    and the union of defects found across completed views, with insect_track
    named 畫圖蟲 and the fruit id kept out of the message. Farmer markings use
    fixed high-contrast colours drawn from real masks and boxes, with outlined
    legend swatches.
    Dashboard hides directory paths and the empty message bar, reorders the
    bottom panels, adds an ESP32 connection badge, and hides diagnostics
    behind a double-click on the page title.
2026-10-14 Update power supply wiring notes
2026-10-14 Show anthracnose as 炭疽病 in farmer notifications (#34)
2026-10-14 Deliver processing-fruit LINE notifications via Cloudinary with durable retry (#35)
    Saved final processing results (model or manual) are queued in a durable
    outbox keyed by result_id and delivered by a background worker started with
    runsslserver: the composite is uploaded once to Cloudinary and LINE receives
    text + image in one push. Each entry keeps one X-Line-Retry-Key written ahead
    of the request, so timeouts, restarts and unrecorded deliveries resolve via
    409 instead of resending; outcomes still unconfirmed past the retry-key
    window become "uncertain" and are never resent. Failures never block
    detection, manual takeover or sorting.
    Per-mode switches (both default off) pause existing ent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
2026-10-14 Send LINE notification as one Flex bubble and drop the grade line (#35)
    Text and composite now arrive as a single Flex bubble: the composite as the
    hero image (Cloudinary 960 px rendition, real aspect ratio, tap opens the
    full image) with the notification lines below, and an altText summary for
    the notification preview. Every notification is a processing fruit, so the
    "等級" line is removed; manual decisions keep a "判定方式：人工判定" line.
    Also drop the stale #33 open-work entry from CURRENT_STATUS.
2026-10-14 Verify integrated grading, sorting and notification flow (#36)
    Hardware rounds dropped the LINE queue notice once sorting started, so an
    outbox write failure was invisible to the operator. The notice is now
    appended inside the sorting start for both model and manual grades, and
    integration tests show a failed enqueue never blocks classify_fruit or the
    next feed.
    The Wi-Fi setup host harness raced on the fake's poll-driven GOT_IP event;
    emit it explicitly so the save-failure case is deterministic.
2026-10-14 Move model checkout out of the repo and fold external/ and 環境部署/ docs into docs/
    The model repository now lives beside this one at D:\ps-quality-detection-system
    instead of nesting under external/. The ESP32 flashing guide moves to
    docs/ESP32燒錄指南.md, the model checkout notes become docs/模型開發環境.md, and
    the whole local 環境部署/ folder is ignored.
2026-10-14 Add Dashboard ESP32 setup controls and simplify operator UI
    - Dashboard: setup-page QR Code (http://192.168.4.1/) and a
    "開啟 ESP32 設定熱點" button that relays a remote BOOT press via
    setup_requested; the ESP32 still runs its safe-idle check and the
    motion=setup grant.
    - Firmware: name the safe-idle condition that blocks setup
    (setup_blocked: <reason>) and report it as setup_block_reason;
    Dashboard shows esp32_not_idle:<reason>.
    - Remove the redundant operator alert box and the error line; the
    reason moves to the state badge tooltip and the Gate 3 safety steps
    to the "安全復原" confirm dialog.
    - Shorten the Gate 3 recovery button label, say 手機 instead of iPhone,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
2026-10-14 Unstick network safety lock recovery
    - Record ESP32 feeder/sorter capability and feeder state on command
    polls during a lock, so a Django restart no longer leaves them empty.
    - Photo-only mode no longer relocks Django from the device's own
    network_interlocked report; hardware mode still locks and requires
    the recover_network homing handshake.
    - LINE notification toggle bypasses the network lock (no hardware).
    - Expose network_recovery_confirm_disabled_reason and show it in the
    start guidance; recovery needs only cleanup, network, camera and an
    online ESP32, not HC-SR04 or timing sync.
2026-10-14 Accept ADR-0020 with data/motor lock rules
2026-10-14 Centralize network recovery into a single policy module (#37)
    Implements ADR-0020. network_recovery.Policy owns the lock lifecycle,
    marker persistence, the recover_network handshake and a single
    mode-aware "what does the current lock block" decision; views,
    network_required and the state payload only read it.
    - Split the lock into a data lock (manual cleanup in any mode) and a
    motor lock (ESP32 interlock, hardware mode only, cleared only by the
    homing handshake). Motor-lock recovery needs an online ESP32 and
    manual confirmation, not the phone camera.
    - Allow switching to photo-only while the motor lock is pending; it
    re-applies when hardware mode returns.
    - Allow network reselection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
2026-10-15 Add Windows double-click launcher for non-technical users (#38)
    啟動系統.bat finds or silently installs Miniforge, creates the PF env,
    then hands off to scripts/launch.py, which installs dependencies only
    when a stamp digest is stale (cu128 or CPU torch chosen via nvidia-smi),
    checks LFS models, LINE credentials, firewall rules and port 8000, runs
    manage.py check, starts runsslserver and opens the dashboard.
    首次設定防火牆.bat applies the documented firewall rules via UAC.
2026-10-15 Document double-click launcher, Release ZIP and ADR-0021 (#39)
    Rewrite deployment guide sections 1-3 and 6-8 around 啟動系統.bat and
    首次設定防火牆.bat, add section 9 for manual dev setup and publishing
    Releases with LFS objects in archives, add README quick start, record
    ADR-0021 (launcher + Release ZIP instead of Docker) and status note.
2026-10-15 Detect unusable port 8000 with a bind test in the launcher (#42)
    The launcher only connected to 127.0.0.1:8000, so it missed WinError
    10013 when another program's connection happened to use local port 8000
    (this machine's dynamic port range starts at 1024), and Django then
    exited with a generic "server exited" message. Probe the dashboard
    first, then bind 0.0.0.0:8000 the way runsslserver does (SO_REUSEADDR)
    and with default options, reporting port_in_use with the OS error.
2026-10-15 v1.2.16, 新增版本與 commit 格式規則 (#43)
    AGENTS.md 規定合併到 main 的 squash 標題使用 `vX.Y.Z, 中文說明`，
    每合併一個 PR 遞增一次，重大改版且發布 Release 時加第二碼；
    部署文件 9.2 的 Release 版本號改為引用此規則。
2026-10-15 v1.2.17, 還原完整部署文件並新增快速開始 (#44)
    #43 誤將部署文件整份換成不含 ESP32 的精簡版。還原完整版（保留
    9.2 的版本規則），精簡版另存為 docs/快速開始.md 並修正錨點與錯字，
    README 同時連結兩份文件。
2026-10-15 v1.3.0, LINE 憑證改向專案擁有者索取 (#45)
    完整部署文件 2.5、8 節不再指向 Google Drive，改為向專案擁有者索取
    並由其提供更新後的檔案。本版為雙擊啟動器與 Release ZIP 散布後的
    首個 Release。
2026-10-15 v1.3.1, 新增 Dashboard Gemini 助手 ADR (#46)
2026-10-15 v1.3.2, ADR-0022 趨勢提醒改為三層分工 (#47)
2026-10-15 v1.4.0, 新增 Dashboard Gemini 助手與瑕疵趨勢提醒 (#48)
2026-10-15 v1.4.1, 新增示範情境與重播 ADR (#49)
2026-10-16 v1.4.2, ADR-0023 預備資料放入檢測分區並預設計入純拍攝 (#50)
2026-10-16 v1.4.3, 統計與趨勢提醒直接讀取檢測分區 (#51)
2026-10-16 相機頁新增鏡頭選單並預設後置超廣角 (#52)
    三站間距改為 19 cm 後主鏡頭視角不足。相機頁取得權限後列出所有鏡頭供操作員選擇並記在該手機，未選過時自動選後置超廣角（排除同樣標示超廣角的前鏡頭），失敗時退回預設後鏡頭。相機頁 JS／CSS 加上版本參數，避免手機沿用舊靜態檔。
2026-10-16 v1.4.5, 追蹤 runtime_config 的小幫手圖示 (#53)
    runtime_config 改為只忽略內容，並將 assistant_icon.png 列為例外；
    憑證、待送、用量與硬體狀態檔維持不進 Git。
2026-10-16 v1.4.6, 加強助手提示注入防護 (#54)
2026-10-16 v1.4.7, 助手可回答趨勢提醒設定 (#55)
2026-10-16 v1.4.8, 趨勢提醒精簡為一則並更名奶蛋博士 (#56)
2026-10-16 v1.4.9, 控制台視覺改版 (#57)
    - 調整色票為統一綠調中性色，單一主色，陰影帶色調
    - 固定頂部列、狀態整合為儀表條、進度標籤改為步驟條
    - 判級卡放大結論字級並依狀態變色，檢測卡片加入骨架載入
    - 按鈕加入過渡與按壓回饋，數字與 ID 使用等寬字型
    - 加入 favicon、description 與 theme-color meta
    - 支援 prefers-reduced-motion，助手按鈕維持原本圓形圖示
2026-10-16 v1.4.10, 調整控制台細節並改良奶蛋博士互動 (#58)
    - 趨勢提醒「視窗天數」改名「最近幾天」，同步修正說明、部署文件與助手工具描述
    - 網路表單標籤獨立一列，選單與確認按鈕並排；操作列「＋」與主要按鈕同列
    - 標頭圖示與 favicon 改為百香果切面加蛋形角色的臉
    - 奶蛋博士按鈕可拖曳或用方向鍵移動，面板跟隨按鈕並可從遠端角落縮放，位置與大小記在瀏覽器
    - 助手改為 ChatGPT 風格：說明移入歡迎框、空對話顯示推薦問題、膠囊輸入框與圓形送出鍵
    - 移除 ESP32 網路設定中的 QR Code／GPIO 0 說明段落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
2026-10-17 v1.4.11, 原因碼中文對照表移至 Python，LINE 憑證狀態改用原因碼 (#60)
    - 新增 reason_text.py 作為原因碼中文的唯一來源，Dashboard 以 json_script 取得
    - notification_delivery 的 config_reason 改為 line_credentials_* 原因碼，缺欄位另列 config_missing_fields，不再含私密設定檔名稱
    - 更新對應測試與 CAPTURE_SPEC
    Refs #59
2026-10-17 v1.4.12, 新增手機相機診斷上報 API (#61)
    - 新增 POST /api/camera/diagnostics/：只接受白名單列舉、布林與整數，白名單外欄位丟棄，不合法或超過 4 KB 回 camera_diagnostics_invalid
    - 診斷只保存最新一筆於記憶體，切換網路時清除；get_camera_diagnostics() 供後續助手工具讀取，不加入 /api/state/
    - camera.js 只在開相機結果、track 結束與 RTC 狀態改變時上報最終結果，失敗不影響拍攝
    - 新增前後端測試並更新 CAPTURE_SPEC
    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
2026-10-17 v1.4.13, 奶蛋博士新增唯讀系統狀態工具 get_system_status (#62)
    - 回傳白名單狀態：工作模式、網路與配網、ESP32 連線與網路診斷、手機相機與診斷、異常與復原、各停用原因
    - 部署檢查：模型檔 ok／missing／lfs_pointer（只回檔名）、LINE 憑證原因碼與缺欄位
    - 重用 Dashboard 既有 helper，不呼叫 _state_payload、檔案同步、延遲刪除重試或 session timeout；Gemini 請求期間不持鎖
    - 系統規則新增查詢時機、硬體操作只轉述 Dashboard 提示、LINE 關閉時不主動提憑證
    - 新增測試並更新 CAPTURE_SPEC 與助手提示注入測試
    Refs #59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
2026-10-17 v1.4.14, 奶蛋博士推薦問題改為查詢系統狀態 (#63)
    把「怎麼啟動系統並連上手機相機？」換成「系統還有哪裡沒準備好？」，讓農夫一鍵觸發 get_system_status。
2026-10-17 v1.4.15, 版本號改寫在每個 commit 標題 (#64)
    AGENTS.md 版本規則：每個 commit 標題都帶 vX.Y.Z，PR 標題用同一字串；說明 squash 合併時單一 commit 沿用 commit 標題、多個 commit 沿用 PR 標題。刪除「分支內過程 commit 不帶版本號」。
2026-10-17 v1.4.16, README 補上 LINE 通知與奶蛋博士並更正檢測現況 (#65)
    - README：摘要、架構圖、已實作功能、待驗收與技術組成補上 XGBoost 判級、LINE 通知、趨勢提醒與奶蛋博士；刪除「不產生品質級距」「檢測不驅動實體分流」等過時描述
    - CURRENT_STATUS：奶蛋博士補上系統狀態查詢與待驗收情境
2026-10-17 v1.4.17, 總表寫入加重試並限制開啟資料夾為本機
    - detection_summary.csv 被占用時最多重試 5 次；仍失敗時提示關閉該檔（例如 Excel）
    - /api/open_dataset_folder/ 只接受本機 Dashboard，遠端裝置回 network_local_dashboard_required
    - 補兩項測試並更新 CAPTURE_SPEC
2026-10-17 v1.4.18, 合併 ESP32 重開機處理並統一原子寫入
    - esp32_command_api 的 4 個重開機分支改用 _stop_for_esp32_restart 共用停機欄位與 transition
    - 新增 dataset_store.atomic_write／atomic_write_text／atomic_write_json，含 Windows 占用重試與暫存檔清理
    - detection、views、motor_commands、capture_timing、trend_alerts、notification_delivery、assistant 改用共用寫入
2026-10-17 v1.4.19, 將 Dataset 檔案生命週期從 views 移至 dataset_store
    - counter、metadata、safe move／replace／unlink、discard、reset 與 recovery marker 檔案讀寫改由 dataset_store 以明確 root 提供
    - views 保留 HTTP 端點、工作模式、狀態機與復原決策；路徑檔名集中為 dataset_store 常數
    - 測試只更新 patch 與呼叫位置；PROJECT_CONTEXT 更新責任邊界
2026-10-17 v1.4.20, 防火牆檢查改用 netsh 避免誤報 (#66)
    部分電腦的 Get-NetFirewallRule 需要系統管理員才看得到規則，啟動器
    以一般權限執行時會誤報規則缺少。改以 netsh 依 DisplayName 檢查，
    找不到時結束碼非 0。
2026-10-17 v1.4.21, Dashboard 網路面板改兩欄並將 LINE 通知獨立成摺疊區
    - 確認網路面板改為左側選擇與狀態、右側相機 QR Code
    - LINE 加工果通知與瑕疵趨勢提醒移到「資料管理」上方的獨立摺疊區
    - 「目前流程與操作設定」改名為「模式設定」
    - ESP32 網路設定步驟精簡為三行，並同步更新文件中的操作位置
2026-10-17 v1.4.22, 主按鈕改為開始／停止拍攝並在自動檢測隱藏非必要操作
    - 主按鈕：開始拍攝／停止拍攝／正在完成目前果實；純拍攝顯示開始拍攝
    - 自動檢測模式下，重新拍攝與跳過／刪除只在可用時顯示
    - 同步更新提示訊息、規格、部署說明與接線驗收摘要中的按鈕名稱
2026-10-17 v1.4.23, 硬體參數改由 hardware_params.toml 設定並取消送料校正確認
    - 八項硬體參數改由 Django_Server/hardware_params.toml 提供，只在 Django 啟動時讀取並驗證，不合法就拒絕啟動
    - revision 由參數內容計算，ESP32 照舊在閒置時套用並回報 ACK，韌體不需修改
    - 移除 /api/capture_timing/、送料校正確認 API 與 feeder_calibrated 啟動條件
    - Dashboard 的停穩設定區改為唯讀，與診斷區一起預設隱藏、雙擊標題顯示，並把測試送料按鈕移到摘要列
    - 新增 ADR-0023 取代 ADR-0006，並同步更新規格與文件
2026-10-17 v1.4.24, 主畫面狀態原因改為只顯示中文
    - reason_text.py 補上約 100 個操作員看得到的原因代碼與狀態詞
    - 主畫面與伺服器訊息只顯示中文，未收錄的代碼顯示「其他狀態，詳見診斷區」
    - 原始代碼移到診斷區的「原因代碼」
    - 新增測試，確保停用、警示、網路與復原原因都有中文
    - 移除殘留的「送料校正」字樣
2026-10-17 v1.4.25, 新增檢測報告匯出並讓趨勢提醒附統計圖 (#67)
    * v1.4.25, 新增檢測報告匯出並讓趨勢提醒附統計圖
    - 資料管理在自動檢測模式新增「匯出檢測報告」：ZIP 內含統計圖、detection_summary.csv，可選擇附上 results/
    - 新增 detection_report 模組，以 detection_stats 的數字繪製統計圖並打包匯出
    - 趨勢提醒入列時凍結統計快照，送出前繪圖上傳，改以 Flex 訊息發送
    - ADR-0022 修訂：LINE 提醒附 Django 計算的統計圖，文字仍不帶數字
    - requirements 明列 matplotlib
    * v1.4.25, 簡化趨勢提醒設定並新增測試提醒
    -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
2026-10-18 v1.4.26, 三站與分類器初始角度及四級分類角度改由 hardware_params.toml 設定
    - 新增 gate1~3_home_angle、sorter_home_angle 與四個分類角度參數，Django 驗證 0～180 且閘門初始角度不得等於放行角度
    - ESP32 依設定記錄每站閘門 Home 與分類器角度，閒置歸位時套用，角度變更後先移至新 Home 並等待 500 ms
    - 韌體預設分類器角度改為 Home 45°、分類 15°／30°／60°／75° 以配合實機安裝
2026-10-18 v1.4.27, 修正 Django 狀態卡死並新增完全重置按鈕 (#68)
    - dataset_operation 改由 context manager 統一釋放，未預期例外不再永久 dataset_busy
    - capture_meta 非物件時不再讓已存照片卡在 uploading
    - 新增 uploading 寫檔 30 s 與檢測 180 s 逾時；檢測執行緒意外中止時標記失敗
    - 開發者模式新增「完全重置Django狀態以及ESP32網路設定」（POST /api/runtime/reset/，僅限本機）
    - reset_runtime_state_for_tests 更名為 reset_runtime_state
2026-10-26 v1.4.28, 更新實機照片並修正過時文件（站距、timing、ADR 狀態與供電）
    - README 開頭改用完整硬體實機圖，待完成清單註明機構已製作完成
    - 三站站距依實際製作改為 19 cm，拍攝 timing 推薦值改為 500 ms
    - ADR-0016 分類器 Home 改指向規格與 hardware_params.toml，更新實作現況
    - ADR-0018、ADR-0022 與 ADR 索引狀態改為已實作，修正索引表格斷行
    - CAPTURE_SPEC 網路章節移除尚未實作說法，CURRENT_STATUS 更新日期與製作現況
    - 供電文件補上 LM2596 供電 ESP32 與 LED 燈條，移除失效連結與對話口吻
2026-10-27 v1.4.29, 修正檢測跳過、安全復原與硬體參數同步
    新增硬體人工接手的跳過入口，保留檢測紀錄並以 ESP32 雙端歸位交握解除 Gate 3 鎖；修正分類逾時後仍停在 finishing 的狀態。
    持久保存遞增的硬體參數版本與綁定 ESP32 boot 的真實套用確認，避免 Django 重啟後同步卡住，並保持參數回復時版本遞增。補齊回歸測試與同步、復原及啟動器視窗生命週期規格。
    驗證：Django 509 項（505 通過、3 略過、1 項通知測試因環境缺少 pi_heif 而錯誤）；啟動器 36 項與 Dashboard 跳過／復原測試通過；正式 ESP32 編譯及 git diff --cached --check 通過。未燒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
2026-10-27 v1.4.30, 改善送料逾時提示並開放結束等待後切換設定
2026-10-27 v1.4.31, 整理硬體照片命名並新增 LM2596 與完整硬體照片
2026-10-27 v1.4.32, 更新實機驗收狀態、分類器實測角度並整理 record_image
    - CURRENT_STATUS／CAPTURE_SPEC 改為 2026-10-27 實機驗收通過，移除過時待驗證內容
    - hardware_params.toml 分類器角度改為實測值 160/140/150/170/180
    - 硬體接線與驗收摘要併入電源供應器接線注意事項，並修正所有引用與圖片路徑
    - 快速開始補充中文 Windows 使用者名稱導致安裝卡住的處理
2026-10-27 v1.4.33, README 改寫自動檢測流程並縮小實機圖，統一 LM2596 電壓
2026-10-27 v1.4.34, 移除 PROJECT_CONTEXT 併入 CAPTURE_SPEC 並新增文件寫作規則
    - 模組分工與不變原則精簡後移入 CAPTURE_SPEC「架構與不變原則」
    - AGENTS.md 文件維護改為「放在哪裡／怎麼寫」，並更新文件導覽
    - README、domain.md、模型開發環境、ADR-0010 改指新來源
2026-10-29 v1.4.35, 瑕疵比例只有單一時段時改畫長條圖
2026-10-29 v1.4.36, 新增 AI 助手、LINE 通知、Dashboard 與系統架構截圖並移除硬體端軟體狀態圖
