Eten0721/PassionFruit_IoT_hardware/record_image/實際硬體圖/IMG_5276.JPG

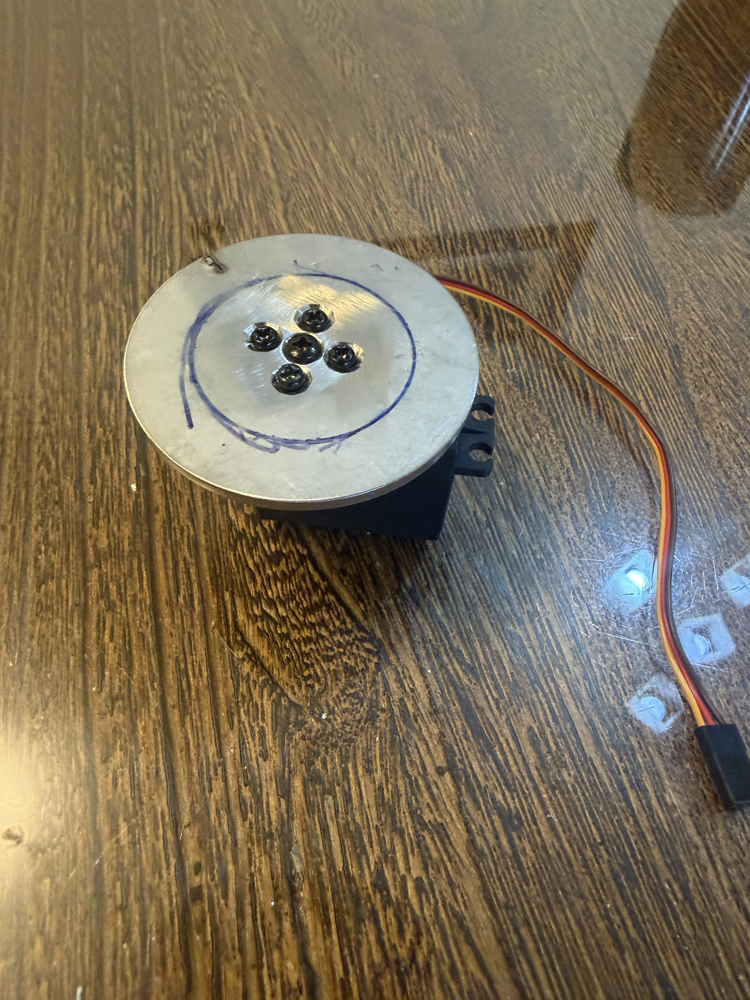
record_image/實際硬體圖/IMG_5276.JPG
